BlackAndWhiteSnaable/DC-DC/Report/appendix/PCB.tex

\chapter{Full PCB Design}
\label{app:LTSpice}
\vspace{-15mm}
\begin{figure}[H]
	\centering
	
\end{figure}
