BlackAndWhiteSnaable/DC-DC/Report/appendix/Driver_circuits.tex

\chapter{Driver circuits}
\label{app:DRIVER}
\vspace{-8mm}
\section{Driver circuits IN}
\begin{figure}[H]
	\centering
	
\end{figure}
\clearpage 
\section{Driver circuits OUT}
\begin{figure}[H]
	\centering
	
\end{figure}
