BlackAndWhiteSnaable/DC-DC/Report/sections/colophon.tex

\thispagestyle{empty}
{\small
\strut\vfill % push the content to the bottom of the page
\noindent Copyright \copyright{} Aalborg University 2018\par
\vspace{0.2cm}
\noindent \LaTeX \: was used for typesetting this report,
MatLab, Simulink, EAGLE and LTSpice were used for designing and verifying the converter and
GitHub for collaborating as a group.
}
\clearpage
