BlackAndWhiteSnaable/DC-DC/Report/sections/titlepages.tex

\pdfbookmark[0]{Abstract and Information}{label:titlepage_en}
\aautitlepage{%
  \englishprojectinfo{
    %title 
    Non-inverting Multilevel\\
    DC-DC Boost Converter For\\
    Photovoltaic Applications
  }{%
    Signal Processing%theme
  }{%
    Fall Semester 2018 %project period
  }{%
    ED5-3-F18 % project group %TODO
  }{%
    %list of group members
    Daniel Frederik Busemann\\
    Ilian Oleg Haralampiev\\
    Ivan Petrov Kulin\\
    Simon Thies
  }{%
    %ls
    Sanjeevikumar Padmanaban
  }{%
    1 % number of printed copies
  }{%
    \today % date of completion
  }%
}{%department and address
  \textbf{Electronics and Computer Engineering}\\
  Aalborg University\\
  \href{http://www.aau.dk}{http://www.aau.dk}
}{% the abstract
	This report focuses on developing and testing a suitable DC-DC converter for PV applications.
	
	The main goal is to analyse, simulate and compare different topologies and choose the most efficient one. The chosen topology has been tested in hardware as well, to determine its real world viability and how accurate simulations are compared to real measurements.
	The topology chosen has gain 6 times higher on all duty ratios compared to the conventional boost converter. 

	For simulation the tools used are SIMULINK and LTSpice. For the hardware test a custom PCB has been designed and printed with a SKYPER driver board being used to operate the circuit.
	
}
\cleardoublepage
