BlackAndWhiteSnaable/DC-DC/Report/sections/frontpage.tex

\newcommand{\HRule}{\rule{\linewidth}{0.5 mm}}
\begin{titlepage}

\begin{center}
% Upper part of the page
\iflanguage{danish}{%
	
}{%
	
}\\[0.5cm]

\textsc{\Large P5}\\[0.6cm]

% Title
\HRule \\[0.8cm]
{ \Huge \bfseries  Non-inverting Multilevel DC-DC Boost Converter}\\[0.4cm]

  \Large{For Photovoltaic Applications
  % insert your subtitle here
  }
\HRule \\[1.2cm]

% Author and supervisor
\begin{minipage}{0.49\textwidth}
\begin{flushleft} \large
\emph{Students:}\\
Danial Frederik Busemann\\
Ilian Oleg Haralampiev\\
Ivan Petrov Kulin\\
Simon Thies\\
\end{flushleft}
\end{minipage}
\begin{minipage}{0.49\textwidth}
\begin{flushright} \large
\emph{Supervisors:} \\
Sanjeevikumar Padmanaban
\end{flushright}
\end{minipage}

\vfill

% Bottom of the page
{\large \today}

\end{center}

\end{titlepage}
