BlackAndWhiteSnaable/DC-DC/Report/sections/content/01introduction.tex

\chapter{Introduction}\label{ch:introduction}

As the global interest in renewable energy increases,
the interest in photo voltaic (PV) arrays grows as well. 
Solar power is a growing source of renewable energy on a global scale \cite{Timetosh94:online}
This can be indicated by the growing interest power companies show in building PV parks. 
\cite{GSR2018:online}

When generating power with PV arrays,
the initial output is a DC power of varying voltage levels. 
To be able to input the generated power into the stable AC-grid,
without creating disturbances,
the same voltage and frequency as the grid needs to be output. 

\begin{figure}[H]
   \centering
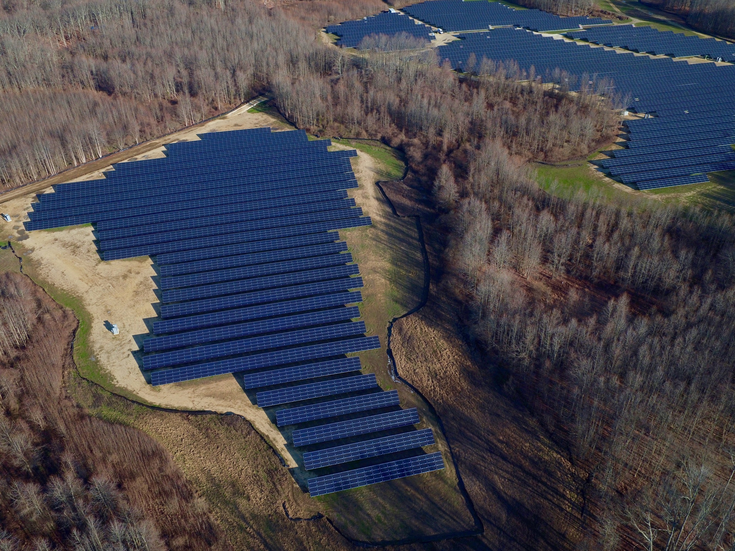
[picture p1: Report/figures/Problem/solarpark.jpg]
   
    \caption{12.8 MW Utility Project - the World's Largest Bifacial PV Installation in Eastern US \cite{Sunpreme29:online}}
	\label{fig:SolarPark}
\end{figure}
Commonly this is achieved by two devices,
a DC-DC boost converter (BC) to normalize the voltage
and an DC-AC inverter to generate AC power with the necessary frequency.

In this project we have a look at DC-DC boost converters.
The first part of the project is understanding and simulating common topologies.
The second part is understanding, simulating and building a new topology,
the 2NX Interleaved Boost Converter. \cite{Bhaskar2016}

\section*{Reading Guide}
For readers without an understanding of DC-DC converters,
it is recommended to read Chapter \ref{ch:CBC},
before reading the Chapters \ref{ch:SIBC}-\ref{ch:2Nx}
as these require a deeper understanding.
