BlackAndWhiteSnaable/DC-DC/Report/sections/content/aconventionalBoost.tex

\chapter{Conventional Boost Converter}\label{ch:CBC}
\todo[color=c01]{move this chapter to a section in physical setup}

\section{Switch ON}\label{sec:SON}

When the switch is ON, the inductor is being charged and the capacitor discharches over the load resistor.
