BlackAndWhiteSnaable/DC-DC/Report/sections/content/05Implementation/bDriverSkyper.tex

\vspace{-8mm}
\section{Driver}\label{sec:driver}
\vspace{-3mm}
To control the MOSFETs the Semikron SKYPER 32R driver board has been chosen. \cite{Board1SK17:online} It can run two MOSFETs or IGBTs potential free with up to 1200V over the device.
It supports an output of +15V/-7V PWM with peak currents to 15A at frequencies up to 50kHz.
The board also comes with additional protection logic that was not used as failure detection and shut down input.
The input to the board are two PWM signals coming from the controller with Voltages of 0 to 15V.
To function the SKYPER board needs an external power supply of 15V,
some decoupling capacitors and capacitors to filter high frequency pulses.
These components are on the adaptor board also from Semikron.

On the secondary side of the board the two potential free PWM signals with -7 to 15V are given out.\cite{SKYPER322:online}
To adjust the switching properties of the device the output can be configured by changing the resistors $R_{on}$ and $R_{off}$.
They limit the current when switching in the state, so the device will switch slower.
Additionally external decoupling capacitors are needed. They are also on the adaptor board.
The failure detection logic was not used for testing.
A schematic of the secondary side of the SKYPER board can be seen in Figure \ref{fig:Skyper32out}.

\begin{figure}[H]
   \centering
   
    \caption{Circuit on the output of the SKYPER 32R}
	\label{fig:Skyper32out}
\end{figure}
\clearpage
As the SKYPER Board needs an input signal of 15V a circuit is needed to convert the 5V signal from the low power logic.
Therefore a small op-amp based comparator circuit was constructed.
It compares the input signal to 1.5 Volts, so every input above will result in a high output,
all inputs below as low.
This also allows to run it from a logic that only outputs 3V signals.

In Figure \ref{fig:Skyper32in} it can be seen how the input coming from the control logic with a 5V PWM signal and 15V power supply are connected to the amplification board.
On there the signal gets raised to 15V PWM and the board also includes the pull-up resistor to read out the open collector error out pin of the SKYPER 32R.
The board connects to the adaptor board that has the required capacitors and a pull up resistor for the error in.
The adaptor board is connected to all the inputs of the SKYPER 32R.

\begin{figure}[H]
   \centering
   
    \caption{Input boards for the SKYPER 32R}
	\label{fig:Skyper32in}
\end{figure}
The SKYPER board is intended for IGBT bridge circuits and therefore has a function which switches both devices off, if the input tries to turn them both on.\cite{SKYPER322:online} Therefore a second identical circuit and board will be used to drive each of the MOSFETs.

\clearpage
