BlackAndWhiteSnaable/DC-DC/Report/sections/content/04Development/aConventionalBoost.tex

\section{Conventional Boost Converter}\label{ch:CBC}
\subsection{Principle of operation}\label{sec:CBC_POC}

The conventional boost converter uses one inductor,
one switch and one capacitor. When the switch is closed, the inductor current rises and energy is stored in the inductor L. When the switch is open, the inductor discharges through diode D and the inductor current falls. It steps up the voltage when
the switch is in OFF state. The two modes of operation will be discussed in this chapter. The circuit can be observed on figure~\ref{fig:CBC}. All the calculations in this chapter are based on \cite{Hart2010}.

\begin{figure}[H]
   \centering
   
    \caption{Conventional Boost Converter}
	\label{fig:CBC}
\end{figure}

\subsection{Operation Modes}\label{sec:CBC_OP}

\subsubsection{Switch ON (Figure~\ref{fig:CBC_ON}):}

When the switch is ON,
the inductor is being charged and the capacitor discharges over the load resistor.

\begin{figure}[H]
   \centering
   
    \caption{Conventional Boost Converter Switch ON}
	\label{fig:CBC_ON}
\end{figure}

In this case we have:
\begin{equation}
	V_L = V_{in}
	\label{eq:CBC_SWON1}
\end{equation}
where
\begin{equation}
	V_L = L \frac{di}{dt}
	\label{eq:CBC_SWON2}
\end{equation}
and
\begin{equation}
	V_C = V_R
	\label{eq:CBC_SWON3}
\end{equation}
The capacitor current discharges over the resistor:
\begin{equation}
	i_C = -\frac{V_o}{R}
	\label{eq:CBC_SWON4}
\end{equation}
\subsubsection{Switch OFF (Figure ~\ref{fig:CBC_OFF}):}

\begin{figure}[H]
   \centering
   
    \caption{Conventional Boost Converter Switch OFF}
	\label{fig:CBC_OFF}
\end{figure}

When the switch is OFF,
the capacitor is being charged and this is the mode when the boosting happens.

In this case we have:
\begin{equation}
	V_L = V_{in} - V_o
	\label{eq:CBC_SWOFF1}
\end{equation}

\begin{equation}
	i_C = i_L -\frac{V_o}{R}
	\label{eq:CBC_SWOFF2}
\end{equation}

\begin{figure}[H]
   \centering
   
    \caption{CBC Inductor Wave Forms}
	\label{fig:CBC_InductorWaveForms}
\end{figure}

\subsection{Conversion ratio}\label{sec:conversionRatio}

Based on inductor volt-second balance, the conversion ratio can be calculated:

\begin{equation}
	\int_{0}^{T_s} v_L(t)dt = V_{in}D + (V_{in}-V_{out})(1-D) = 0
	\label{eq:CBC_VISB}
\end{equation}

\begin{equation}
	\frac{V_o}{V_{in}} = \frac{1}{1-D}
	\label{eq:CBC_CR}
\end{equation}

\subsection{Inductor current ripple}\label{sec:CBC_ICR}

The inductor current slope for the interval from 0 to $DT_s$ can be found as:

\begin{figure}[H]
   \centering
   
    \caption{CBC Inductor Current Ripple}
	\label{fig:CBC_InductorCurrent}
\end{figure}

\begin{equation}
	\frac{di_L(t)}{dt} = \frac{v_L(t)}{L} = \frac{V_{in}}{L}
	\label{eq:CBC_ICR1}
\end{equation}

and the current slope for the interval (1 - DTs):

\begin{equation}
	\frac{di_L(t)}{dt} = \frac{v_L(t)}{L} = \frac{V_{in} - V}{L}
	\label{eq:CBC_ICR2}
\end{equation}

The change of inductor current during the first subinterval is:

\begin{equation}
	2\Delta i_L = \frac{V_{in}}{L}DT_s \Rightarrow
  \Delta i_L = \frac{V_{in}}{2L}DT_s
	\label{eq:CBC_ICR3}
\end{equation}

The inductor should be chosen such that a desired current ripple magnitude is optained.

\subsection{Capacitor voltage ripple}\label{sec:CBC_CVR}

\begin{figure}[H]
   \centering
   
    \caption{Capacitor Voltage Ripple}
	\label{fig:CBC_CVR1}
\end{figure}

The capacitor voltage slope for the interval from 0 to DTs can be found as:

\begin{equation}
	\frac{dv_c(t)}{dt} = \frac{i_c(t)}{C} = \frac{-V}{RC}
	\label{eq:CBC_CVR2}
\end{equation}

and the voltage slope for the interval (1 - DTs):

\begin{equation}
	\frac{dv_c(t)}{dt} = \frac{i_c(t)}{C} = \frac{I}{C} - \frac{V}{RC}
	\label{eq:CBC_CVR3}
\end{equation}

The change of capacitor voltage during the first subinterval is:

\begin{equation}
	-2\Delta v = \frac{-V}{RC}DT_s \Rightarrow
  \Delta v = \frac{V}{2RC}DT_s
	\label{eq:CBC_CVR4}
\end{equation}

The capacitor should be chosen according to the desired voltage ripple.

\subsection{Design Example}\label{sec:CBC_DE}

If we consider a design for a boost converter that will have an output of 25V from a 10V source, with a continuous inductor current and an output voltage of less than one percent, we will have the following parameters:\\
V\textsubscript{in} = 10 V, V\textsubscript{out} = 25 V and D = 0.6. Also,
a load resistor of 40 $\Omega$ and a  switching frequency of 25kHz are considered for the design.

By the fact that the average power supplied by the source must be the same as the average power absorbed by the load resistor, the output power can be obtained by:

\begin{equation}
	P_o = \frac{V^2_o}{R} = V_oI_o
	\label{eq:CBC_CVR4}
\end{equation}

and the input power is $V_{in}I_s = V_{in}I_L$

\begin{equation}
	\Rightarrow V_{in}I_L = \frac{V^2_o}{R} = \frac{[V_{in}/(1-D)]^2}{R}
	\label{eq:CBC_CVR4}
\end{equation}

solving for I\textsubscript{L}, we get:

\begin{equation}
	I_L = \frac{V_{in}}{(1-D)^2R}
	\label{eq:CBC_CVR4}
\end{equation}

The maximum and minimum inductor current can be determined by:

\begin{equation}
	I_{max} = I_L + \Delta i_L = \frac{V_{in}}{(1-D)^2R} + \frac{V_{in}DT_s}{2L}
	\label{eq:CBC_CVR4}
\end{equation}

\begin{equation}
	I_{min} = I_L - \Delta i_L = \frac{V_{in}}{(1-D)^2R} - \frac{V_{in}DT_s}{2L}
	\label{eq:CBC_CVR4}
\end{equation}

The induction current has to be continuous, so it has to be always positive. This means that I\textsubscript{L} has to be positive and the boundary between continuous and discontinuous inductor current is determined from:\\
\begin{equation}
	I_{min} = 0 = \frac{V_{in}}{(1-D)^2R} - \frac{V_{in}DT_s}{2L}
\end{equation}

\begin{equation}
	\frac{V_{in}}{(1-D)^2R} = \frac{V_{in}DT_s}{2L} = \frac{V_{in}D}{2Lf}
\end{equation}

So, the minimum combination of inductance and switching frequency for continuous current is:

\begin{equation}
L_{min} = \frac{D(1-D)^2R}{2f} = \frac{0.6(1-0.6)^2 40}{2\cdot25000} = 76.8\mu F
\end{equation}

L = 120 $\mu$F is selected to provide a margin to ensure continuous current.
Then, using Equation~\ref{eq:CBC_CVR4}, we can find the average inductor current.

\begin{equation}
I_L = \frac{V_{in}}{(1-D)^2R} = \frac{10}{(1-0.6)^2(40)} = 1.56 A
\end{equation}\\
Afterwards, the current ripple according to Figure~\ref{fig:CBC_InductorCurrent} is calculated using Equation~\ref{eq:CBC_CVR3}

\begin{equation}
\Delta i_L = \frac{V_{in}DT}{2L} = \frac{10\cdot 0.6}{2\cdot 100\cdot 10^{-6}\cdot 25000} = 1 A
\end{equation}\\
$I_{max} = 1.56 + 1 = 2.56 A$ , 
$I_{min} = 1.56 - 1 = 0.56 A$

Based on equation ~\ref{eq:CBC_CVR4}, the minimum capacitance required to limit the output voltage ripple to 1 percent is:

\begin{equation}
C_{min} = \frac{D}{R(\Delta V_o/V)f} = \frac{0.6}{40\cdot 0.01\cdot 25000 } = 60\mu F
\end{equation}\\
A capacitor of 80 $\mu$ F was chosen to provide a satisfactory margin.\\

To confirm the calculations, the circuit was built in SIMULINK, using the calculated parameters presented on Table~\ref{tab:CBC}.

\begin{table}[H]
\begin{center}
\caption {Simulation parameters for CBC} \label{tab:CBC} 
\begin{tabular}{|l|l|}
\cline{1-2}
\textbf{Parameter} & \textbf{Value}  \\ \cline{1-2}
Input Voltage $V_{in}$          &      10V   \\ \cline{1-2}
Load(R)   & 40$\Omega$           \\ \cline{1-2}
Capacitance(C)          &       80$\mu$F     \\ \cline{1-2}
Inductance(L)          &      120$\mu$H      \\ \cline{1-2}
Duty cycle(D)          &     0.6       \\ \cline{1-2}
Switching Frequency($f$)          &      25kHz      \\ \cline{1-2}
\end{tabular}
\end{center}
\end{table}
\vspace{-8mm}
The simulation presented on Figure~\ref{fig:CBC_Sim} is using an ideal switch for the active device.
\vspace{-4mm}
\begin{figure}[H]
   \centering
   
    \caption{Conventional Boost Converter}
	\label{fig:CBC_Sim}
\end{figure}
\vspace{-4mm}
The results from the simulation are presented on Figure~\ref{fig:CBC_SimResults} and it can be observed that they match with the calculations. 

\begin{figure}[H]%
    \centering
    %\subfloat[Switch ON\label{SI_ON}]
    {{ }}%
    \qquad
    \subfloat{{ }}%  
    \caption{Simulation results}%
     \label{fig:CBC_SimResults}% 
\end{figure}
