BlackAndWhiteSnaable/DC-DC/Report/sections/content/04Development/yy2NxMultilevelBC.tex

\section{2Nx Interleaved Boost Converter}\label{ch:2Nx}

The final topology presented is the 2Nx Interleaved Boost Converter, which can be achieved by adding a Non-inverting Nx Multilevel BC with a negative Inverting Nx Multilevel BC as presented on Figure~\ref{fig:MBC_2NxDiagram}.\cite{Bhaskar2016}

\begin{figure}[H]
   \centering
   
    \caption{2Nx Interleaved Boost Converter Diagram}
	\label{fig:MBC_2NxDiagram}
\end{figure}

\subsubsection{Principle of operation}

The 2Nx Interleaved Boost Converter works in a similar way as the Non-inverting Nx and Inverting Nx Multilevel Boost Converters presented in Sections~\ref{ch:MBC} and~\ref{ch:IMBC} respectively. As the two topologies are combined, the voltage gain is increased two times.

The corresponding schematic of the Non-inverting 2Nx Interleaved Boost Converter can be observed on Figure~\ref{fig:MBC_2NxSchematic}. This topology requires 4N - 1 capacitors, 4N - 1 diodes, 2 inductors and 2 switches. Higher number of levels can be achieved by adding additional capacitors and diodes as presented on the schematic in order to increase the voltage gain.\cite{Bhaskar2016}

\begin{figure}[H]
   \centering
   
    \caption{2Nx Interleaved Boost Converter Schematic}
	\label{fig:MBC_2NxSchematic}
\end{figure}

\subsubsection{Conversion ratio}

As the 2Nx Interleaved Boost Converter is a combination of Non-inverting and Inverting Multilevel Boost Converters, we have $\frac{N}{1-D}$ for the top part and $\frac{N}{1-D}$ for the bottom part of the schematic, which means that the total output-input voltage ratio is:

\begin{equation}
	\frac{V_o}{V_{in}} = \frac{2N}{(1-D)}
	\label{eq:MBC_2NxCR}
\end{equation}

\subsubsection{Simulation}

In order to verify that the conversion ratio is correct,
the topology was built on Simulink. 
Again, the same parameters for the components were used as the other topologies as observed on Table~\ref{tab:MBC_2Nx}.

\begin{table}[H]
\begin{center}
\caption {Simulation parameters for MBC} \label{tab:MBC_2Nx} 
\begin{tabular}{|l|l|}
\cline{1-2}
\textbf{Parameter} & \textbf{Value}  \\ \cline{1-2}
Input Voltage $V_{in}$          &      10V   \\ \cline{1-2}
Load(R)   & 225$\Omega$           \\ \cline{1-2}
Capacitance(C)          &       220$\mu$F     \\ \cline{1-2}
Inductance(L)          &      150$\mu$H      \\ \cline{1-2}
Duty cycle(D)          &     0.6       \\ \cline{1-2}
Switching Frequency($f$)          &      50kHz      \\ \cline{1-2}
\end{tabular}
\end{center}
\end{table} 
\vspace{-8mm}
For a 6 level Boost Converter with a duty cycle of 0.6, the expected voltage output gain based on Equation \ref{eq:MBC_2NxCR} is:
\begin{equation}
	V_o = \frac{2\cdot N}{1-D}V_{in} = \frac{6}{1-D}  = 15V_{in}=150V
\end{equation}
We can see that the simulation result verifies the calculated conversion ratio on Figure~\ref{fig:MBC_2NxSimResult}.\\
\vspace{-8mm}
\begin{figure}[H]
   \centering
   
    \caption{2Nx Interleaved Boost Converter Voltage Output}
	\label{fig:MBC_2NxSimResult}
\end{figure}
\clearpage

\section{Comparison verdict}\label{ch:VERD}

Overall, based on the different converter gains at different duty cycles on Table \ref{tab:2NX_Overall}, which is also illustrated graphically on Figure \ref{fig:2Nx_Overall_Graph}, we can conclude that the 2Nx Interleaved Boost Converter provides highest voltage gain at the required duty cycle of 0.6. The fact that the gain can be further increased by adding another level, makes the converter most favourable to satisfy the set requirements at Section \ref{sec:req}. 

\begin{table}[H]
\begin{center}
\caption {Voltage Gain of Converters at Various Duty Cycle} \label{tab:2NX_Overall} 
\begin{tabular}{|l|l|l|l|l|l|l|l|l|l|}
\hline
\textbf{Converter type} & \textbf{0.1} & \textbf{0.2} & \textbf{0.3} & \textbf{0.4} & \textbf{0.5} & \textbf{0.6} & \textbf{0.7} & \textbf{0.8} & \textbf{0.9} \\ \hline
Conventional BC        &      1.11   &      1.25   &   1.43   &      1.67   &      2.00    &      2.50  &      3.33   &     5.00  &   10 \\ \hline
Switched Inductor   & 1.22      &      1.50   &      1.86   &      2.33   &     3.00    &     4.00    &      5.67     &    9.00   &      19\\ \hline
Single Switch Quad.        &       1.23     &      1.56      &      2.04   &      2.78   &      4.00   &      6.25   &      11.11   &      25.00   &      100 \\ \hline
Conv. Three Level          & 1.11   &      1.25   &   1.43   &      1.67   &      2.00    &      2.50  &      3.33   &     5.0  &   10\\ \hline
3x Multilevel         &     3.33       &      3.75   &     4.285   &      5   &      6   &      7.5   &      10   &      20   &      30   \\ \hline
6x Interleaved         &     6.66       &      7.5   &      8.57   &      10   &      12   &      15   &      20   &      30   &      60   \\ \hline
\end{tabular}
\end{center}
\end{table}

\begin{figure}[H]
   \centering
   
    \caption{Comparison of the gains of the analysed topologies}
	\label{fig:2Nx_Overall_Graph}
\end{figure}
\clearpage
