BlackAndWhiteSnaable/DC-DC/Inverter/Report/sections/content/03problemDefinition.tex

\chapter{Problem Definition}\label{ch:probdesc}
\todo[color=c03,inline]{Problem Definition}
The focus will be investigating an advanced boost topology that has a higher conversion ratio while still being compact and not using too many or too high rated components.

%Boosting DC power
%cheap
%size

\section{Requirements}
