BlackAndWhiteSnaable/DC-DC/Inverter/Report/sections/content/04Development/cSingleSwitchQuadraticBC.tex

\section{Single Switch Quadratic Boost Converter}\label{ch:SSQBC}

The single switch quadratic boost converter is another variation of the already covered conventional boost converter. Like the SIBC, it only adds passive components to the circuit to achieve higher ration between output and input voltage. 

\subsection{Additions from Conventional BC}
In the SSQBC,
another inductor capacitor pair is added, as well as two additional diodes, connected as shown in Figure \ref{fig:SSQBC}. This creates an extra loop similar to the one in a convetional boost converter, therefore the topology is named quadratic. This will be proven mathematically in the following few sections.

\begin{figure} [H]
   \centering
   
    \caption{Single Switch Quadratic Boost Converter circuit}
	\label{fig:SSQBC}
\end{figure}
\subsection{Switching States}
The same switching scheme as for the Conventional BC can be used,
as mentioned earlier. We assume the sizes of all inductors and capacitors is equal.
The equivalent circuits during the on and off stages are shown in Figure \ref{fig:SSQBC_States}.

\begin{figure}[H]%
    \centering
    \subfloat[Switch ON\label{SSQBC_ON}]
    {{ }}%
    \qquad
    \subfloat[Switch OFF\label{SSQBC_OFF}]{{ }}%  
    \caption{Switching states of the SIBC}%
     \label{fig:SSQBC_States}% 
\end{figure}

\subsubsection{ON State}
While the switch is ON, diodes D\textsubscript{2} and D\textsubscript{3} are forward biased and diode D\textsubscript{1} is reverse biased.
This allows in voltage source to charge the inductor L\textsubscript{1} and for capacitor C\textsubscript{1} to discharge over L\textsubscript{2}, as seen in Figure \ref{SSQBC_ON}.
\\*
In this case, we can use KVL to build the eqations for inductor voltages: 

\begin{equation}
	V_{L_1}=V_{in}
	\label{eq:SSQBC_KVL_ON}
\end{equation}

\begin{equation}
	V_{L_2}=V_{C_1}
	\label{eq:SSQBC_KVL_ON2}
\end{equation}

\subsubsection{OFF State}
While the switch is OFF, the complete opposite happens, where only D\textsubscript{2} remains reverse biased, as seen on Figure \ref{SSQBC_OFF}).
In a configuration like this two loop are formed on the two sides of C\textsubscript{1}. Again using KVL the following eqations areas seen on Figure \ref{SSQBC_OFF}). formed for the inductor voltages:

\begin{equation}
	V_{L_1}=V_{in}-V_{C_1}
	\label{eq:SSQBC_KVL_OFF}
\end{equation}

\begin{equation}
	V_{L_2}=V_{C_1}-V_{o}
	\label{eq:SSQBC_KVL_OFF2}
\end{equation}

Again using the Inductor voltage-second balance, we can find the output-input relationship, only this time we form two separate equations for the two inductors. 

\begin{equation}
	V_{L_1(ON)}D+V_{L_1(OFF)}(1-D)=0
	\label{eq:SSQBC_IVSB}
\end{equation}

\begin{equation}
	V_{L_2(ON)}D+V_{L_2(OFF)}(1-D)=0
	\label{eq:SSQBC_IVSB2}
\end{equation}

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

\todo[color=c04,inline]{Add simulation results}
\begin{figure} [H]
   \centering
   
    \caption{Single Switch Quadratic Boost Converter circuit}
	\label{fig:SSQBC}
\end{figure}
