BlackAndWhiteSnaable/DC-DC/Inverter/Report/sections/content/04Development/fBootstrapCapacitorAndBoostInductor.tex

\section{Bootstrap Capacitor and Boost Inductor BC}\label{ch:BCBIBC}
