BlackAndWhiteSnaable/DC-DC/Hardware/Modified SEPIC cum Boost Converter.docx

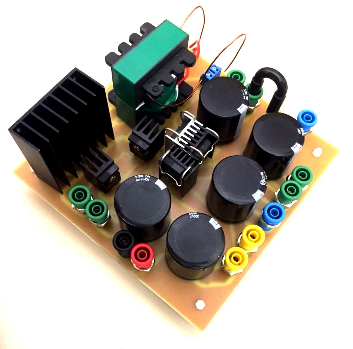
[picture p2: figure]
DC DC
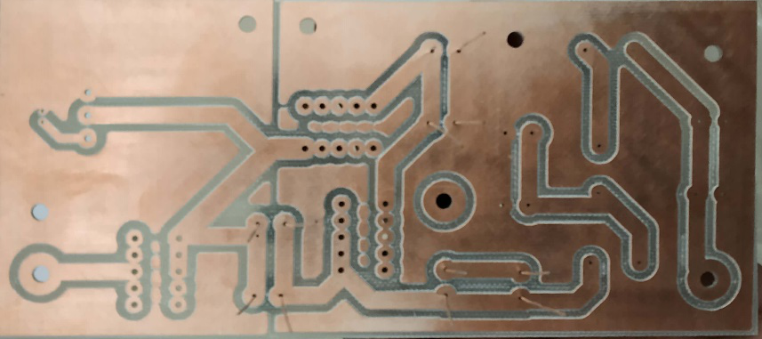
[picture p3: figure]

Components

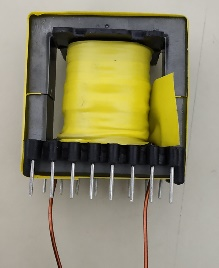
[picture p4: figure]

Inductor (L1, L2 and L3) 100 μH, 15 A

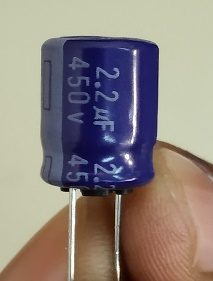
[picture p5: figure]

Capacitor (C1, C2 and C3) 2.2 μF, 450 V (two capacitor connected in parallel to achieve 5 μF)

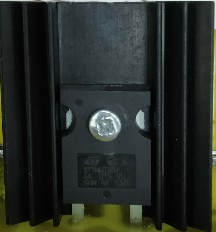
[picture p6: figure]

Diodes (D1, D2 and D3) (STTH6012W) (1200 V, 60 A)

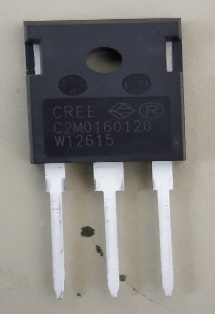
[picture p7: figure]

Silicon Carbide Power MOSFET (C2M0160120D) VDS: 1200 V ID: 19 A RDS(on): 160 mΩ

Banana caps as terminal (low resistance) for connecting DC supply and load.

Hardware Implementation of Inverting Nx Converter for Three levels (15 V to -105 V conversions with 100W)

Power Circuitry:

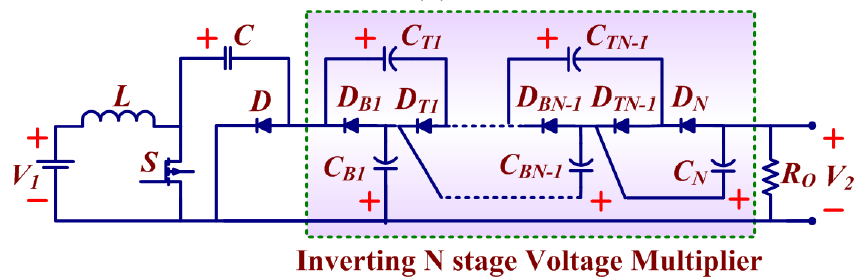
[picture p8: figure]

Hardware Implementation:

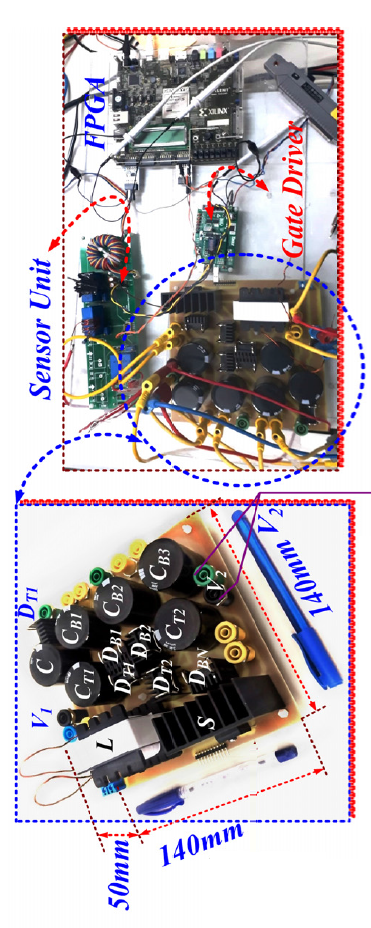
[picture p9: figure]

1) Inductor (L)

Core type inductor is designed by self. The inductance rating is in between 100uH to 200uH and 10A copper wire is used. Prototype is tested at 100uH by adjusting the turns.

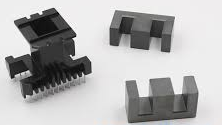
[picture p10: figure]

2) Capacitors: Electrolyte Type- 330uF, 450V

(Higher voltage rating is used for future investigation)

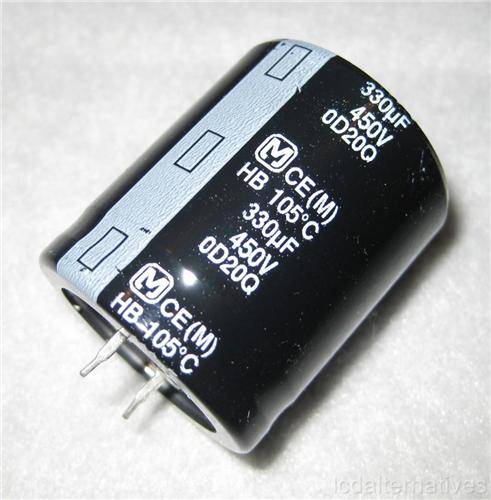
[picture p11: figure]
Image result for 330uF, 450V

3) Diodes

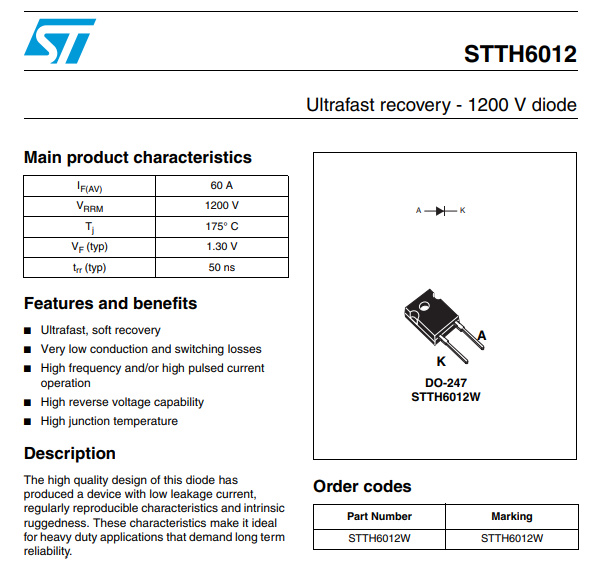
[picture p12: figure]

Datasheet: https://www.st.com/resource/en/datasheet/stth6012.pdf

4) Silicon Carbide Power MOSFET (C2M0160120D)

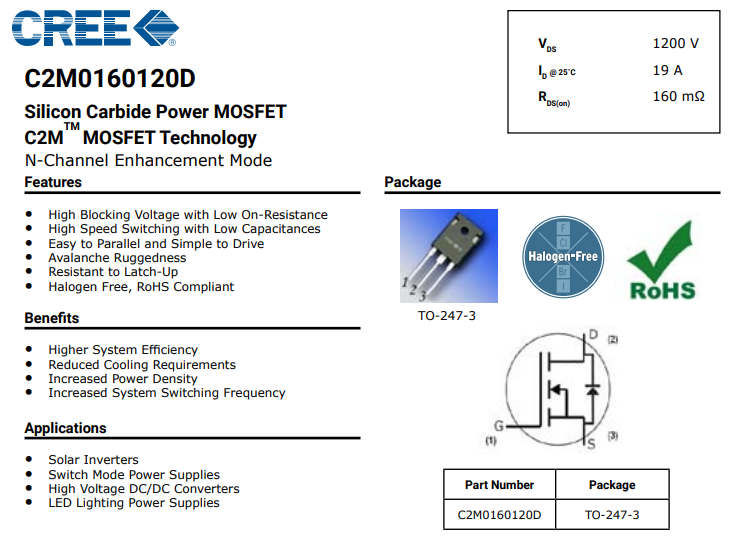
[picture p13: figure]

Datasheet: https://www.wolfspeed.com/media/downloads/169/C2M0160120D.pdf

5) FPGA- Virtex 5 is used to generate Control Pulses along with sensor.
6) Gate Driver: Made by Taraz Technologies (GDA Advanced Series) More detial avaiblae on https://www.taraztechnologies.com/products/power-electronics-modules/gate-driver-boards/
7) Heat Sink –Flat Type

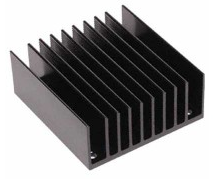
[picture p14: figure]
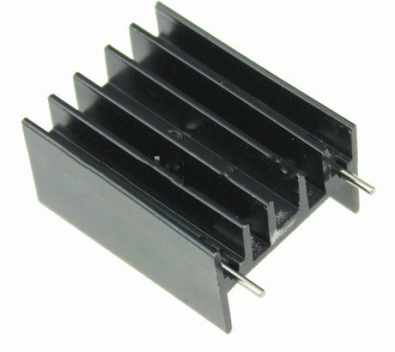
[picture p15: figure]

Used for MOSFET Used for Diode

http://www.lpkfusa.com/datasheets/prototyping/s62.pdf
