BlackAndWhiteSnaable/DC-DC/Report/figures/aConventionalBoost/CapacitorVoltage.pdf

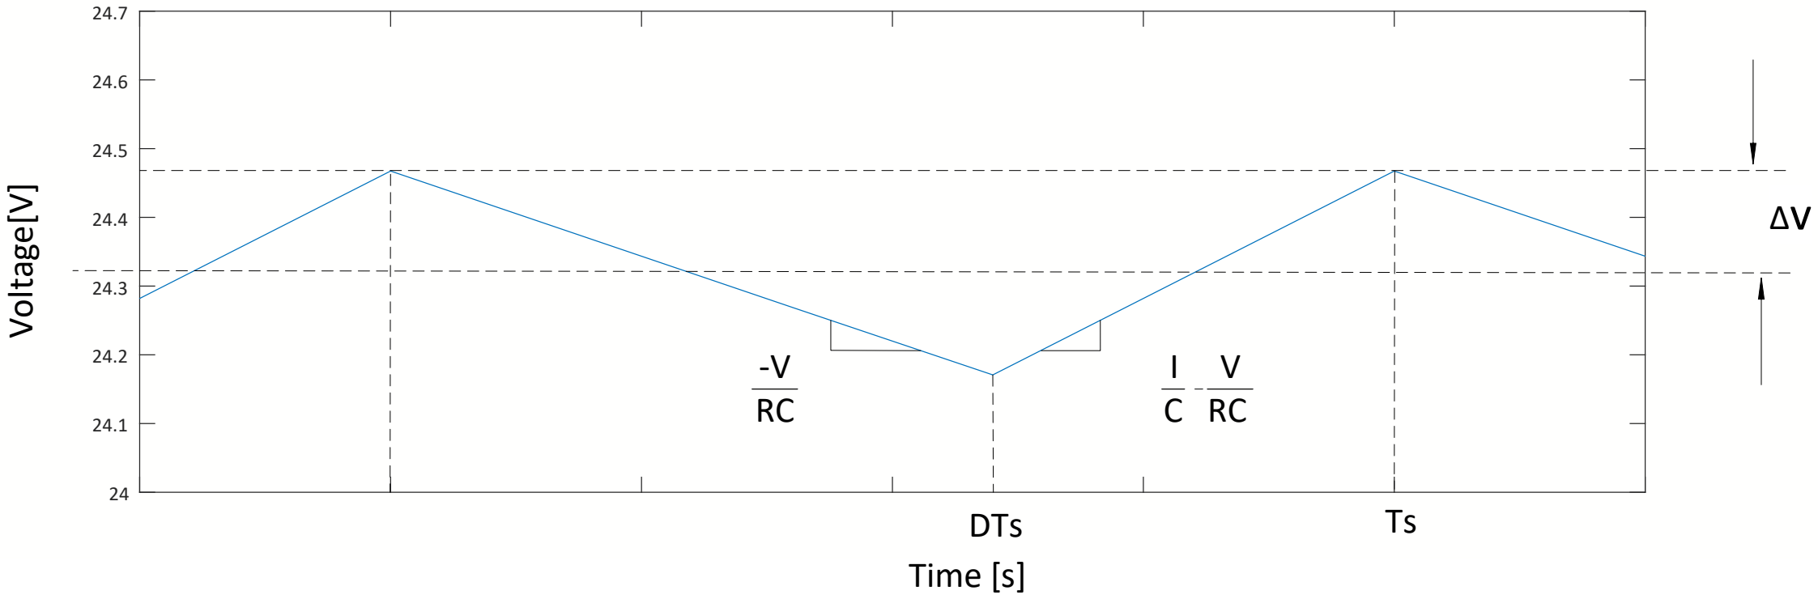
[picture p16: page 1]

24

24.1

24.2

24.3

24.4

24.5

24.6

24.7

24

24.1

24.2

24.3

24.4

24.5

24.6

24.7

V
RC

I V

# C RC

Δ

v

DTs | Ts

# Time [s]

# Voltage[V]
