BlackAndWhiteSnaable/DC-DC/Report/figures/aConventionalBoost/InductorCurrent.pdf

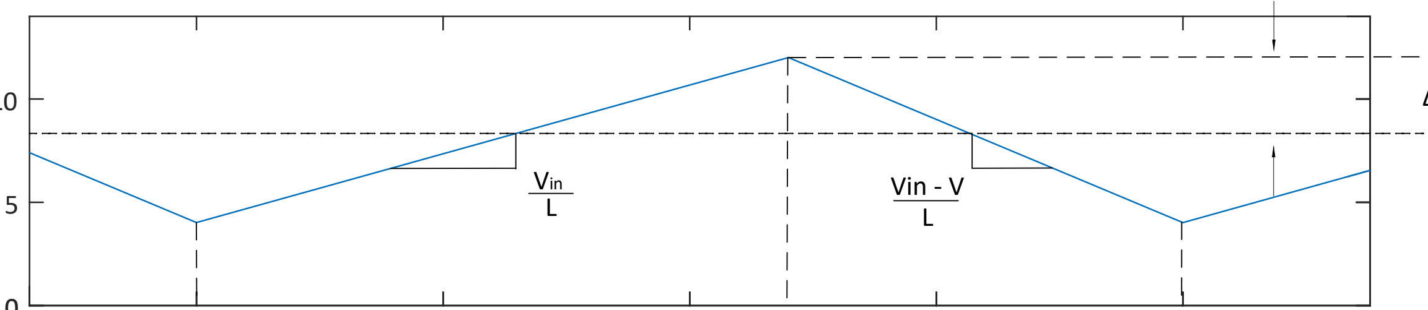
[picture p17: figure]
Vin L; Vin - V L

0

10

### Current [A]

ΔiL

DTs | Ts

### Time [s]
