BlackAndWhiteSnaable/DC-DC/Report/figures/dConventionalThreeLevelBC/PWMGeneration.pdf

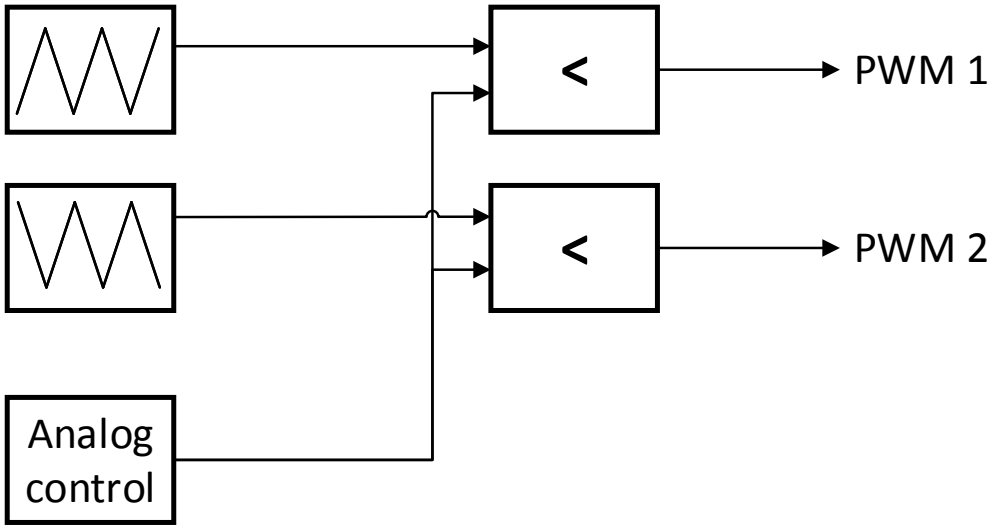
[picture p18: figure]
Analog control; PWM 1; PWM 2
