BlackAndWhiteSnaable/DC-DC/Report/P5.tex

%  A simple AAU report template.
%  2015-05-08 v. 1.2.0
%  Copyright 2010-2015 by Jesper Kjær Nielsen <jkn@es.aau.dk>
%
%  This is free software: you can redistribute it and/or modify
%  it under the terms of the GNU General Public License as published by
%  the Free Software Foundation, either version 3 of the License, or
%  (at your option) any later version.
%
%  This is distributed in the hope that it will be useful,
%  but WITHOUT ANY WARRANTY; without even the implied warranty of
%  MERCHANTABILITY or FITNESS FOR A PARTICULAR PURPOSE.  See the
%  GNU General Public License for more details.
%
%  You can find the GNU General Public License at <http://www.gnu.org/licenses/>.
%
\input{setup/preamble.tex}% package inclusion and set up of the document
\input{setup/hyphenations.tex}%
\input{setup/macros.tex}% my new macros

\begin{document}
%frontmatter
\pagestyle{empty} %disable headers and footers
\pagenumbering{roman} %use roman page numbering in the frontmatter
\input{sections/frontpage.tex}
\input{sections/colophon.tex}
\input{sections/titlepages.tex}
\cleardoublepage
\input{sections/preface.tex}
%\includepdf[pages=-]{sections/preface.pdf} %TODO this is where the signed page goes
\pdfbookmark[0]{Contents}{label:contents}
\pagestyle{fancy} %enable headers and footers again
\tableofcontents
\listoffigures
\clearpage

%mainmatter
\pagenumbering{arabic} %use arabic page numbering in the mainmatter
\input{sections/content/00nomenclature.tex}
\input{sections/content/01introduction.tex}
\input{sections/content/02problemDescription.tex}
\input{sections/content/03problemDefinition.tex}
\input{sections/content/04Development.tex}
\input{sections/content/05Implementation.tex}
%
%
%
\input{sections/content/06Testing.tex}
\input{sections/content/07Discussion.tex}
\input{sections/content/08Conclusion.tex}
\input{sections/content/09Perspective.tex}

\printbibliography[heading=bibintoc]
\label{bib:mybiblio}
\appendix
\input{appendix/LTSpice.tex}
\input{appendix/Driver_circuits.tex}
\input{appendix/PCB.tex}
\input{appendix/Results_graphs.tex}
\end{document}
