BlackAndWhiteSnaable/DC-DC/Report/sections/preface.tex

\chapter*{Preface\markboth{Preface}{Preface}}\label{ch:preface}
\addcontentsline{toc}{chapter}{Preface}
This report was made by four students from Aalborg University Esbjerg attending
the 5th semester of the Electronics and Computer Engineering Bachelor.
From this point on,
every mention of \textbf{we}, \textbf{the group} or \textbf{the authors} refers to the four co-authors listed below.

\vspace{\baselineskip}\hfill Aalborg University, \today
\vfill\noindent

\begin{center}
\begin{minipage}[b]{0.45\textwidth}
 \centering
 \rule{\textwidth}{0.5pt}\\
  Daniel Frederik Busemann\\
 {\footnotesize <dbusem16@student.aau.dk>}
\end{minipage}
\hfill
\begin{minipage}[b]{0.45\textwidth}
 \vspace{20mm}
 \centering
 \rule{\textwidth}{0.5pt}
    Ilian Oleg Haralampiev\\
 {\footnotesize <iharal16@student.aau.dk>}
\end{minipage}
\hfill
%
\begin{minipage}[b]{0.45\textwidth}
 \vspace{20mm}
 \centering
 \rule{\textwidth}{0.5pt}\\
    Ivan Petrov Kulin\\
 {\footnotesize <ikulin16@student.aau.dk>}
\end{minipage}
\hfill
\begin{minipage}[b]{0.45\textwidth}
 \vspace{20mm}
 \centering
 \rule{\textwidth}{0.5pt}
    Simon Thies\\
 {\footnotesize <sthies16@student.aau.dk>}
\end{minipage}
\hfill
\end{center}
