BlackAndWhiteSnaable/DC-DC/Report/figures/dConventionalThreeLevelBC/Vripple10Vin.pdf

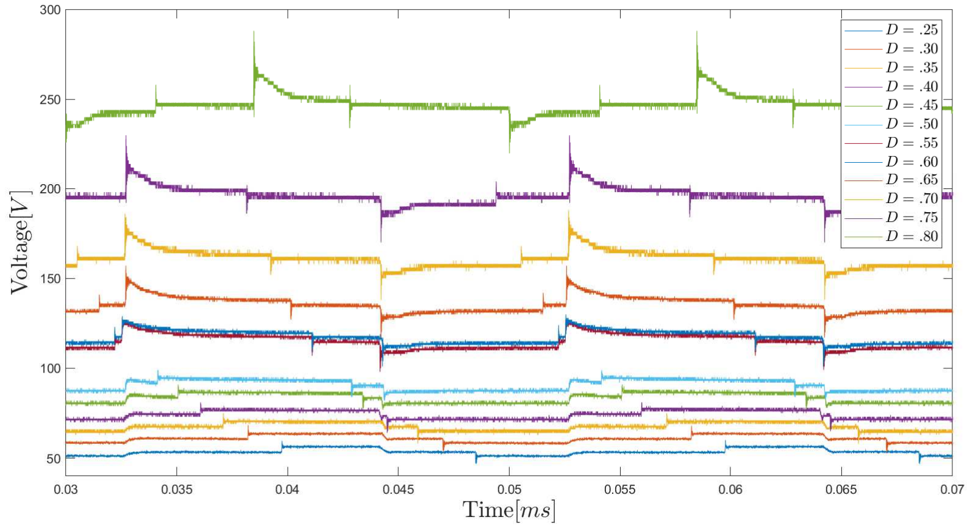
[picture p19: page 1]
