BlackAndWhiteSnaable/DC-DC/Report/figures/aConventionalBoost/ConventionalBoostConverter.pdf

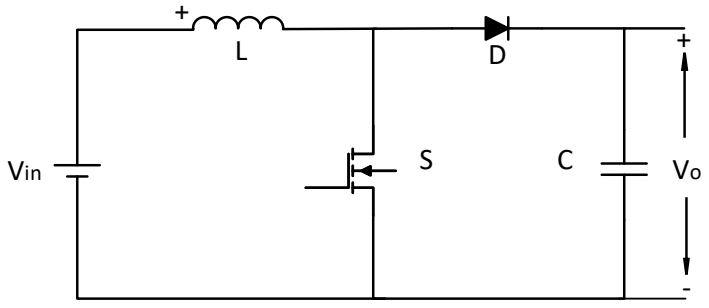
[picture p20: figure]
Vin
