BlackAndWhiteSnaable/DC-DC/Report/figures/aConventionalBoost/ConventionalBoostConverterOFF.pdf

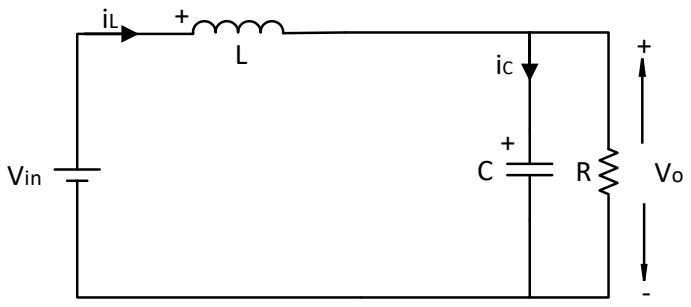
[picture p21: figure]
Vin
