BlackAndWhiteSnaable/DC-DC/Report/figures/aConventionalBoost/ConventionalBoostConverterON.pdf

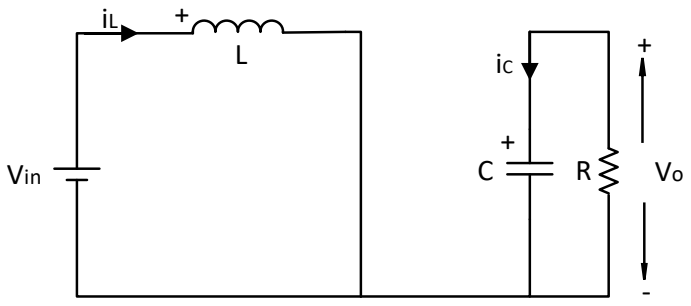
[picture p22: figure]
Vin
