BlackAndWhiteSnaable/DC-DC/Report/figures/bSwitchedInductor/Switched_inductorOFF.pdf

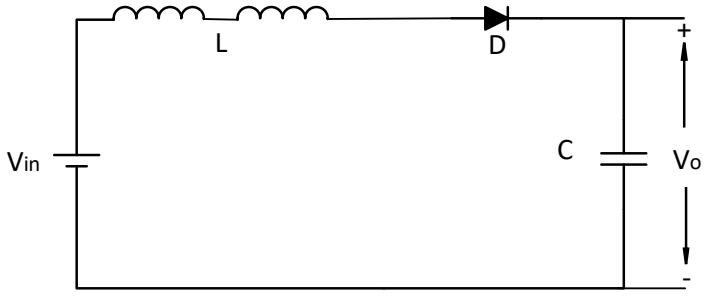
[picture p23: figure]
Vin
