BlackAndWhiteSnaable/DC-DC/Report/figures/bSwitchedInductor/Switched_inductorON.pdf

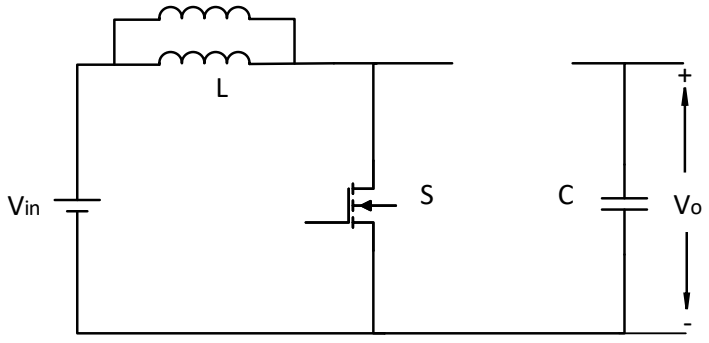
[picture p24: figure]
Vin
