BlackAndWhiteSnaable/DC-DC/Report/figures/dConventionalThreeLevelBC/PWMCompare.pdf

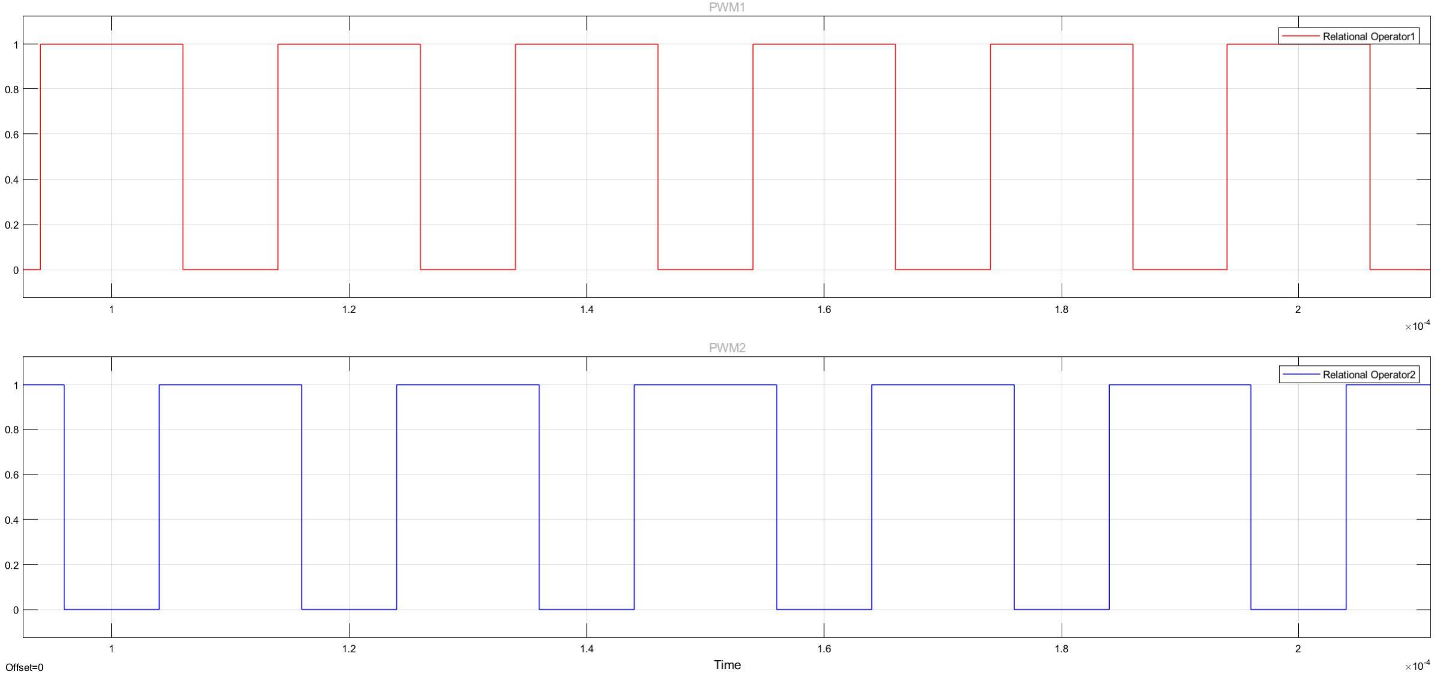
[picture p25: page 1]
