BlackAndWhiteSnaable/DC-DC/Report/figures/yMultiLevel/2Nx_Diagram.pdf

Non Inverting
Nx DC-DC
Multilevel
Boost Converter

=

Inverting
Nx DC-DC
Multilevel
Boost Converter

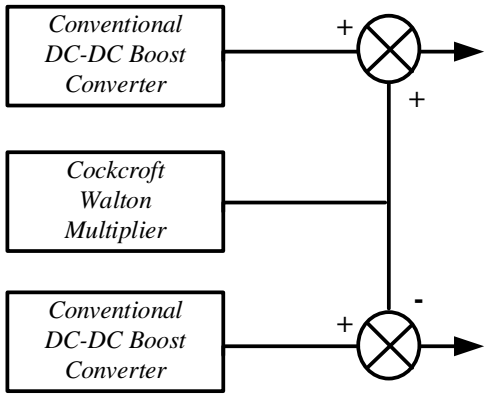
[picture p26: figure]
Conventional DC-DC Boost Converter; Cockcroft Walton Multiplier

=

+

=

Non Inverting
2Nx DC-DC
Interleaved
Boost Converter
