BlackAndWhiteSnaable/DC-DC/Report/figures/xCockroftWalton/1neg.pdf

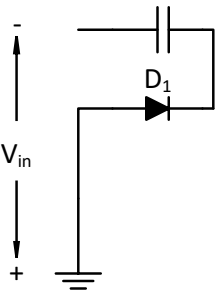
[picture p27: figure]
Vin

C1
