BlackAndWhiteSnaable/DC-DC/Report/figures/xCockroftWalton/2pos.pdf

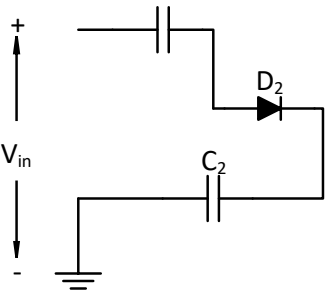
[picture p28: figure]
Vin

C1
