BlackAndWhiteSnaable/DC-DC/Report/figures/xCockroftWalton/3neg.pdf

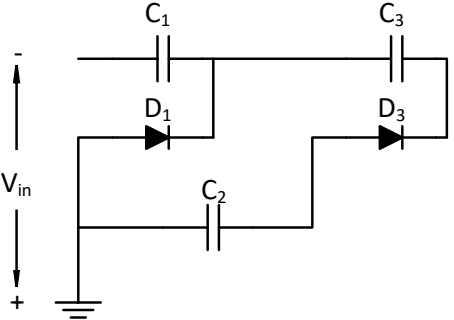
[picture p29: figure]
Vin
