BlackAndWhiteSnaable/DC-DC/Report/figures/xCockroftWalton/4pos.pdf

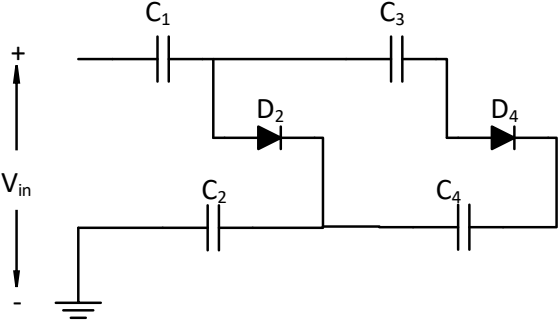
[picture p30: figure]
Vin
