BlackAndWhiteSnaable/DC-DC/Report/figures/xCockroftWalton/CockroftWalton_4pos.pdf

Vin
