BlackAndWhiteSnaable/DC-DC/Report/figures/yMultiLevel/InvertingNxDiagram.pdf

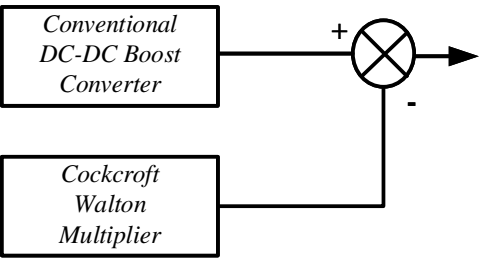
[picture p31: figure]
Conventional DC-DC Boost Converter; Cockcroft Walton Multiplier

Inverting
Nx DC-DC
Multilevel
Boost Converter

=

Inverting
Nx DC-DC
Multilevel
Boost Converter

=
