BlackAndWhiteSnaable/DC-DC/Report/figures/yMultiLevel/CW_CBCtoNx.pdf

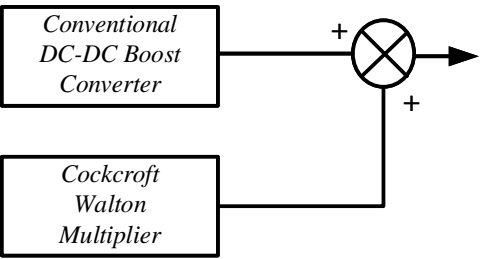
[picture p32: figure]
Conventional DC-DC Boost Converter; Cockcroft Walton Multiplier

Non Inverting
Nx DC-DC
Multilevel
Boost Converter

=

Non Inverting
Nx DC-DC
Multilevel
Boost Converter

=
