BlackAndWhiteSnaable/DC-DC/DipTrace/dip2eagle/EagleError.PNG

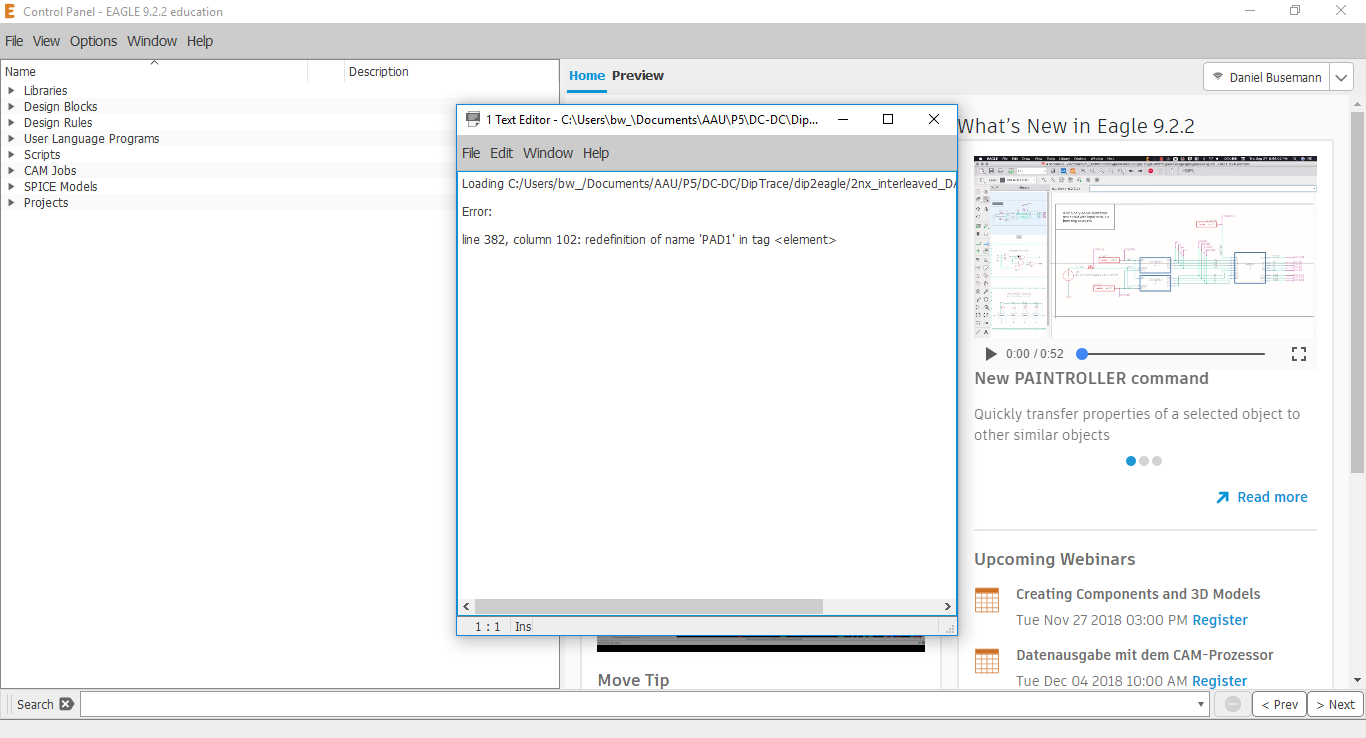
DipTrace/dip2eagle/EagleError.PNG
