BlackAndWhiteSnaable/DC-DC/DipTrace/dip2eagle/EagleErrorPad1_1.PNG

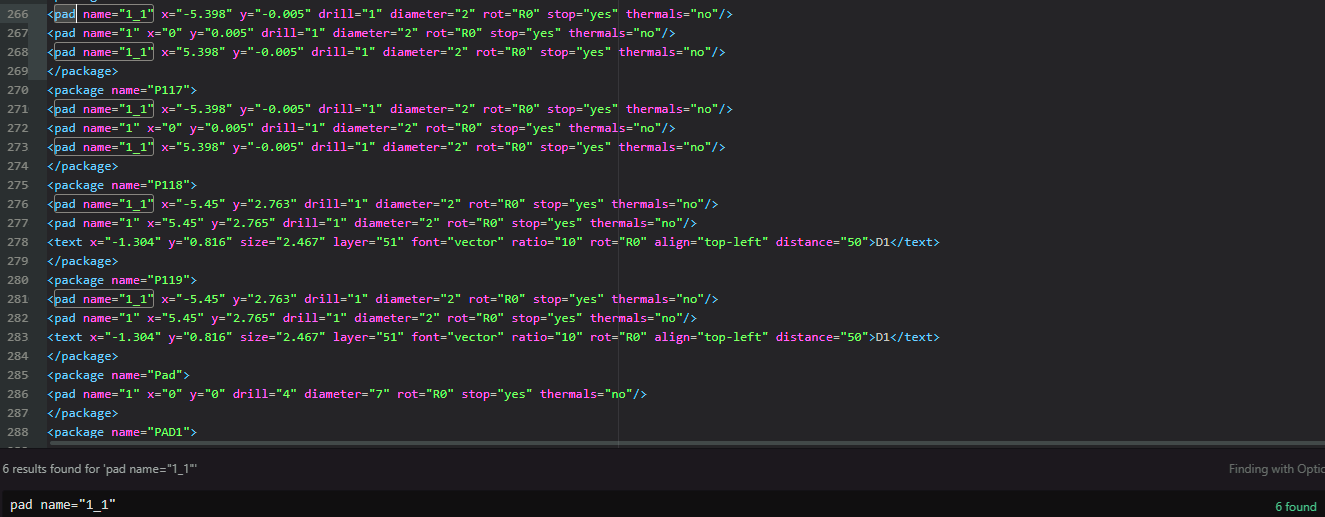
DipTrace/dip2eagle/EagleErrorPad1_1.PNG
