BlackAndWhiteSnaable/DC-DC/DipTrace/Questions/BotPart_Clearances.PNG

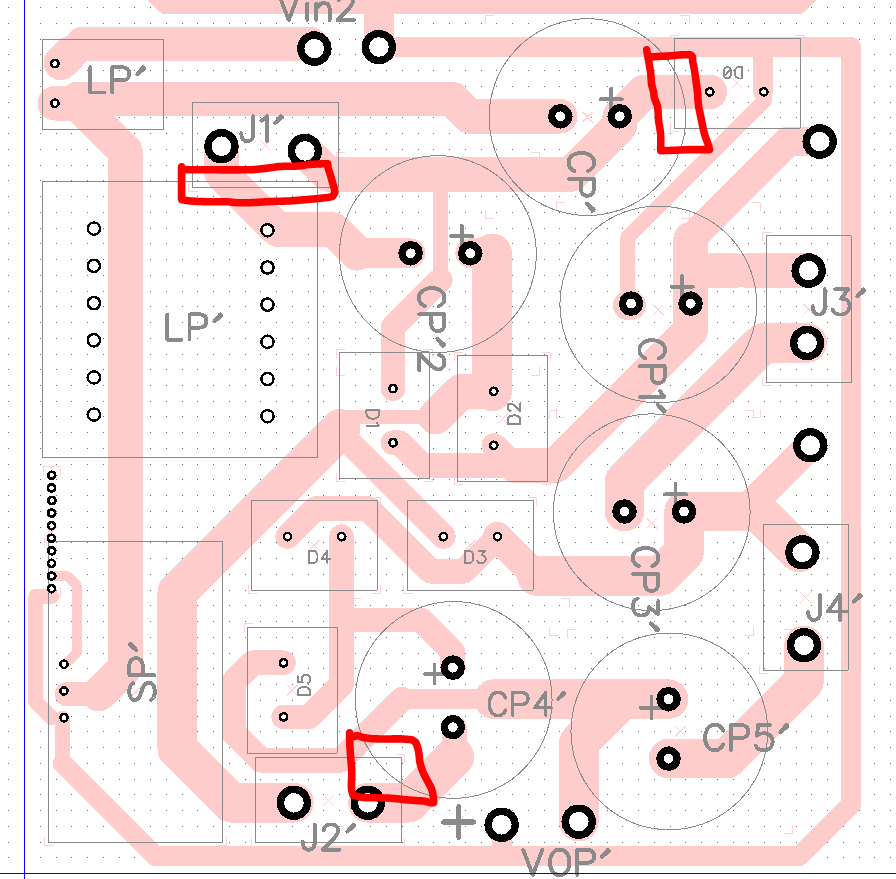
DipTrace/Questions/BotPart_Clearances.PNG
