BlackAndWhiteSnaable/DC-DC/DipTrace/Questions/BotPart_Pins.PNG

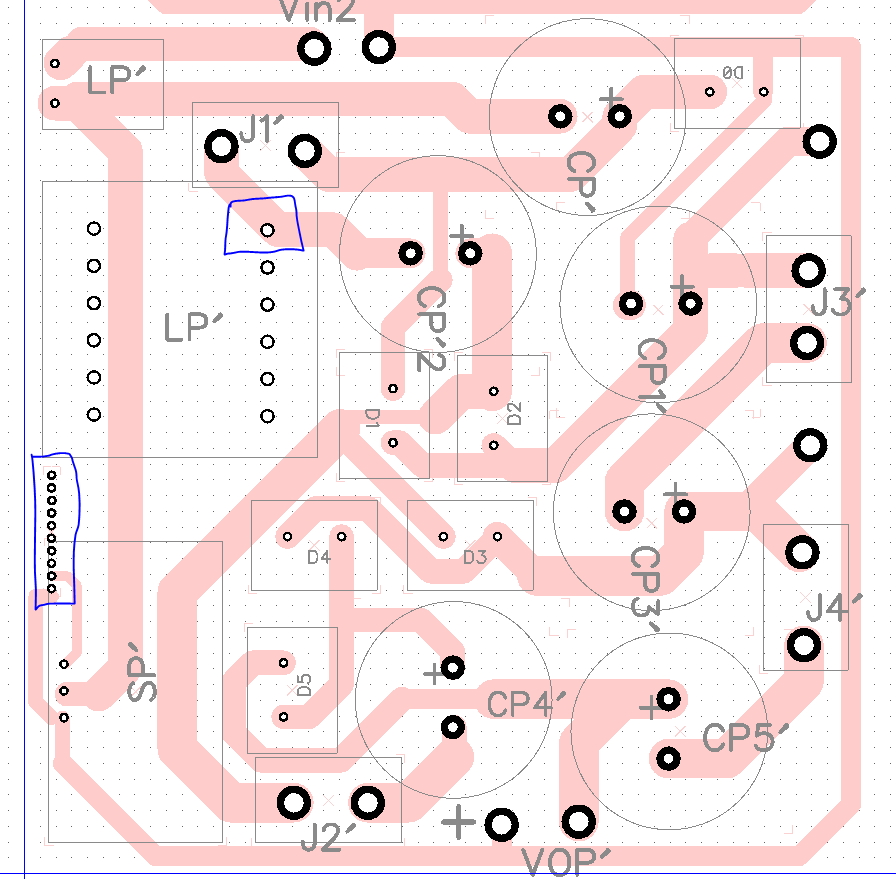
DipTrace/Questions/BotPart_Pins.PNG
