BlackAndWhiteSnaable/DC-DC/DipTrace/Questions/Gerber.PNG

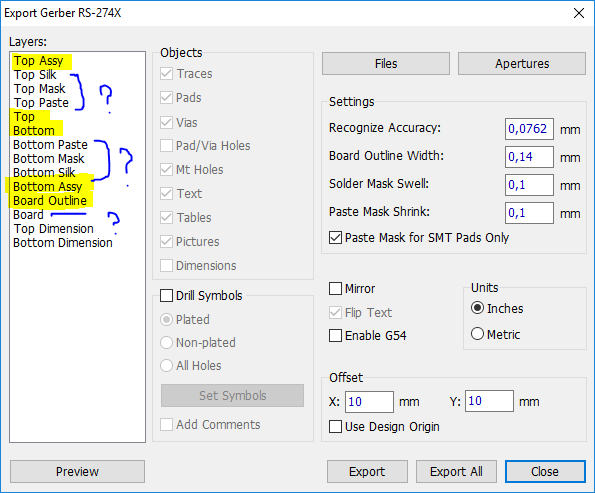
DipTrace/Questions/Gerber.PNG
