BlackAndWhiteSnaable/DC-DC/DipTrace/Questions/TopPart.PNG

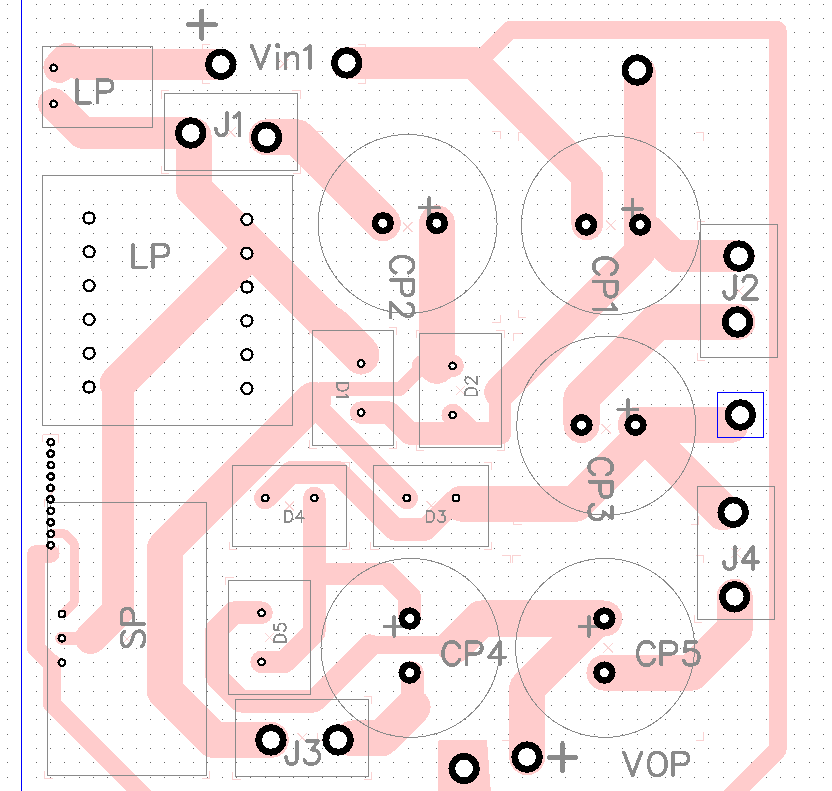
DipTrace/Questions/TopPart.PNG
