BlackAndWhiteSnaable/DC-DC/Inverter/Report/figures/aConventionalBoost/ConventionalBoostConverter.png

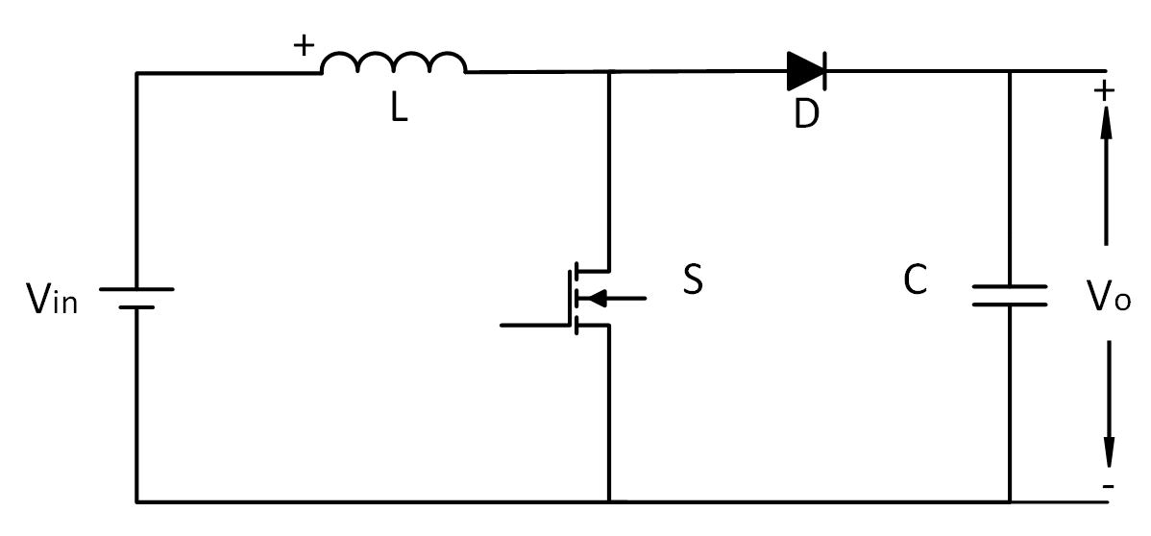
Inverter/Report/figures/aConventionalBoost/ConventionalBoostConverter.png
