BlackAndWhiteSnaable/DC-DC/Sanjee/WhatsApp Image 2018-11-26 at 11.23.35.jpeg

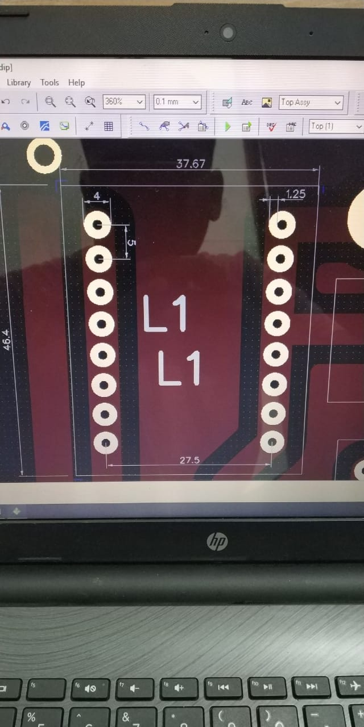
Sanjee/WhatsApp Image 2018-11-26 at 11.23.35.jpeg
