BlackAndWhiteSnaable/DC-DC/Report/sections/content/00nomenclature.tex

\vspace{-24mm}
\section*{Acronyms \& Nomenclature}

\begin{tabular*}{\textwidth}{@{\extracolsep{\fill}} l l r}
	\textbf{Symbol}	& \textbf{Definition}			& \textbf{Unit}\\
	\hline
	AC			& Alternating Current				& \\
	BC			& Boost Converter					& \\
	C			& Capacitance						& $F$\\
	CBC			& Conventional boost converter					& \\
	CTLBC		&Conventional Three Level Boost Converter		& \\
	CWM		    & Cockcroft-Walton Multiplier 		& \\
	DC			& Direct Current					& \\
	D			& Duty cycle					& \\
	f			& Frequency					& $Hz$\\
	I			& Current							& $A$\\
	IVSB		& Inductor Voltage Second Balance				& \\
	KVL			& Kirchhoff's Voltage low				& \\
	L			& Inductance					& $H$\\
	N			& Number of levels						& \\
	P			& Power								& $W$\\
	PV			& Photovoltaic						& \\
	PWM			& Pulse Width Modulation						& \\
	PCB			& Printed Circuit Board					& \\
	R			& Resistance						& $\Omega$\\
	SIBC			&Switched Inductor Boost Converter			& \\
	SISO		& Single Input Single Output		& \\
	SSQBC			&Single Switch Quadratic Boost Converter	& \\
	$T_s$		& Time period					&$s$ \\
	V			& Voltage							& $V$\\
	$\eta$		& Efficiency							&	\\
	\hline \hline
				& \textbf{Subscripts}				&	\\
	\hline
	$ref$		& Reference							&	\\
	$rip$		& Ripple							&	\\
	$tot$		& Total								&	\\
	
	$C$			& Capacitor							&	\\
	$D_i$		& Diode							&	\\
	$L$			& Inductor							&	\\
	$R$			& Resistor							&	\\
	$S$			& Switch							&	\\
	\hline \hline

				& \textbf{Prescripts}				&	\\
	\hline
	$\Delta$	& Change							&	\\
	\hline \hline
\end{tabular*}
