BlackAndWhiteSnaable/DC-DC/Inverter/Report/sections/content/00nomenclature.tex

\chapter*{Acronyms \& Nomenclature}
\todo[color=c00,inline]{Acronyms \& Nomenclature}
\begin{tabular*}{\textwidth}{@{\extracolsep{\fill}} l l r}
	\textbf{Symbol}	& \textbf{Definition}			& \textbf{Unit}\\
	\hline
	AC			& Alternating Current				& \\
	BC			& Boost Converter					& \\
	C			& Capacitance						& $H$\\
	DC			& Direct Current					& \\
	OL			& Open-loop							& \\
	OS			& Operating System					& \\
	P			& Power								& $W$\\
	PC			& Personal Computer					& \\
	PV			& Photo Voltaic						& \\
	QDM			& Quarter Decay Method				& \\
	R			& Resistance						& $\Omega$\\
	SISO		& Single Input Single Output		& \\
	SL			& Simulink\textsuperscript{\textregistered{}} & \\
	SLRT		& Simulink\textsuperscript{\textregistered{}} Real-Time\texttrademark{}& \\
	USM			& Ultimate Sensitivity Method		& \\ 
	V			& Volatege							& $V$\\
	I			& Current							& $A$\\

	$\eta$		& Efficiency						& $\%$\\
	\hline \hline
				& 									&	\\
				& \textbf{Subscripts}				&	\\
	\hline
	$ref$		& Reference							&	\\
	$rip$		& Ripple							&	\\
	$tot$		& Total								&	\\
	
	$C$			& Capacitor							&	\\
	$D$			& Diode								&	\\
	$R$			& Resistor							&	\\
	$S$			& Switch							&	\\
	\hline \hline
				& 									&	\\
				& \textbf{Prescripts}				&	\\
	\hline
	$\Delta$	& Change							&	\\
	\hline \hline
\end{tabular*}
\todo[color=c00]{this needs to be updated with relevant terms}
