BlackAndWhiteSnaable/DC-DC/Inverter/Report/sections/content/05Implementation/aComponentSpecs.tex

\section{Component Specifications}\label{ch:compSpec}
\todo[color=c05a,inline]{testing the colors}
