BlackAndWhiteSnaable/DC-DC/Inverter/Report/setup/preamble.tex

%  A simple AAU report template.
%  2015-05-08 v. 1.2.0
%  Copyright 2010-2015 by Jesper Kjær Nielsen <jkn@es.aau.dk>
%
%  This is free software: you can redistribute it and/or modify
%  it under the terms of the GNU General Public License as published by
%  the Free Software Foundation, either version 3 of the License, or
%  (at your option) any later version.
%
%  This is distributed in the hope that it will be useful,
%  but WITHOUT ANY WARRANTY; without even the implied warranty of
%  MERCHANTABILITY or FITNESS FOR A PARTICULAR PURPOSE.  See the
%  GNU General Public License for more details.
%
%  You can find the GNU General Public License at <http://www.gnu.org/licenses/>.
%
\documentclass[11pt,twoside,a4paper,openright]{report}
%%%%%%%%%%%%%%%%%%%%%%%%%%%%%%%%%%%%%%%%%%%%%%%%
% Language, Encoding and Fonts
% http://en.wikibooks.org/wiki/LaTeX/Internationalization
%%%%%%%%%%%%%%%%%%%%%%%%%%%%%%%%%%%%%%%%%%%%%%%%
% Select encoding of your inputs. Depends on
% your operating system and its default input
% encoding. Typically, you should use
%   Linux  : utf8 (most modern Linux distributions)
%            latin1
%   Windows: ansinew
%            latin1 (works in most cases)
%   Mac    : applemac
% Notice that you can manually change the input
% encoding of your files by selecting "save as"
% an select the desired input encoding.
\usepackage[utf8]{inputenc}
% Make latex understand and use the typographic
% rules of the language used in the document.
\usepackage{subfig}
\usepackage{capt-of}
\usepackage[danish,english]{babel}
% Use the palatino font
\usepackage[sc]{mathpazo}
\linespread{1.05}         % Palatino needs more leading (space between lines)
% Choose the font encoding
\usepackage[T1]{fontenc}
%%%%%%%%%%%%%%%%%%%%%%%%%%%%%%%%%%%%%%%%%%%%%%%%
% Graphics and Tables
% http://en.wikibooks.org/wiki/LaTeX/Importing_Graphics
% http://en.wikibooks.org/wiki/LaTeX/Tables
% http://en.wikibooks.org/wiki/LaTeX/Colors
%%%%%%%%%%%%%%%%%%%%%%%%%%%%%%%%%%%%%%%%%%%%%%%%
% load a colour package
\usepackage{xcolor}
\definecolor{aaublue}{RGB}{33,26,82}% dark blue
% The standard graphics inclusion package
\usepackage{graphicx}
% Set up how figure and table captions are displayed
\usepackage{caption}
\captionsetup{%
  font=footnotesize,% set font size to footnotesize
  labelfont=bf % bold label (e.g., Figure 3.2) font
}
% Make the standard latex tables look so much better
\usepackage{array,booktabs}
\usepackage{tabularx}
% Enable the use of frames around, e.g., theorems
% The framed package is used in the example environment
\usepackage{framed}

%%%%%%%%%%%%%%%%%%%%%%%%%%%%%%%%%%%%%%%%%%%%%%%%
% Mathematics
% http://en.wikibooks.org/wiki/LaTeX/Mathematics
%%%%%%%%%%%%%%%%%%%%%%%%%%%%%%%%%%%%%%%%%%%%%%%%
% Defines new environments such as equation,
% align and split
\usepackage{amsmath}
% Adds new math symbols
\usepackage{amssymb}
% Use theorems in your document
% The ntheorem package is also used for the example environment
% When using thmmarks, amsmath must be an option as well. Otherwise \eqref doesn't work anymore.
\usepackage[framed,amsmath,thmmarks]{ntheorem}

%%%%%%%%%%%%%%%%%%%%%%%%%%%%%%%%%%%%%%%%%%%%%%%%
% Page Layout
% http://en.wikibooks.org/wiki/LaTeX/Page_Layout
%%%%%%%%%%%%%%%%%%%%%%%%%%%%%%%%%%%%%%%%%%%%%%%%
% Change margins, papersize, etc of the document
\usepackage[
  inner=28mm,% left margin on an odd page
  outer=41mm,% right margin on an odd page
  ]{geometry}
% Modify how \chapter, \section, etc. look
% The titlesec package is very configureable
\usepackage{titlesec}
\titleformat{\chapter}[display]{\normalfont\huge\bfseries}{\chaptertitlename\ \thechapter}{20pt}{\Huge}
\titleformat*{\section}{\normalfont\Large\bfseries}
\titleformat*{\subsection}{\normalfont\large\bfseries}
\titleformat*{\subsubsection}{\normalfont\normalsize\bfseries}
%\titleformat*{\paragraph}{\normalfont\normalsize\bfseries}
%\titleformat*{\subparagraph}{\normalfont\normalsize\bfseries}

% Clear empty pages between chapters
\let\origdoublepage\cleardoublepage
\newcommand{\clearemptydoublepage}{%
  \clearpage
  {\pagestyle{empty}\origdoublepage}%
}
\let\cleardoublepage\clearemptydoublepage

% Change the headers and footers
\usepackage{fancyhdr}
\pagestyle{fancy}
\fancyhf{} %delete everything
\renewcommand{\headrulewidth}{0pt} %remove the horizontal line in the header
\fancyhead[RE]{\small\nouppercase\leftmark} %even page - chapter title
\fancyhead[LO]{\small\nouppercase\rightmark} %uneven page - section title
\fancyhead[LE,RO]{\thepage} %page number on all pages
% Do not stretch the content of a page. Instead,
% insert white space at the bottom of the page
\raggedbottom
% Enable arithmetics with length. Useful when
% typesetting the layout.
\usepackage{calc}

%%%%%%%%%%%%%%%%%%%%%%%%%%%%%%%%%%%%%%%%%%%%%%%%
% Bibliography
% http://en.wikibooks.org/wiki/LaTeX/Bibliography_Management
%%%%%%%%%%%%%%%%%%%%%%%%%%%%%%%%%%%%%%%%%%%%%%%%
\usepackage[backend=bibtex,
  bibencoding=utf8,sorting=none
  ]{biblatex}
\addbibresource{bib/mybib}

\usepackage{csquotes}

%%%%%%%%%%%%%%%%%%%%%%%%%%%%%%%%%%%%%%%%%%%%%%%%
% Our own stuff
%%%%%%%%%%%%%%%%%%%%%%%%%%%%%%%%%%%%%%%%%%%%%%%%
%needed for one table
\usepackage{multirow}
%needed for a different table
\newcolumntype{Y}{>{\centering\arraybackslash}X}

%needed for code listings
\usepackage{listings}
%sets the language globally to C
\lstset{language=C}
%code formating
\usepackage{adjustbox}
\usepackage{float}
%\usepackage[usenames,dvipsnames]{xcolor}

\definecolor{codegreen}{rgb}{0,0.6,0}
\definecolor{codegray}{rgb}{0.5,0.5,0.5}
\definecolor{codepurple}{rgb}{0.58,0,0.82}
\definecolor{backcolour}{rgb}{0.95,0.95,0.92}
\definecolor{keywordblue}{rgb}{0.1,0,1}

\lstdefinestyle{CStyle}{
    backgroundcolor=\color{backcolour},
    commentstyle=\color{codegreen},
    keywordstyle=\color{keywordblue},
    numberstyle=\tiny\color{codegray},
    stringstyle=\color{codepurple},
    basicstyle={\footnotesize\ttfamily},
    breakatwhitespace=true,
    breaklines=true,
    captionpos=t,
    keepspaces=true,
    numbers=left,
    numbersep=5pt,
    showspaces=false,
    showstringspaces=false,
    showtabs=false,
    tabsize=2,
    language=C
}
\lstset{style=CStyle}

%%%%%%%%%%%%%%%%%%%%%%%%%%%%%%%%%%%%%%%%%%%%%%%%
% Misc
%%%%%%%%%%%%%%%%%%%%%%%%%%%%%%%%%%%%%%%%%%%%%%%%
% Add bibliography and index to the table of
% contents
\usepackage[nottoc]{tocbibind}
% Add the command \pageref{LastPage} which refers to the
% page number of the last page
\usepackage{lastpage}
% Add todo notes in the margin of the document
\usepackage[
%  disable, %turn off todonotes
  colorinlistoftodos, %enable a coloured square in the list of todos
  textwidth=\marginparwidth, %set the width of the todonotes
  textsize=scriptsize, %size of the text in the todonotes
  ]{todonotes}

%%%%%%%%%%%%%%%%%%%%%%%%%%%%%%%%%%%%%%%%%%%%%%%%
% Hyperlinks
% http://en.wikibooks.org/wiki/LaTeX/Hyperlinks
%%%%%%%%%%%%%%%%%%%%%%%%%%%%%%%%%%%%%%%%%%%%%%%%
% Enable hyperlinks and insert info into the pdf
% file. Hypperref should be loaded as one of the
% last packages
\usepackage{hyperref}
\hypersetup{%
	%pdfpagelabels=true,%
	plainpages=false,%
	pdfauthor={Bucur, Busemann, Klein},%
	pdftitle={P3 project},%
	pdfsubject={Pathfinding, as used in Rescuing Robots},%
	bookmarksnumbered=true,%
	hidelinks,		%no boxes aroundlinks and black fontcolor
	colorlinks=false,%
	citecolor=black,%
	filecolor=black,%
	linkcolor=black,% you should probably change this to black before printing
	urlcolor=black,%
	pdfstartview=FitH%
}
%%%%%%%%%%%%%%%%%%%%%%%%%%%%%%%%%%%%%%%%%%%%%%%%%%%%%%%%%%%%%%%%%%%%%%%%%%%%%%%%%%%%%%%%%%%%%%%%
%%%%%%%%%%%%%%%%%	OUR STUFF
\usepackage{nicefrac}
\newcommand*\mean[1]{\overline{#1}}

%%COLORS FOR COLORCODING FILES IN TODOS%%
\definecolor{c00}	{RGB}{200,200,082}%Acronyms \& Nomenclature
\definecolor{c01}	{RGB}{000,200,082}%Introduction
\definecolor{c02}	{RGB}{200,082,000}%Problem Description
\definecolor{c03}	{RGB}{082,100,200}%Problem Definition
\definecolor{c04}	{RGB}{100,050,200}%Development
  \definecolor{c04a}{RGB}{255,020,200} %Conventional Boost Converter
  \definecolor{c04b}{RGB}{010,200,200} %Switched Inductor
  \definecolor{c04c}{RGB}{200,200,200} %Single Switch Quadratic BC
  \definecolor{c04d}{RGB}{200,200,000} %Three Level BC
  \definecolor{c04x}{RGB}{004,229,069} %Cockroft Walton
  \definecolor{c04y}{RGB}{169,220,090} %Multilevel BC
\definecolor{c05}	{RGB}{050,100,150}%Implementation
  \definecolor{c05a}{RGB}{255,220,000} %Component Specifications
  \definecolor{c05b}{RGB}{210,000,200} %Driver
  \definecolor{c05c}{RGB}{200,200,200} %PCB Design
  \definecolor{c05d}{RGB}{000,200,200} %
  \definecolor{c05x}{RGB}{004,029,249} %
  \definecolor{c04y}{RGB}{069,120,250} %
\definecolor{c06}	{RGB}{150,100,150}%Testing
\definecolor{c07}	{RGB}{050,100,050}%Discussion
\definecolor{c08}	{RGB}{150,100,000}%Conclusion
\definecolor{c09}	{RGB}{050,200,050}%Perspective
\usepackage{pdfpages}
