BlackAndWhiteSnaable/DC-DC/photo_unsoldered_PCB.jpg

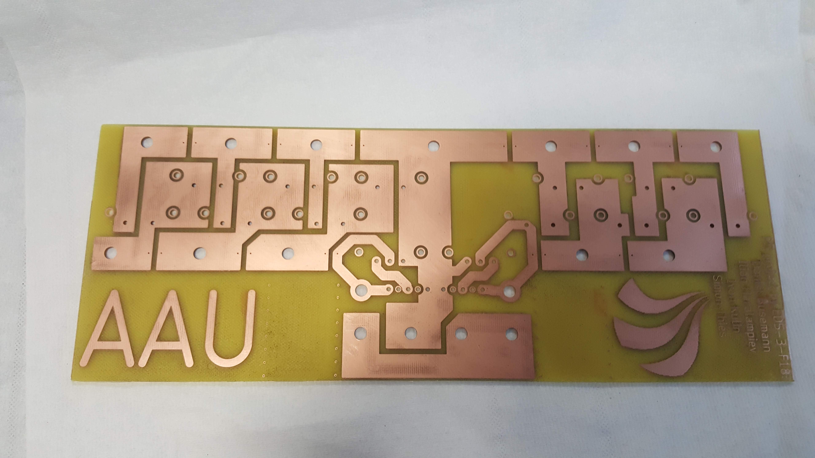
photo_unsoldered_PCB.jpg
