BlackAndWhiteSnaable/DC-DC/Report/appendix/Results_graphs.tex

\chapter{Plots of the results}
\label{app:Results}
\section{Capacitors at D=0.6}
\begin{figure}[H]
	\centering
	
	\caption{Bottom capacitors}
\end{figure}
\vspace{10mm}
\begin{figure}[H]
	\centering
	
	\caption{Top capacitors}
\end{figure}
\section{Inductors at D=0.6}
\begin{figure}[H]
	\centering
	
	\caption{Bottom inductor}
\end{figure}
\begin{figure}[H]
	\centering
	
	\caption{Top inductor}
\end{figure}
\section{Diodes at D=0.6}
\begin{figure}[H]
	\centering
	
	\caption{Bottom diodes}
\end{figure}
\begin{figure}[H]
	\centering
	
	\caption{Top diodes}
\end{figure}

\section{MOSTEFs at D=0.6}
\begin{figure}[H]
	\centering
	
	\caption{Bottom MOSFET}
\end{figure}

\begin{figure}[H]
	\centering
	
	\caption{Top MOSFET}
\end{figure}
