BlackAndWhiteSnaable/DC-DC/Calculated_Measured.xlsx

Sheet: Sheet1
Calculated expected output voltage |  |  |  | Measured |  | Diffrence
D | V_top | V_bot | V_o | V_o Test1 | V_o Test2 | Test1 | Test2
25 | 32.826 | 31.086 | 63.912 | 51.7 | 52.6 | 12.212 | 11.312
30 | 35.871 | 34.131 | 70.002 | 59.6 | 59.7 | 10.402 | 10.302
35 | 38.838 | 37.098 | 75.936 | 66.5 | 66.1 | 9.436 | 9.836
40 | 42.3 | 40.56 | 82.86 | 73.4 | 71.8 | 9.46 | 11.06
45 | 46.873 | 45.273 | 92.146 | 82.8 | 76.4 | 9.346 | 15.746
50 | 52 | 50.4 | 102.4 | 89.6 | 83.3 | 12.8 | 19.1
55 | 58.267 | 56.667 | 114.934 | 98.4 | 93.1 | 16.534 | 21.834
60 | 63.5 | 61.5 | 125 | 115.5 | 106.8 | 9.5 | 18.2
65 | 73.143 | 71.143 | 144.286 | 134.3 | 123.9 | 9.986 | 20.386
70 | 82.4 | 80 | 162.4 | 160.4 | 147 | 2 | 15.4
75 | 98.4 | 95.76 | 194.16 | 194.3 | 182.5 | -0.14 | 11.66
80 | 124.2 | 121.56 | 245.76 | 245.1 | 221 | 0.66 | 24.76
 |  |  |  |  |  | 11.07511111 | 15.79966667

Sheet: Sheet2
V_o | Measured | Difference
63.91V | 52.60V | 11.31V
70.00V | 59.70V | 10.30V
75.94V | 66.10V | 9.84V
82.86V | 71.80V | 11.06V
92.15V | 76.40V | 15.75V
102.40V | 83.30V | 19.10V
114.93V | 93.10V | 21.83V
125.00V | 106.80V | 18.20V
144.29V | 123.90V | 20.39V
162.40V | 147.00V | 15.40V
194.16V | 182.50V | 11.66V
245.76V | 221.00V | 24.76V
 |  | 15.80V
