BlackAndWhiteSnaable/DC-DC/Inverter/Report/sections/content/06Testing.tex

\chapter{Testing}\label{ch:testing}
\todo[color=c06,inline]{testing the colors}
%we should \include{•} the files in the 06Testing folder here.
