BlackAndWhiteSnaable/DC-DC/Report/figures/06Testing/Vripple10Vin-eps-converted-to.pdf

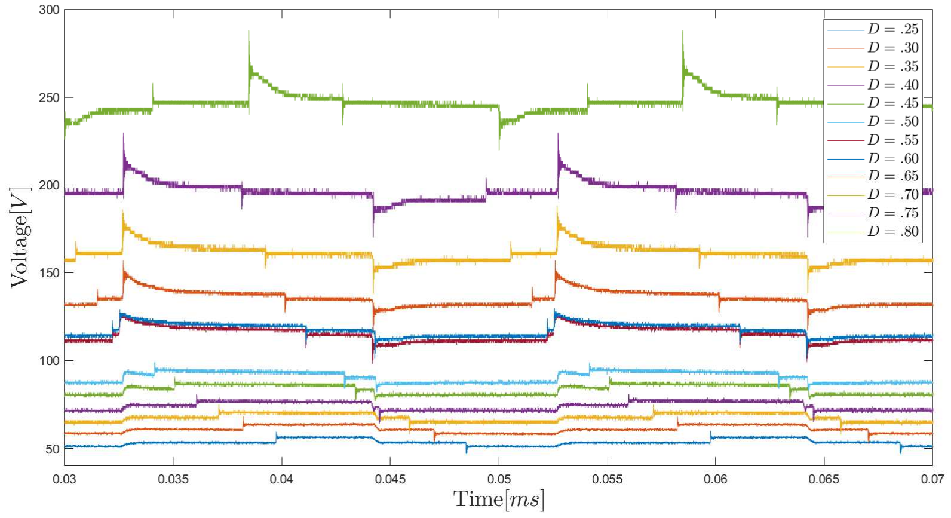
[picture p43: page 1]
