BlackAndWhiteSnaable/DC-DC/Report/figures/Problem/SolarConverters.pdf

Boost
converter

Inverter Solar

panels | Transformer | Low voltage
grid <60V DC | 560V DC | 400V AC | 50kV AC = = | = ~ | ~ ~
