BlackAndWhiteSnaable/DC-DC/Report/figures/Skyperboard/Skyper32in.pdf

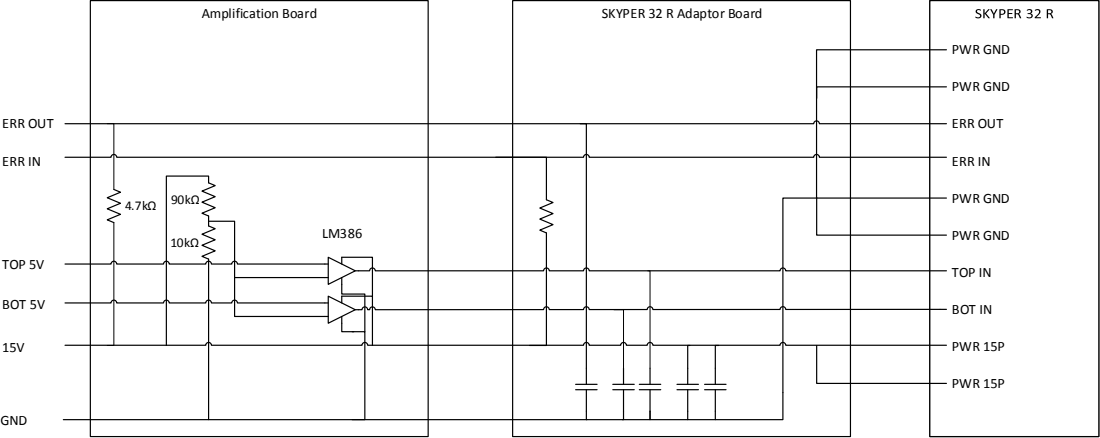
[picture p44: page 1]
Amplification Board; SKYPER 32 R Adaptor Board; PWR GND; TOP IN; ERR IN; BOT IN; ERR OUT; PWR 15P; GND; TOP 5V; BOT 5V
