BlackAndWhiteSnaable/DC-DC/Report/figures/Skyperboard/Skyper32out.pdf

# Cboost15p Cboost8n

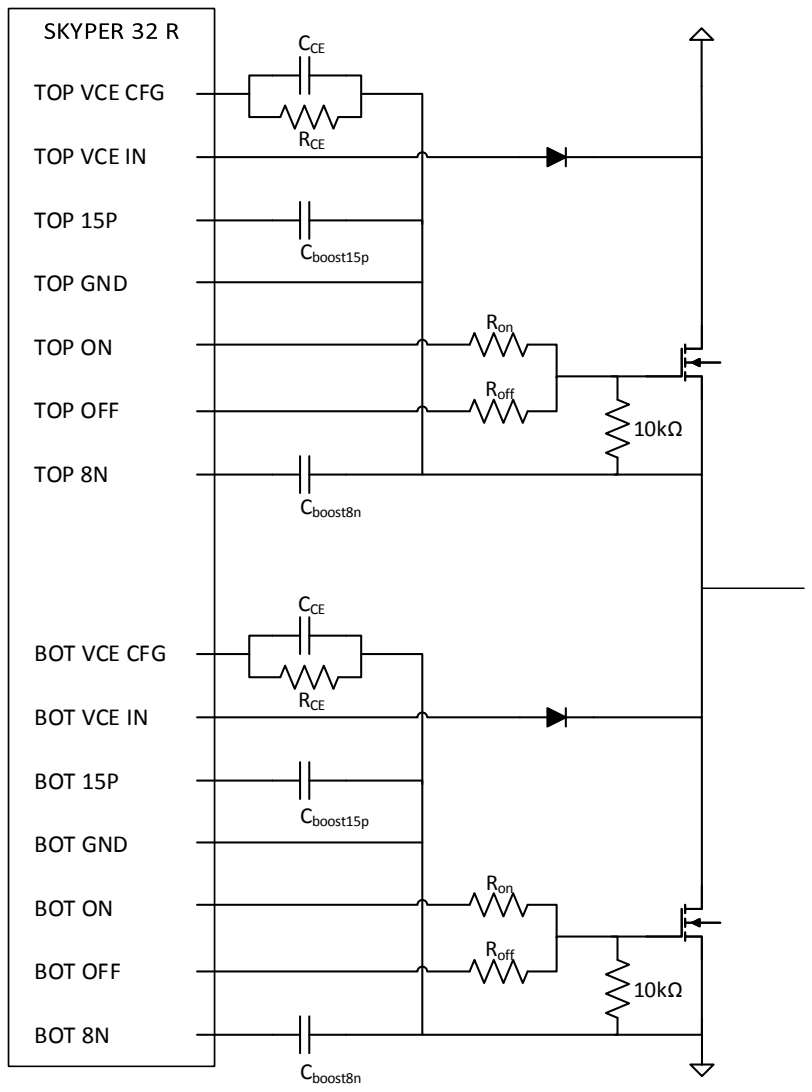
[picture p45: page 1]
TOP ON; TOP OFF; TOP GND; TOP 8N; TOP 15P; Ron Roff; RCE CCE; BOT ON; BOT OFF; BOT GND; BOT 8N; BOT 15P; Cboost15p Cboost8n

TOP VCE CFG

TOP VCE IN

BOT VCE CFG

BOT VCE IN
