BlackAndWhiteSnaable/DC-DC/Report/figures/zComponentDrops/compare_LTSpice.pdf

134.24V 64.82V

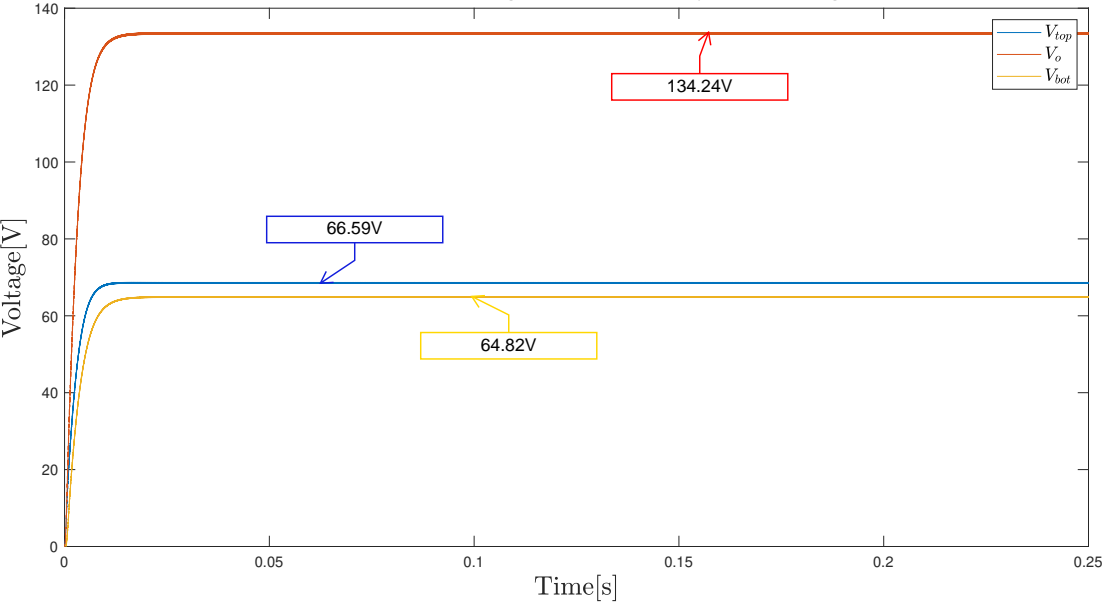
[picture p46: page 1]
