BlackAndWhiteSnaable/DC-DC/Notes/InvertingMBCforReport.pdf

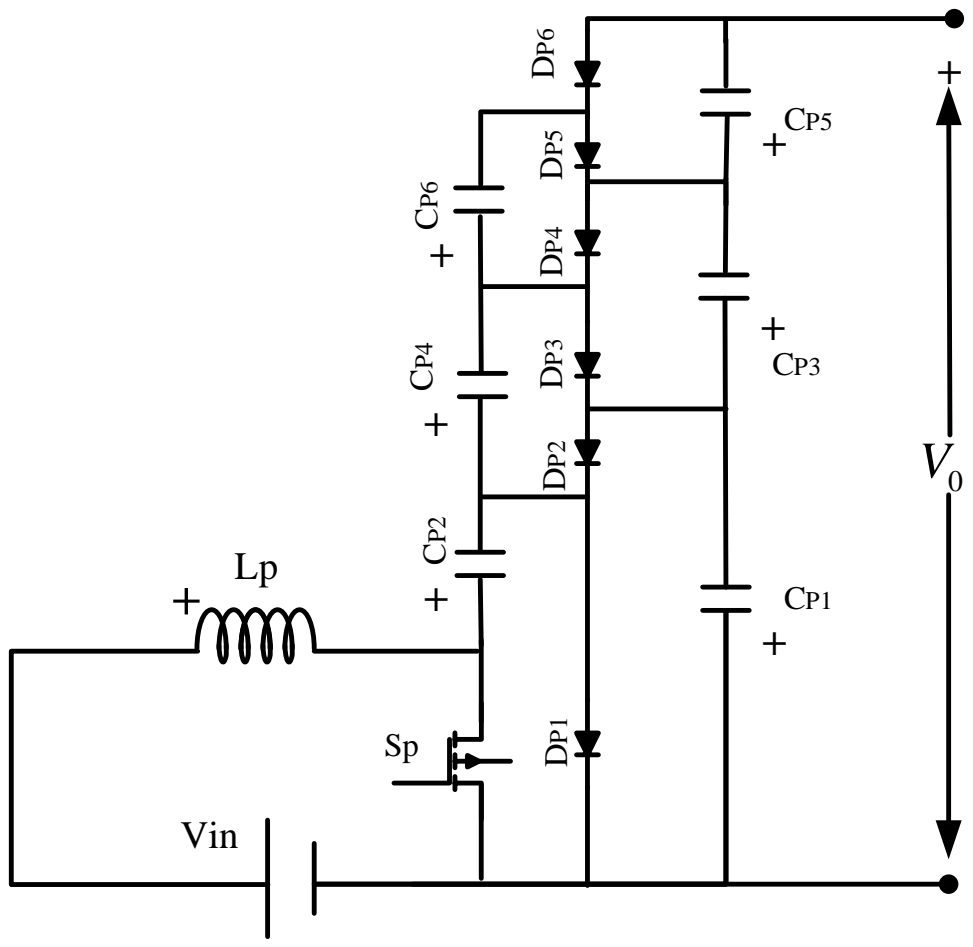
[picture p47: page 1]
Vin
