BlackAndWhiteSnaable/DC-DC/Report/figures/6Nx_LTSpice.pdf

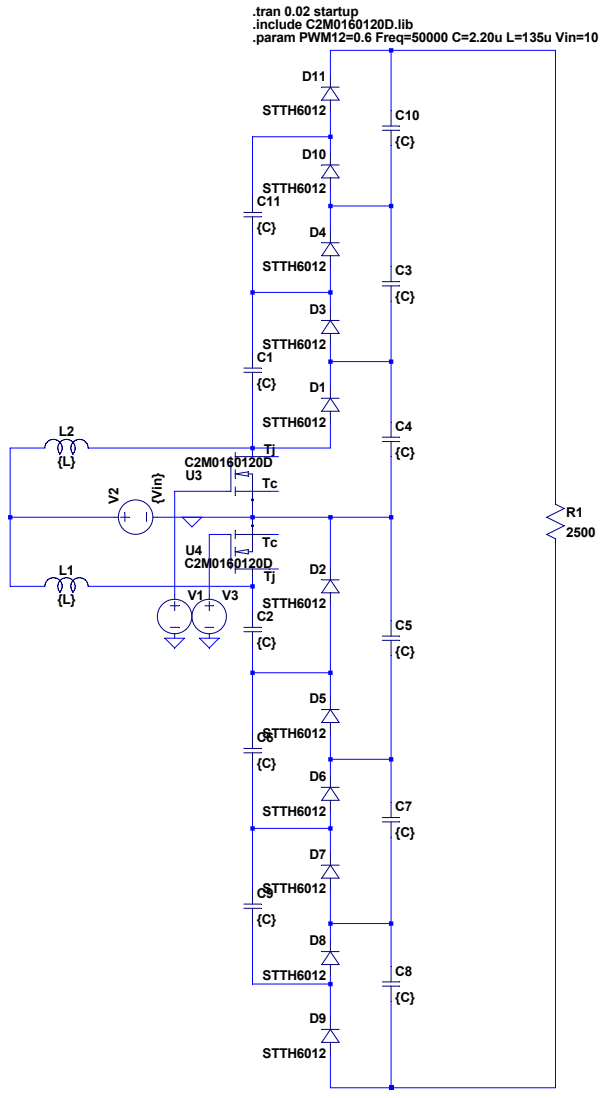
[picture p48: page 1]
