BlackAndWhiteSnaable/DC-DC/Report/figures/Efficiencycomparison-eps-converted-to.pdf

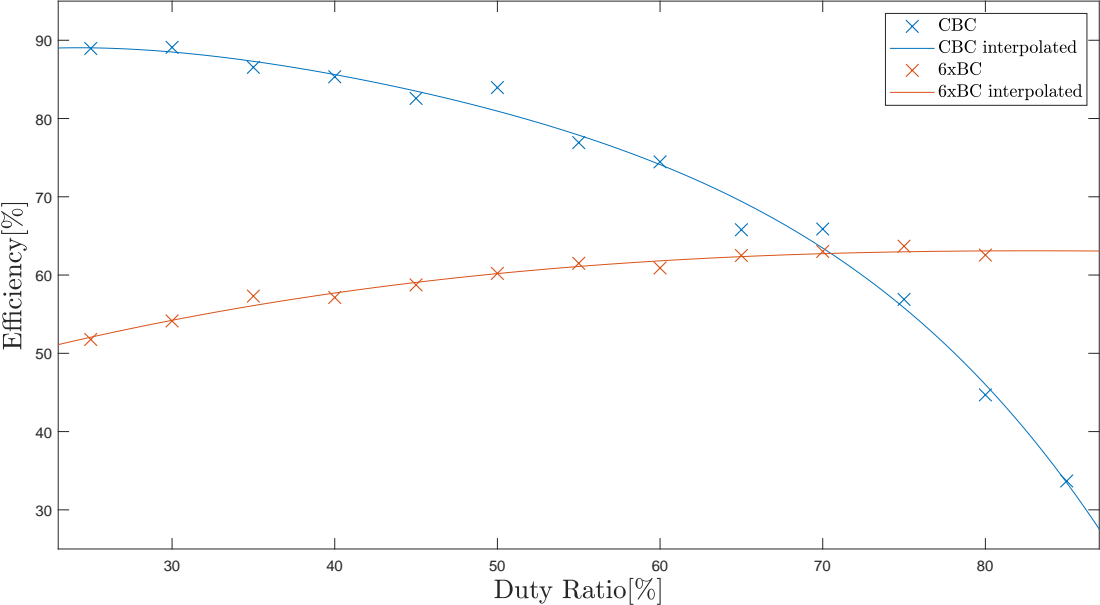
[picture p49: page 1]
