BlackAndWhiteSnaable/DC-DC/Report/figures/gains.pdf

6

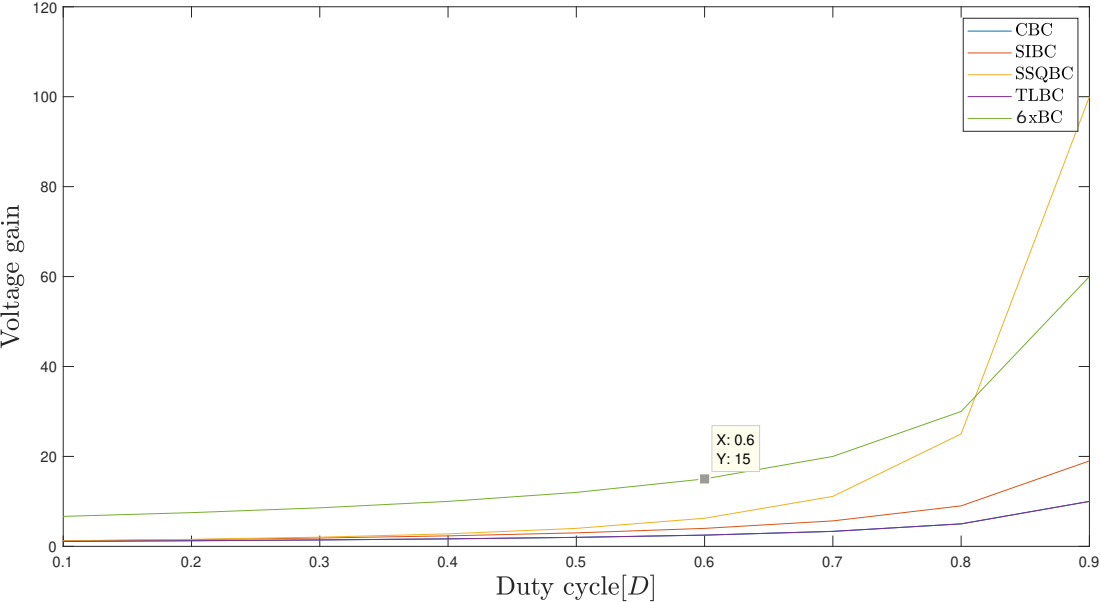
[picture p50: page 1]
