BlackAndWhiteSnaable/DC-DC/Report/figures/gains-eps-converted-to.pdf

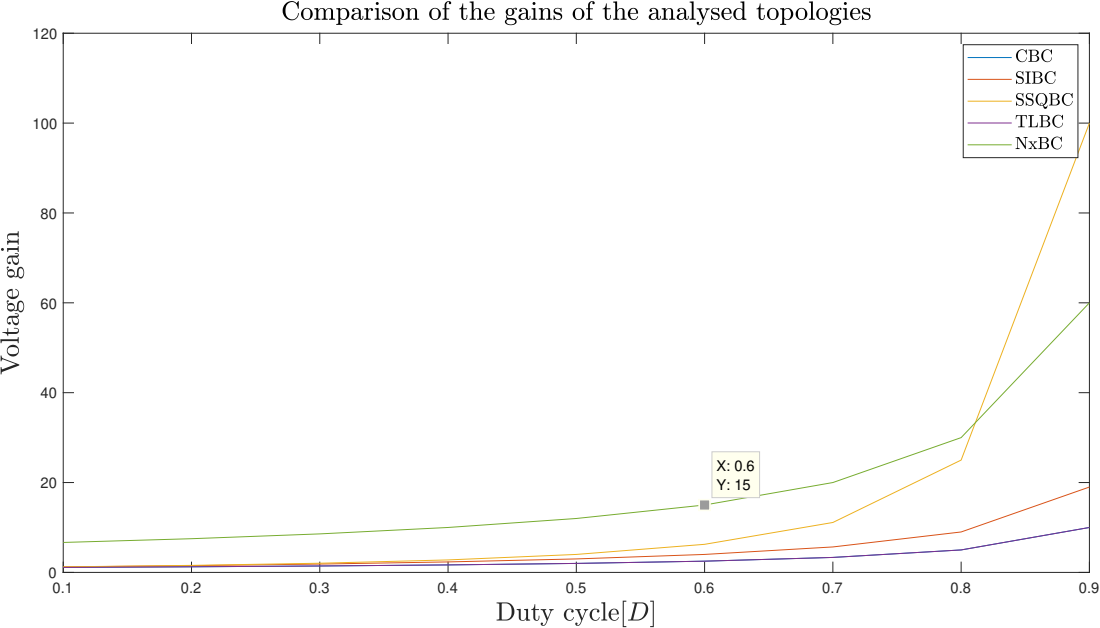
[picture p51: page 1]
