BlackAndWhiteSnaable/DC-DC/Report/figures/06Testing/botind60per-eps-converted-to.pdf

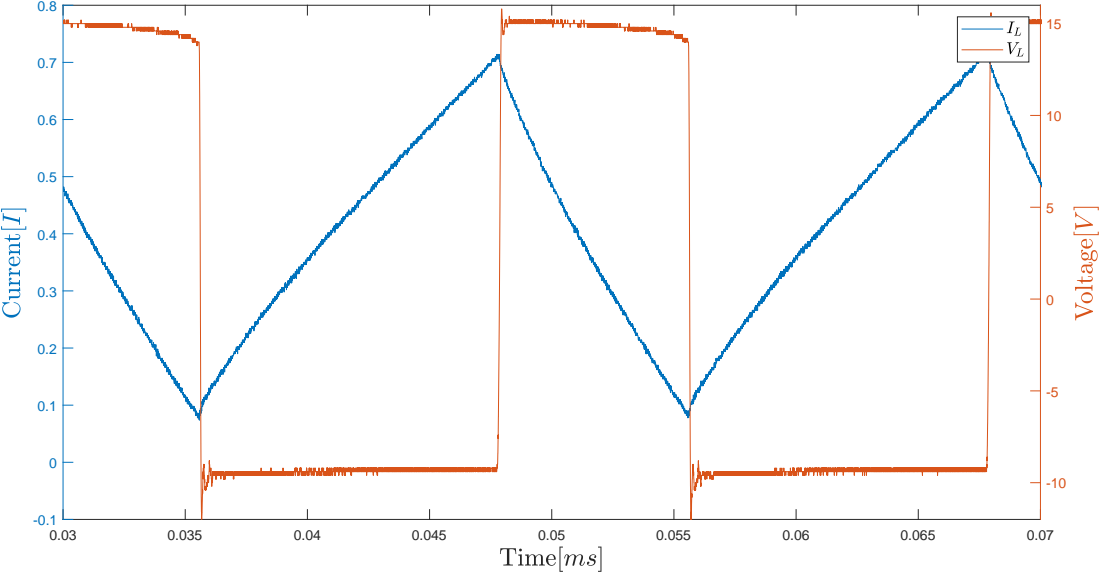
[picture p52: page 1]
