BlackAndWhiteSnaable/DC-DC/Report/figures/06Testing/topind60per-eps-converted-to.pdf

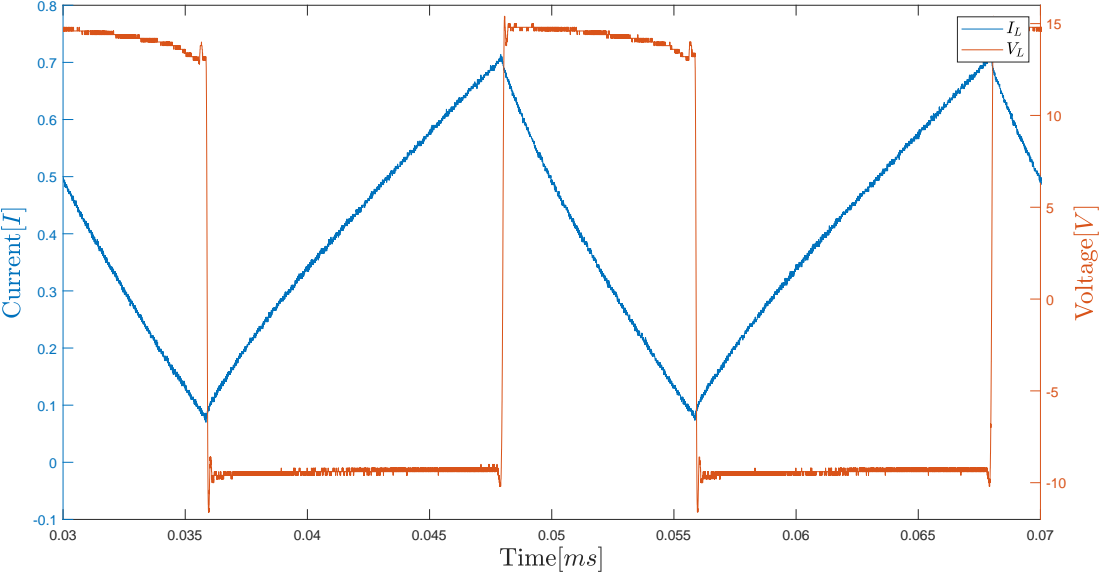
[picture p53: page 1]
