BlackAndWhiteSnaable/DC-DC/Report/figures/aConventionalBoost/CBC_V_LtoI_D-eps-converted-to.pdf

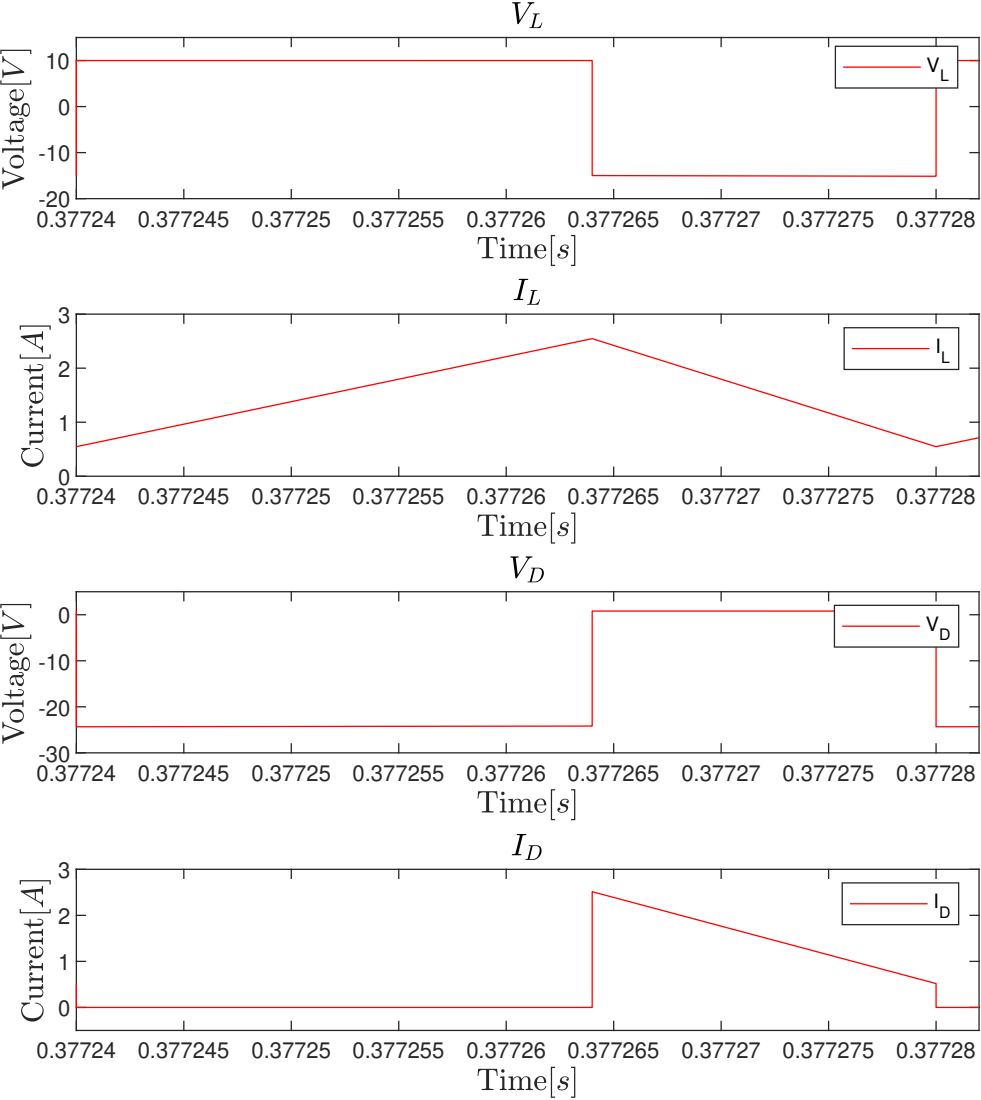
[picture p54: page 1]
