BlackAndWhiteSnaable/DC-DC/Report/figures/06Testing/botswi60per-eps-converted-to.pdf

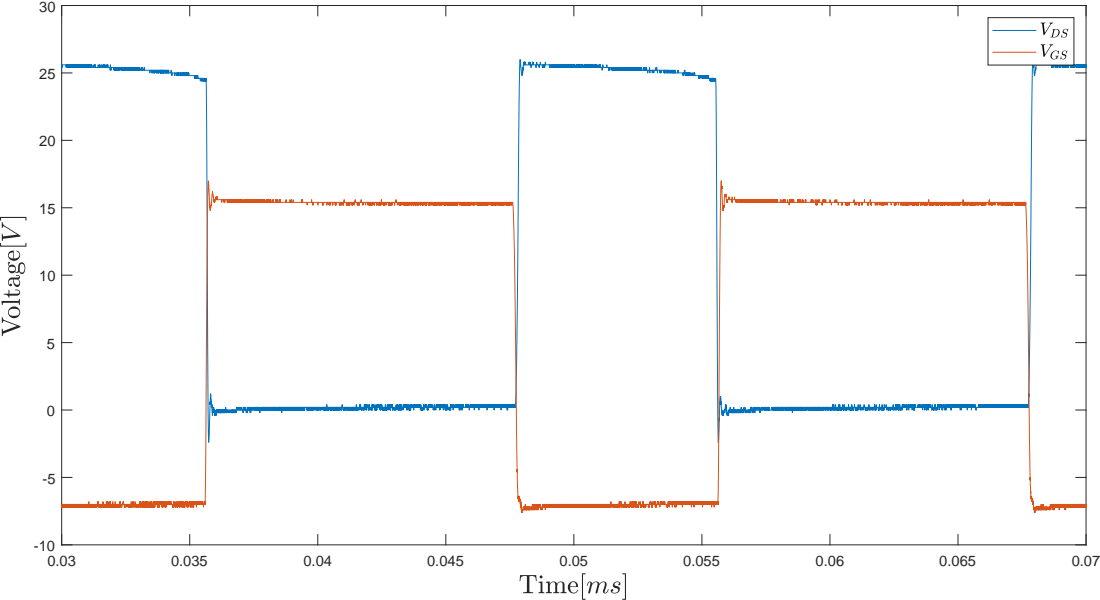
[picture p55: page 1]
