BlackAndWhiteSnaable/DC-DC/Report/figures/06Testing/topcap60per-eps-converted-to.pdf

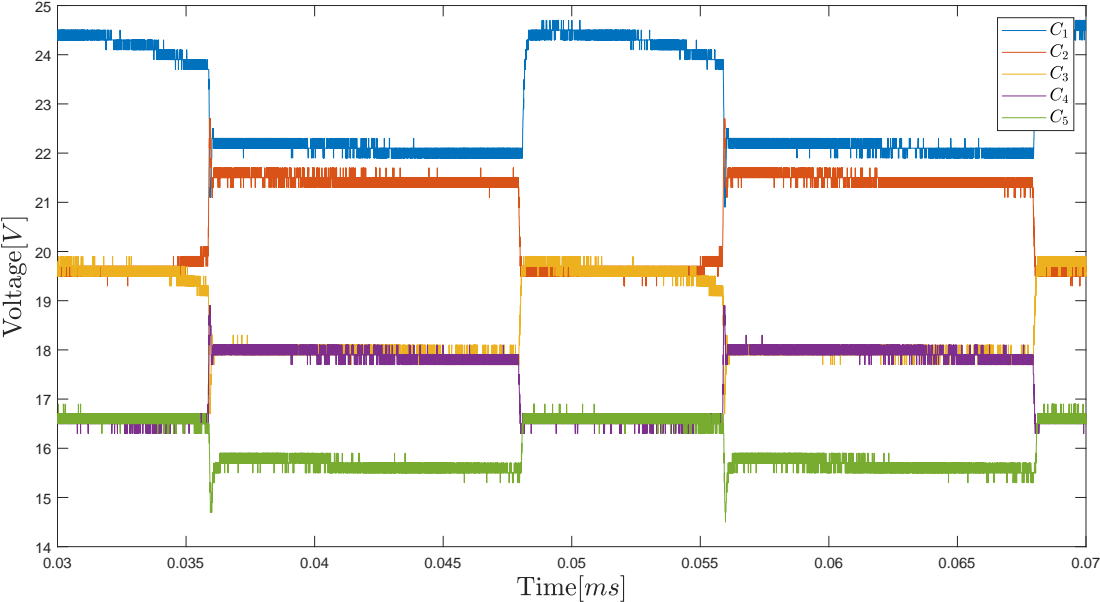
[picture p56: page 1]
