BlackAndWhiteSnaable/DC-DC/Report/figures/06Testing/topdio60per-eps-converted-to.pdf

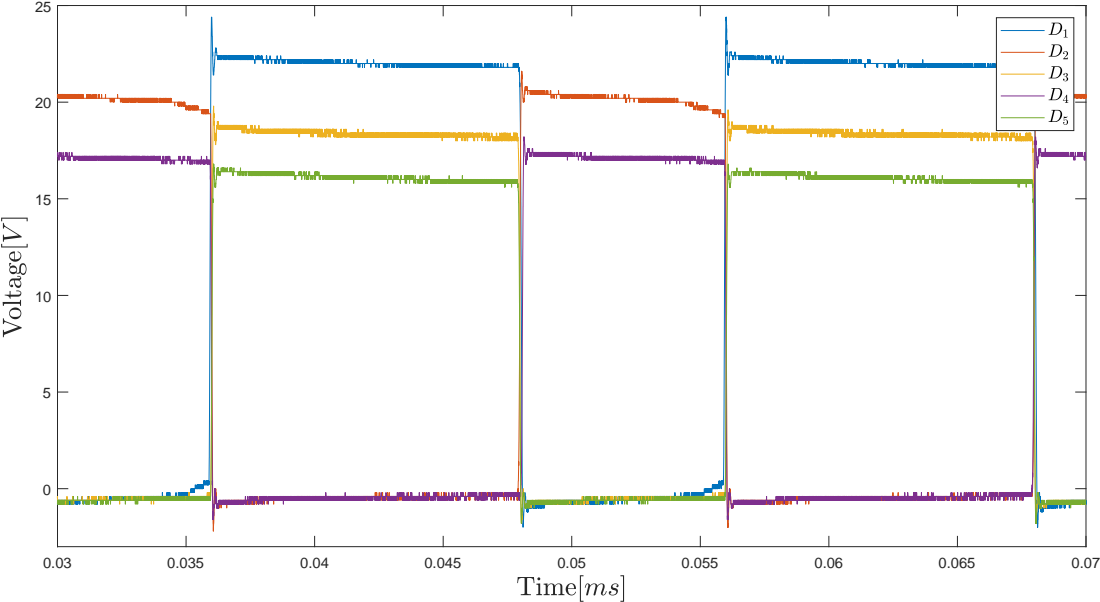
[picture p57: page 1]
