BlackAndWhiteSnaable/DC-DC/Report/figures/06Testing/topswi60per-eps-converted-to.pdf

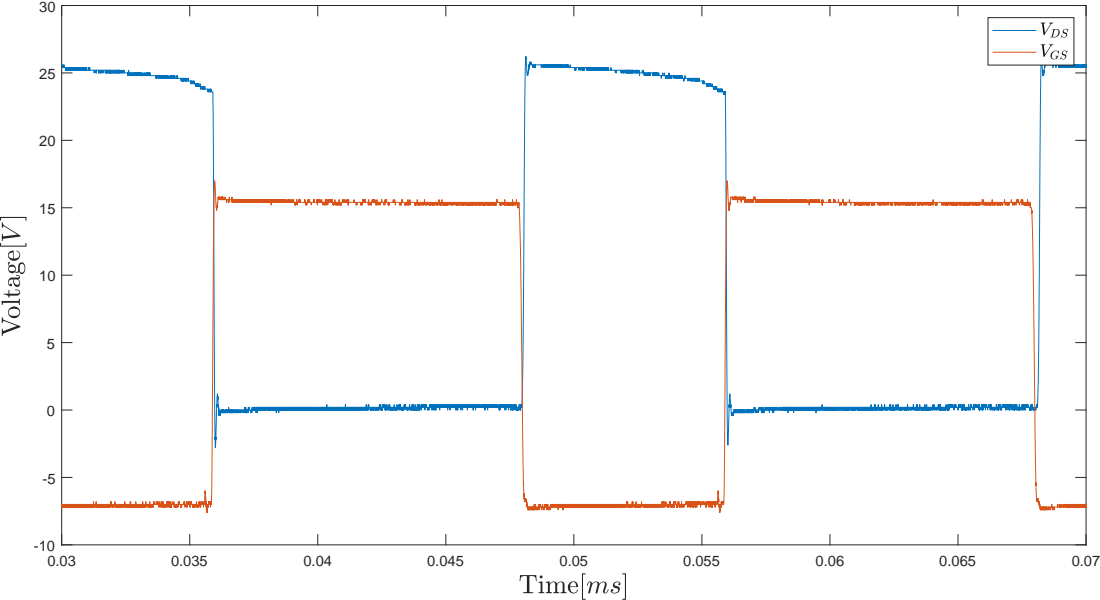
[picture p58: page 1]
