BlackAndWhiteSnaable/DC-DC/Report/figures/06Testing/botcap60per-eps-converted-to.pdf

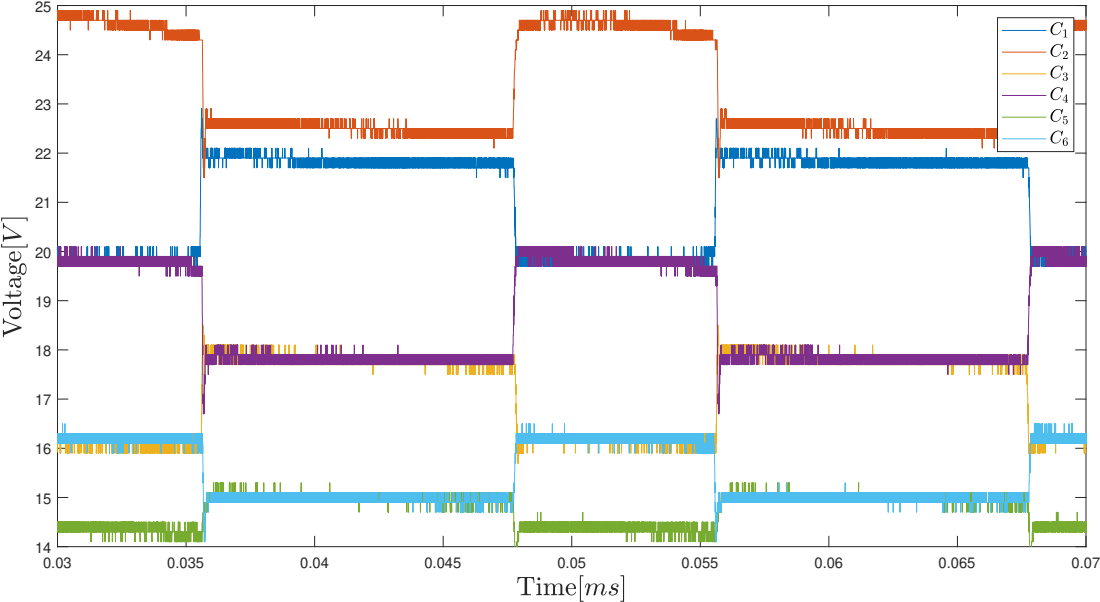
[picture p59: page 1]
