BlackAndWhiteSnaable/DC-DC/Report/figures/06Testing/botdio60per-eps-converted-to.pdf

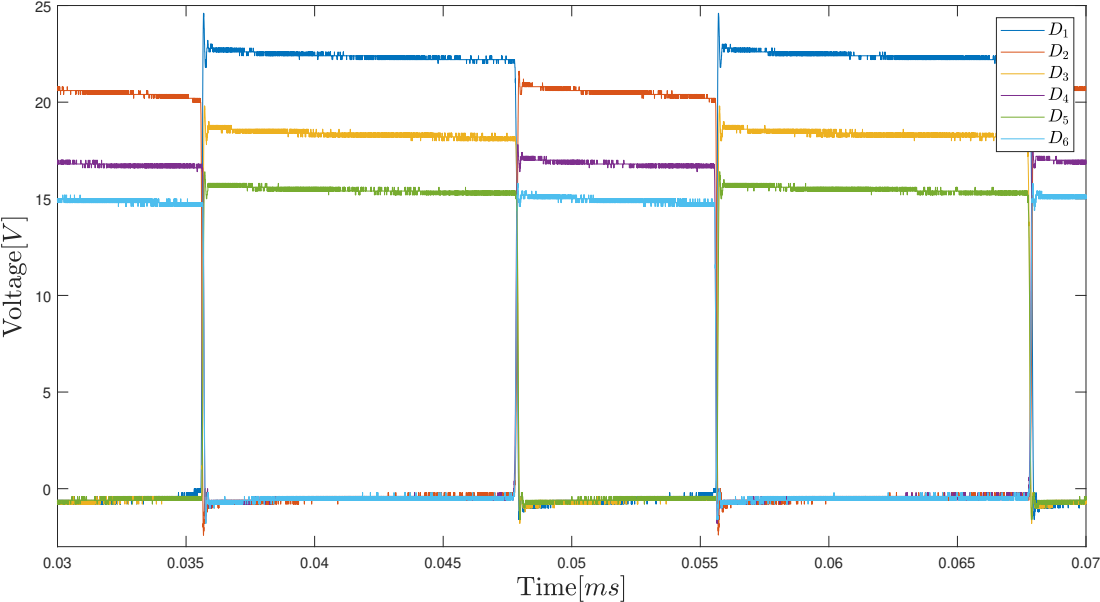
[picture p60: page 1]
