BlackAndWhiteSnaable/DC-DC/Report/figures/bSwitchedInductor/Simulation_SI.pdf

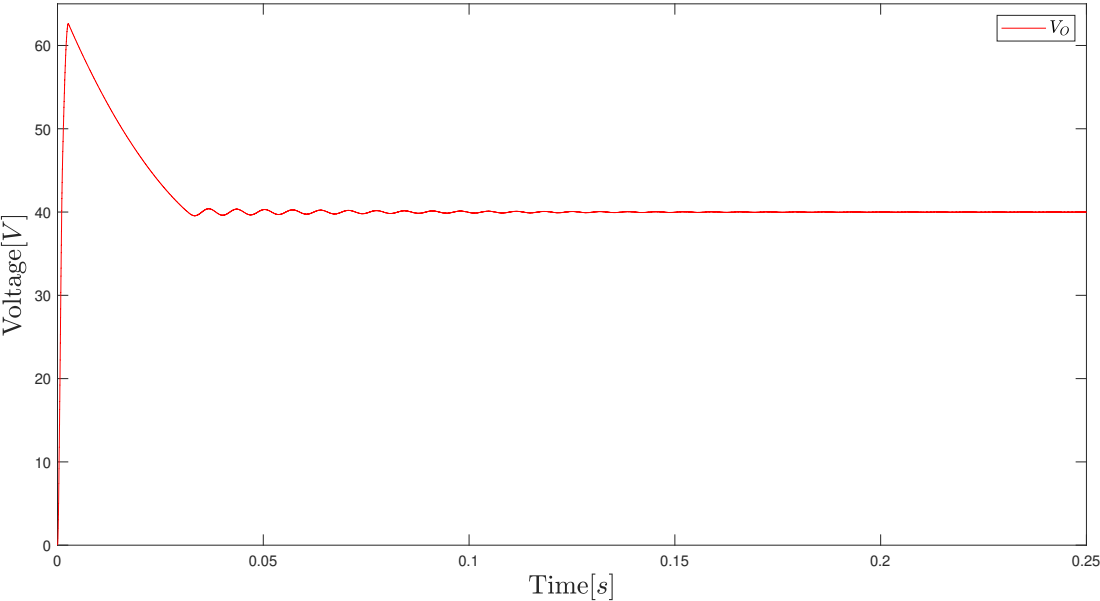
[picture p61: page 1]
