BlackAndWhiteSnaable/DC-DC/Report/figures/cSingleSwitchQuadraticBC/Simulation_SSQBC.pdf

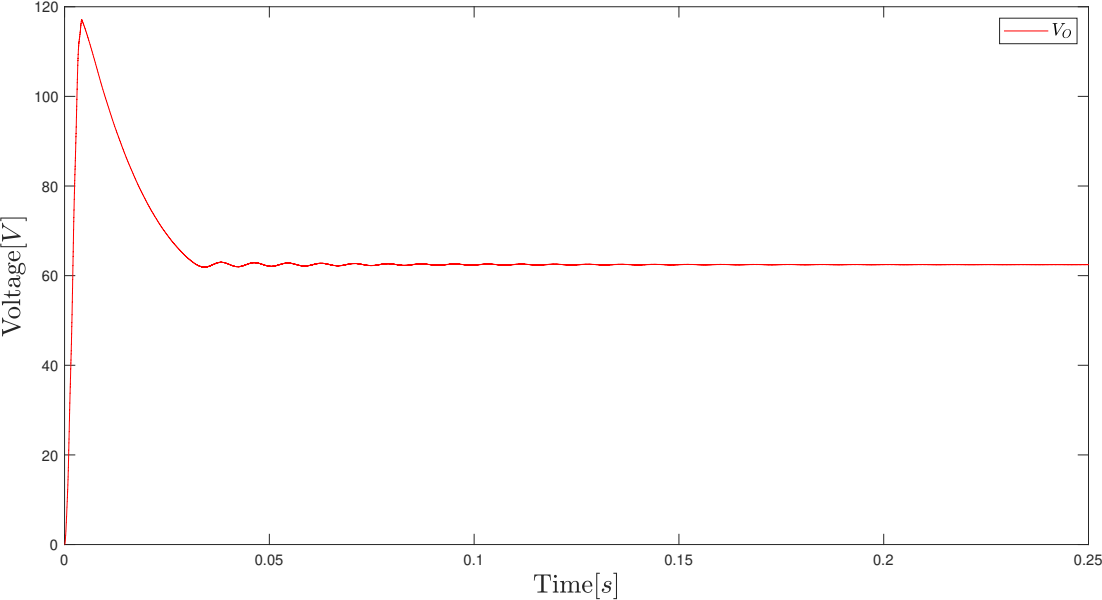
[picture p62: page 1]
