BlackAndWhiteSnaable/DC-DC/Report/figures/dConventionalThreeLevelBC/Simulation_CTLBC.pdf

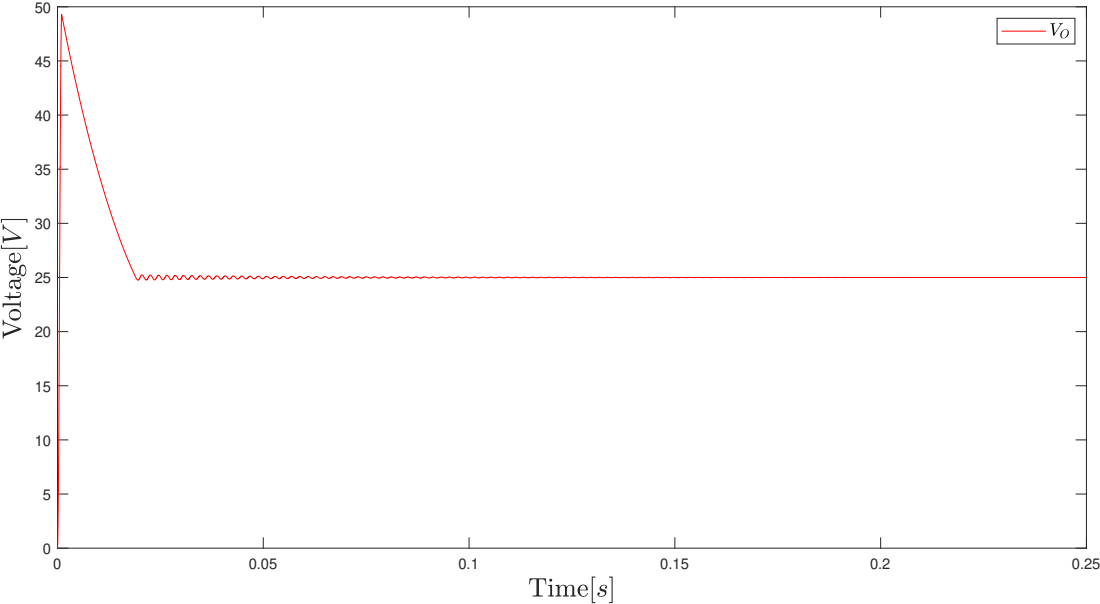
[picture p63: page 1]
