BlackAndWhiteSnaable/DC-DC/Report/figures/xCockroftWalton/capsV.pdf

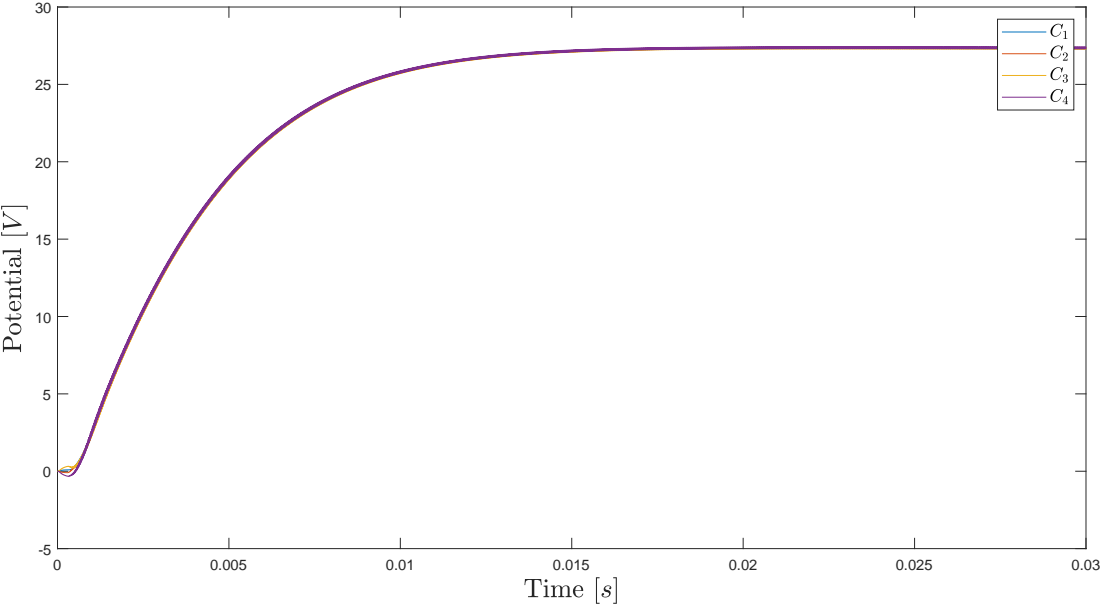
[picture p64: page 1]
