BlackAndWhiteSnaable/DC-DC/Report/figures/xCockroftWalton/Non-invertingNx.pdf

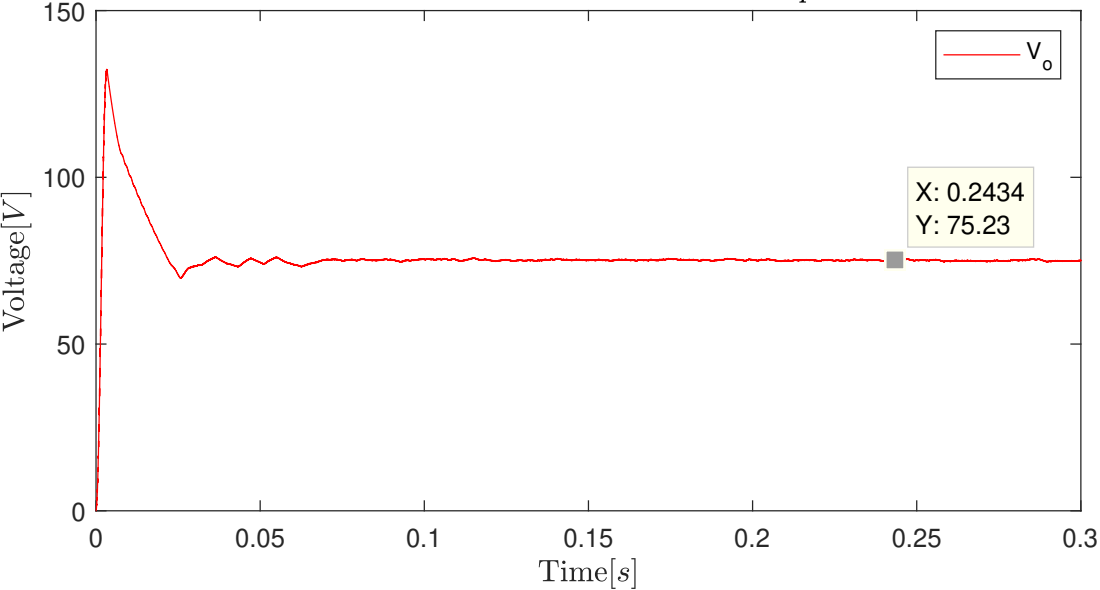
[picture p65: page 1]
