BlackAndWhiteSnaable/DC-DC/Report/figures/yMultiLevel/2Nx_SimResults.pdf

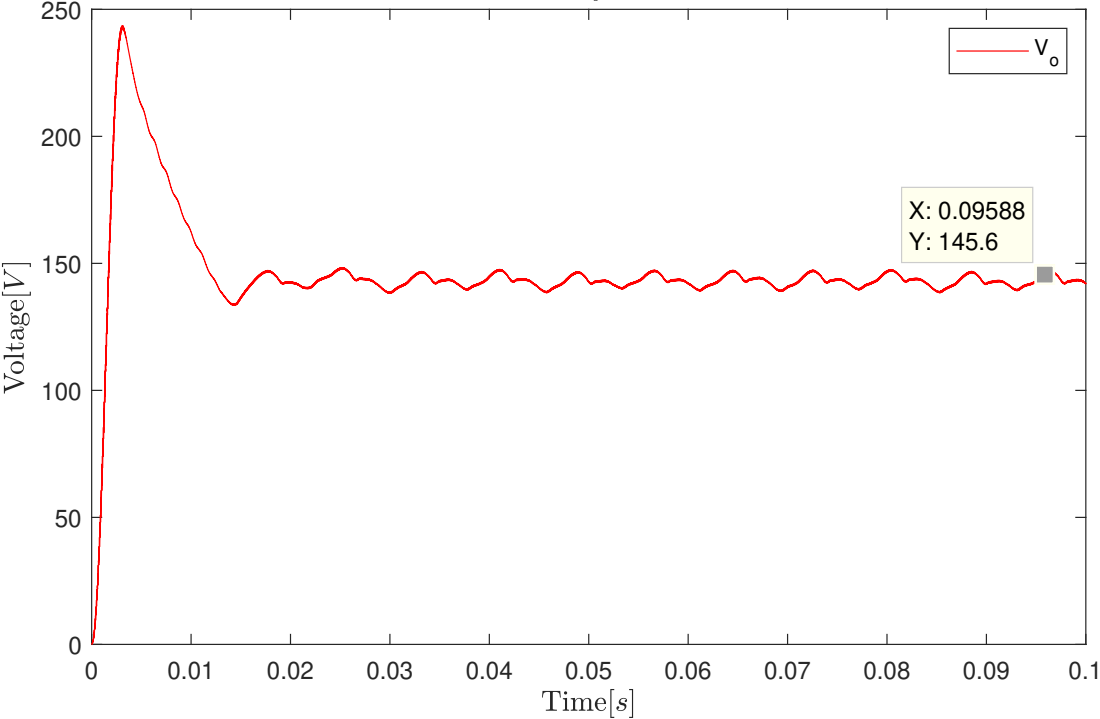
[picture p66: page 1]
