BlackAndWhiteSnaable/DC-DC/Report/figures/aConventionalBoost/LvAndLi-eps-converted-to.pdf

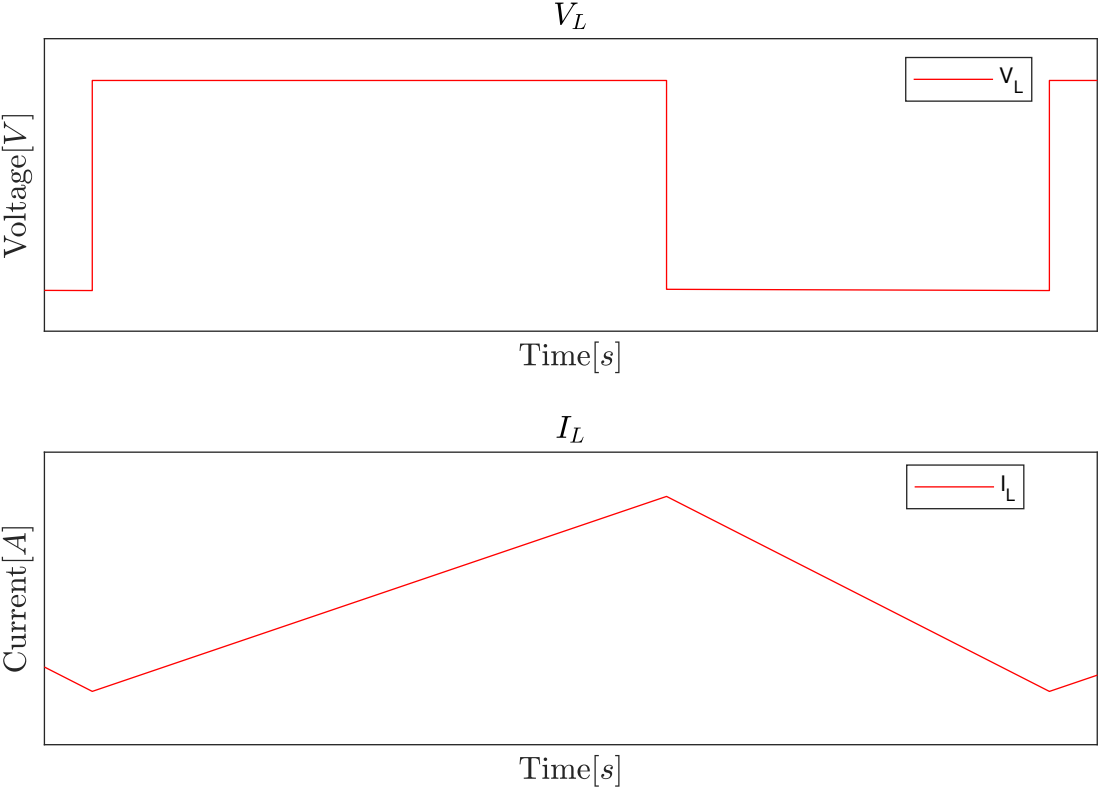
[picture p67: page 1]
