BlackAndWhiteSnaable/DC-DC/Report/figures/bSwitchedInductor/Switched_inductor.pdf

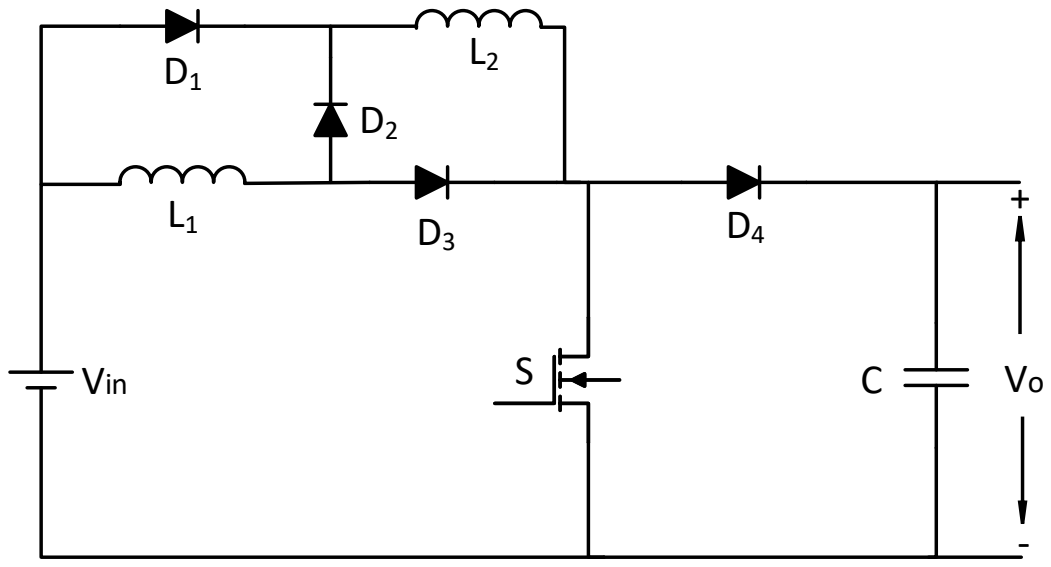
[picture p68: page 1]
Vin
