BlackAndWhiteSnaable/DC-DC/Report/figures/cSingleSwitchQuadraticBC/Quadratic_Boost.pdf

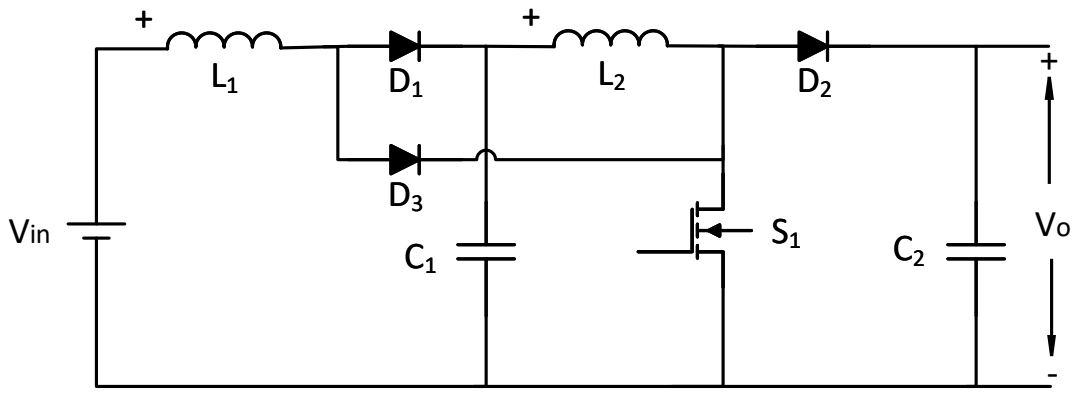
[picture p69: page 1]
Vin
