BlackAndWhiteSnaable/DC-DC/Report/figures/cSingleSwitchQuadraticBC/Quadratic_BoostOFF.pdf

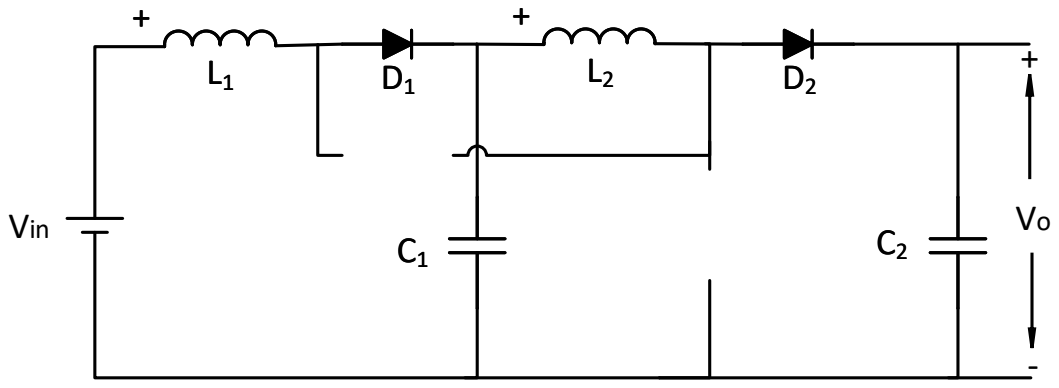
[picture p70: page 1]
Vin
