BlackAndWhiteSnaable/DC-DC/Report/figures/cSingleSwitchQuadraticBC/Quadratic_BoostON.pdf

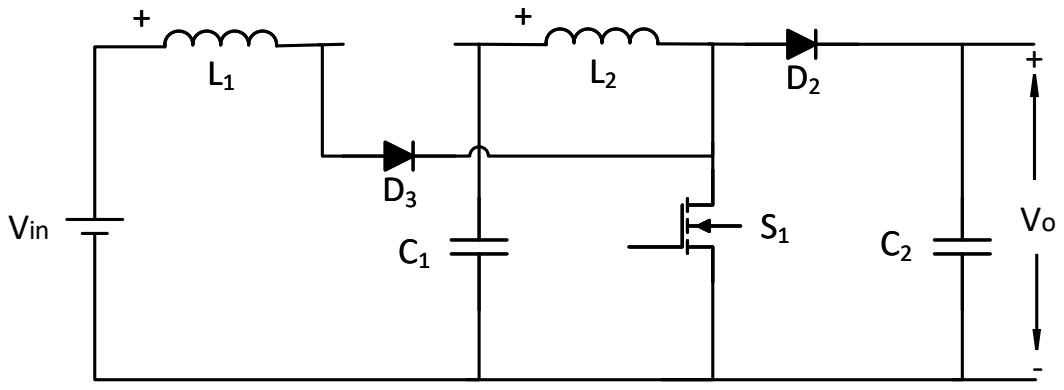
[picture p71: page 1]
Vin
