BlackAndWhiteSnaable/DC-DC/Report/figures/xCockroftWalton/capsV-eps-converted-to.pdf

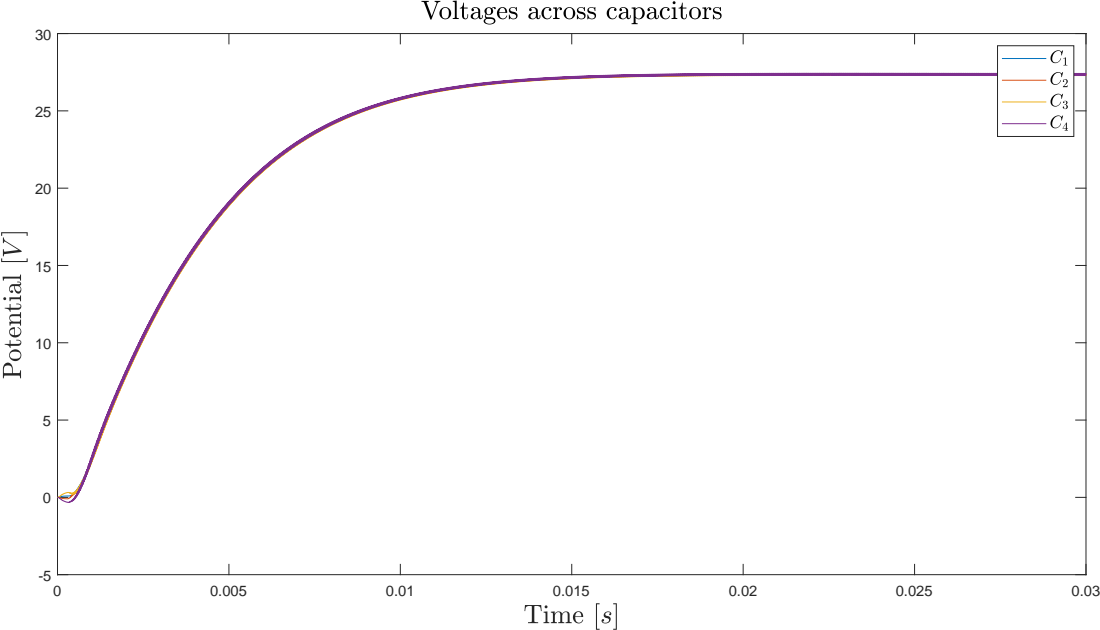
[picture p72: page 1]
