BlackAndWhiteSnaable/DC-DC/Report/figures/yMultiLevel/2Nx_full.pdf

+-

# Vop

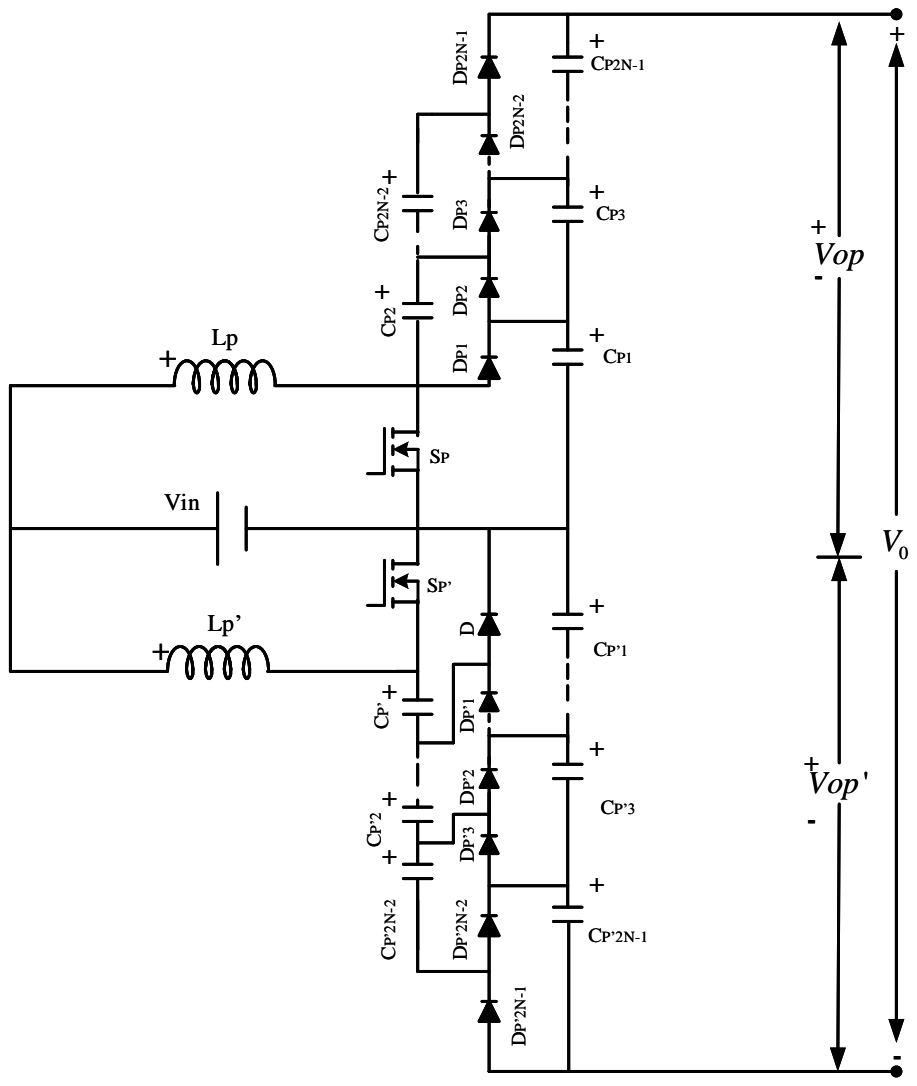
[picture p73: page 1]
Vop' -+ ++++++ +++++; CP2N-1 CP3 CP1 CP’1 CP’3 CP’2N-1 DP’2N⁻¹ DP²N⁻² DP’2N⁻² DP’3 DP’2 DP’1 D CP’2N⁻² CP’2 CP’; SP’ SP CP² CP²N⁻²; DP²N⁻¹ DP³ DP² D+; Vin +; Vop
