BlackAndWhiteSnaable/DC-DC/Report/figures/yMultiLevel/3x_FULL.pdf

+

+

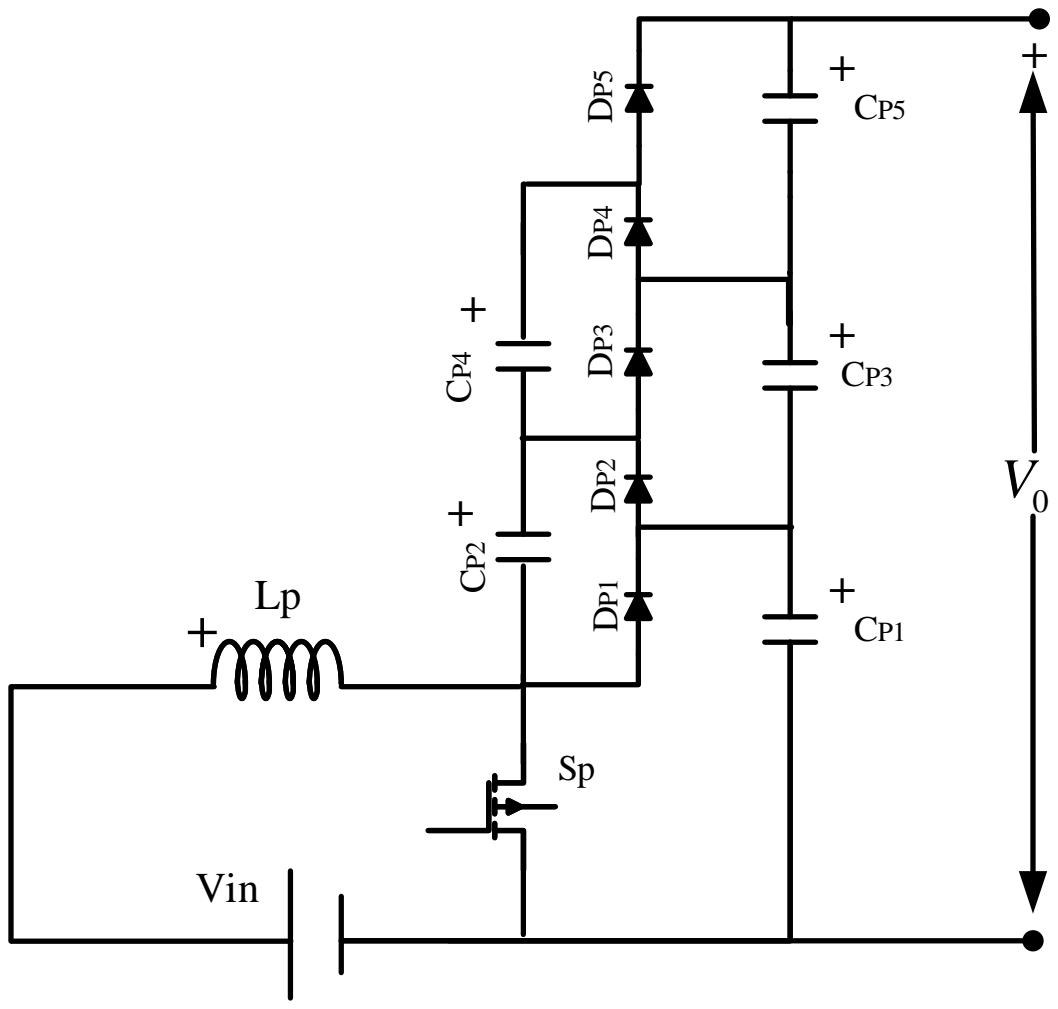
[picture p74: page 1]
Vin

V0 DP¹ DP³ DP⁵ DP² DP⁴
