BlackAndWhiteSnaable/DC-DC/Report/figures/yMultiLevel/3x_OFF.pdf

+

+

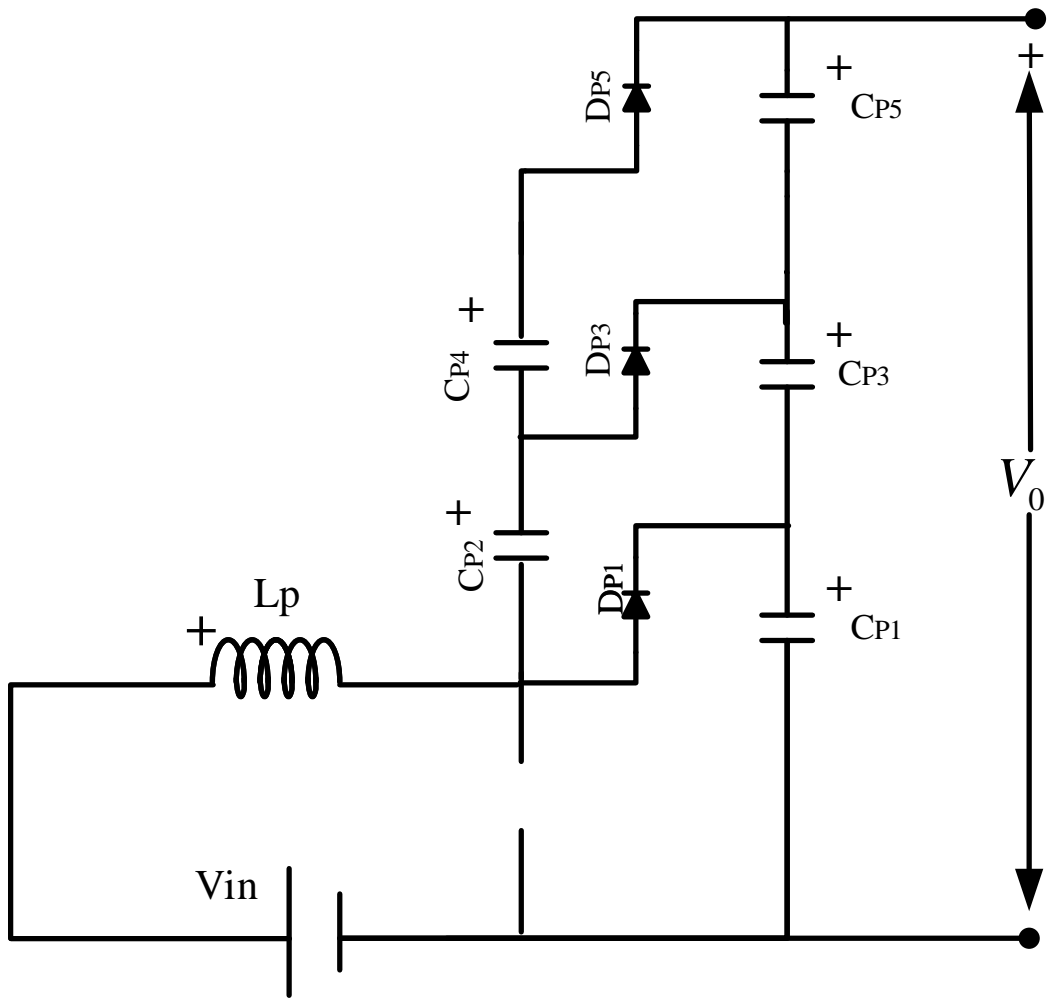
[picture p75: page 1]
Vin

V0 DP¹ DP³ DP⁵ DP¹
