BlackAndWhiteSnaable/DC-DC/Report/figures/yMultiLevel/3x_ON.pdf

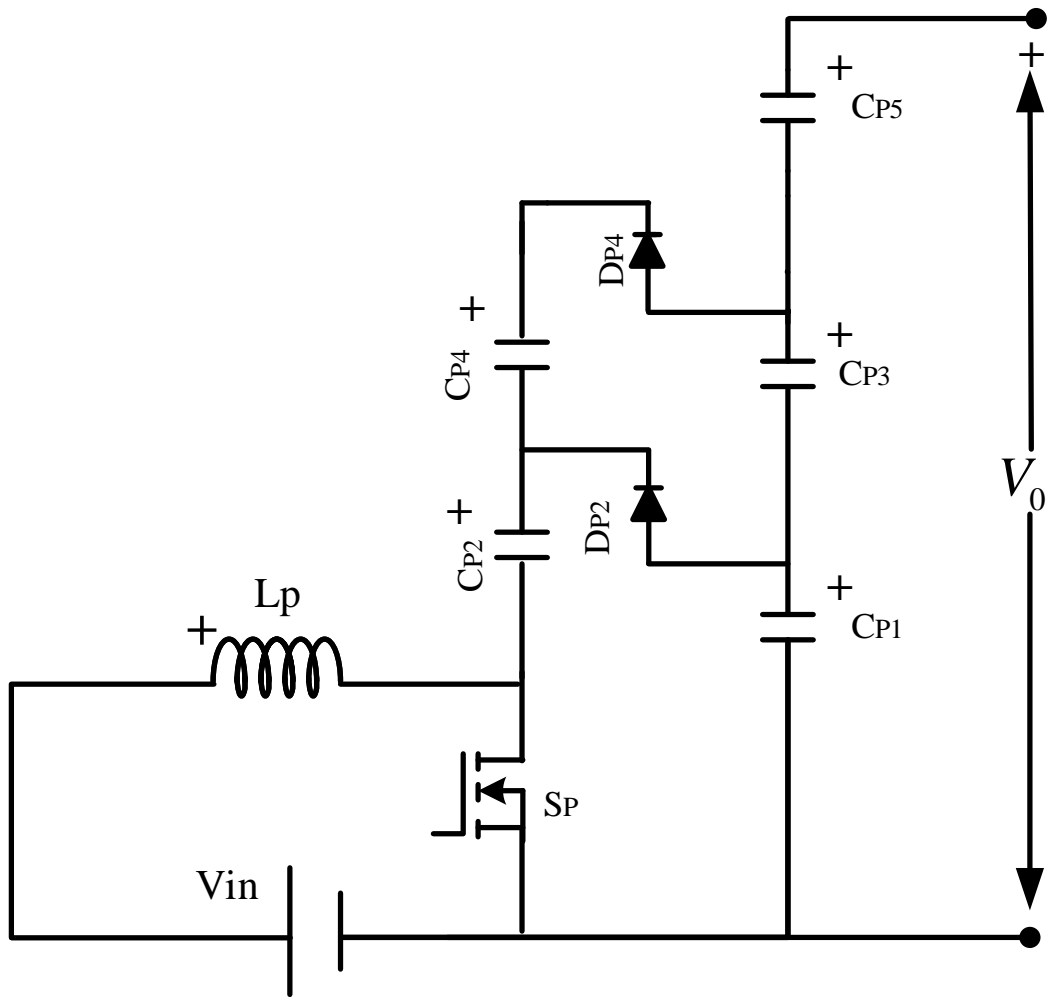
[picture p76: page 1]
Vin
