BlackAndWhiteSnaable/DC-DC/Report/figures/yMultiLevel/InvertingMBCforReport2.pdf

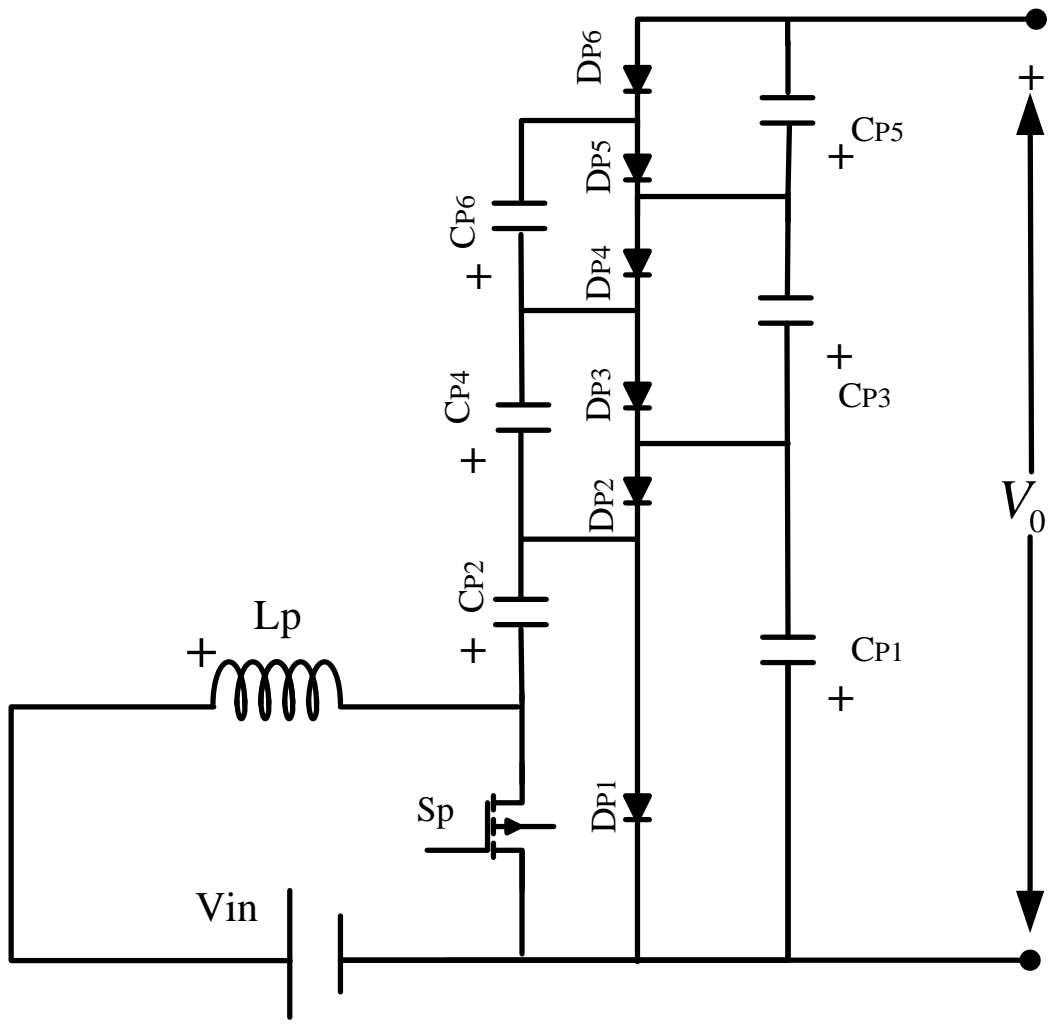
[picture p77: page 1]
Vin
