BlackAndWhiteSnaable/DC-DC/Report/figures/yy2NxMultilevelBC/2Nx_Appendix.pdf

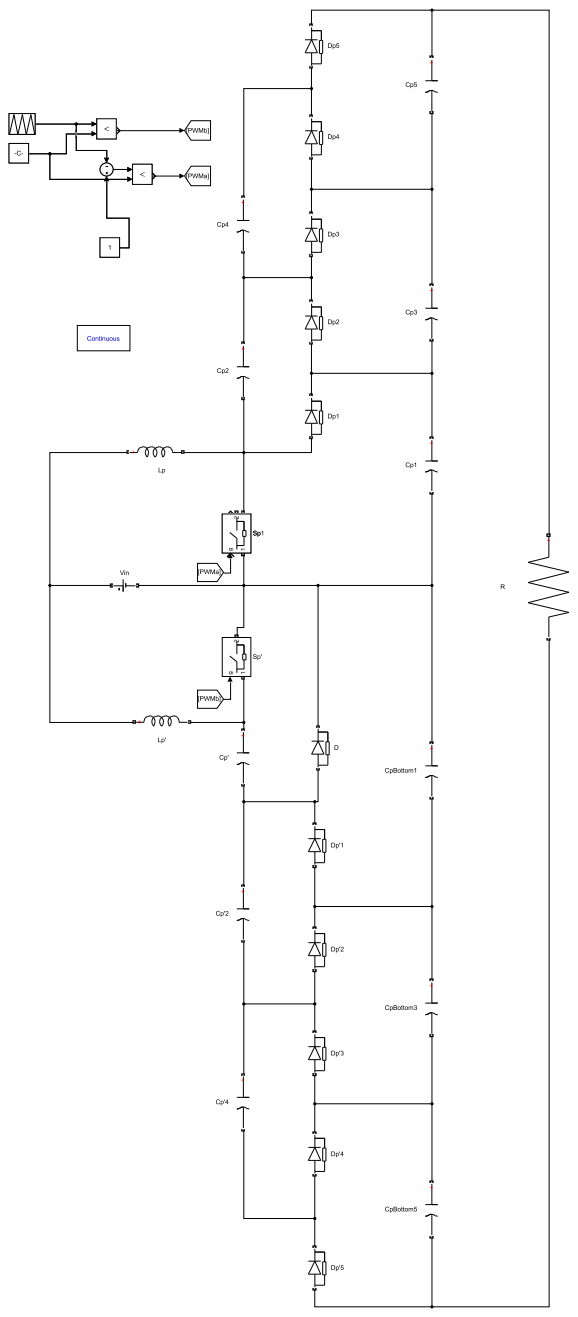
[picture p78: page 1]
