BlackAndWhiteSnaable/DC-DC/Report/figures/zComponentDrops/compare_LTSpice-eps-converted-to.pdf

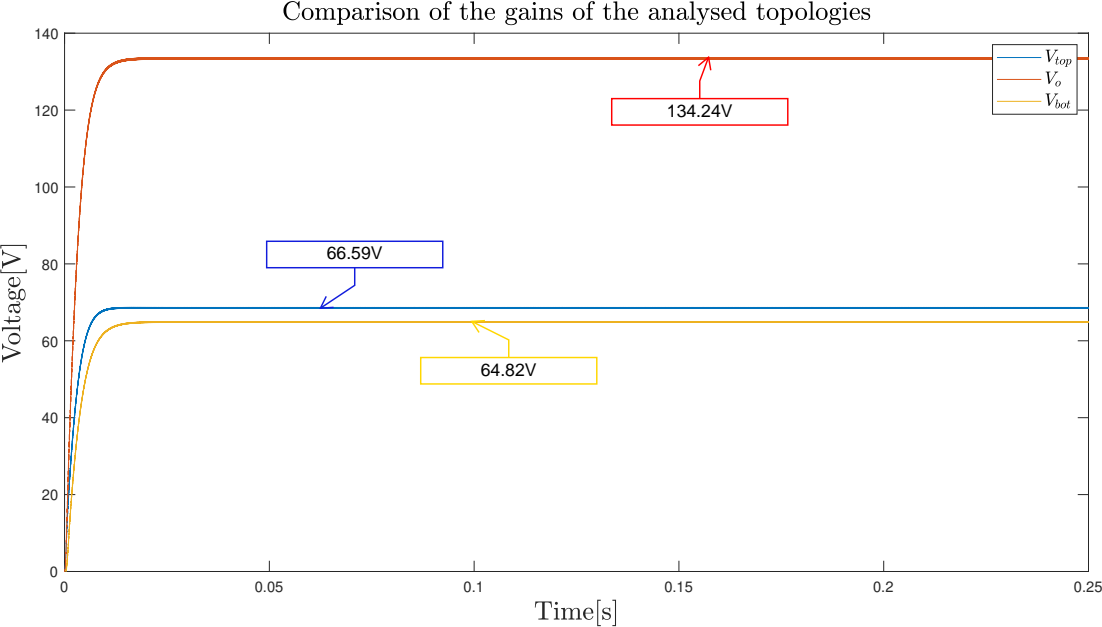
[picture p79: page 1]
