BlackAndWhiteSnaable/DC-DC/Report/figures/zComponentDrops/compare_LTSpice4.pdf

120

### 140 (http://www.tracker-software.com/product/pdf-xchange-editor)

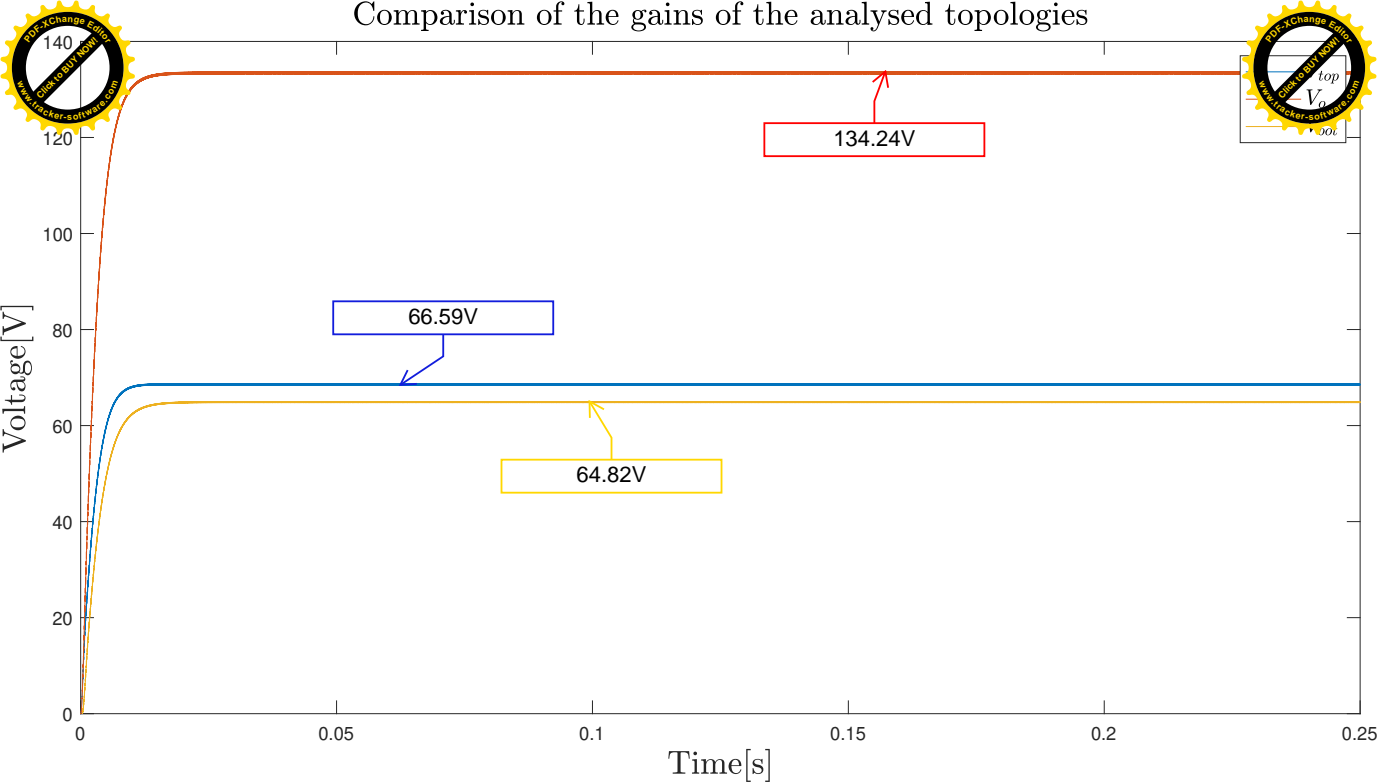
[picture p80: page 1]

PDF-XChange Editor

Click to BUY NOW!

www.tracker-software.com

www.tracker-software.com (http://www.tracker-software.com/product/pdf-xchange-editor)
