BlackAndWhiteSnaable/DC-DC/Report/figures/zComponentDrops/DROPS_LOOP1.pdf

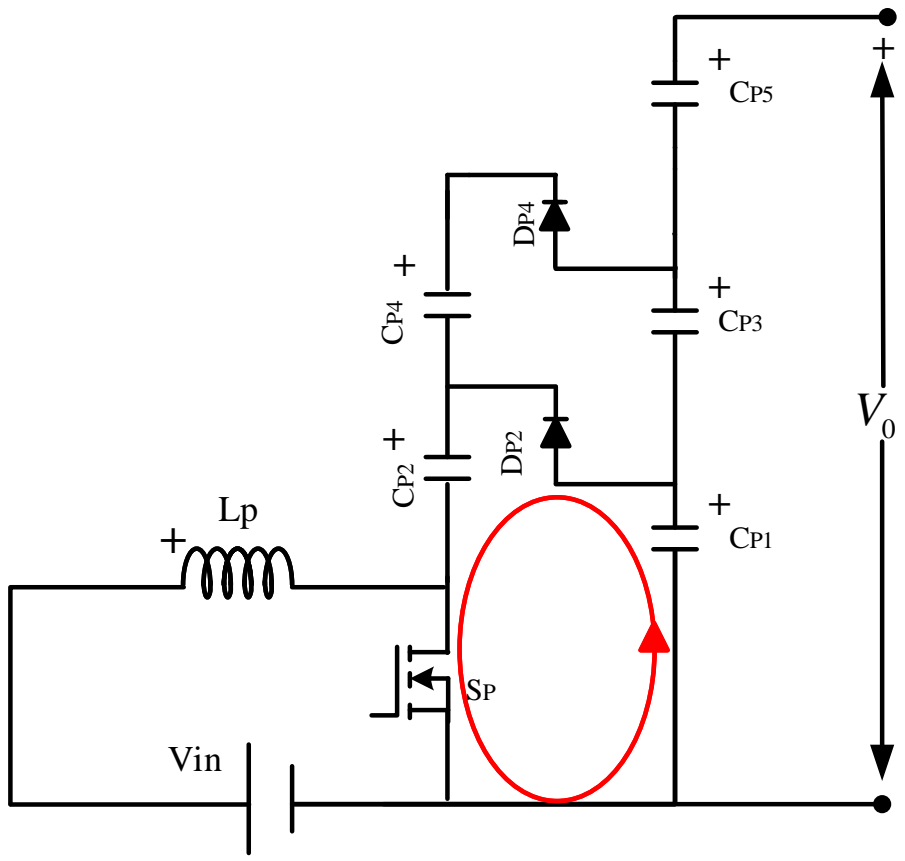
[picture p81: page 1]
Vin
