BlackAndWhiteSnaable/DC-DC/Report/figures/zComponentDrops/DROPS_LOOP2.pdf

+

+

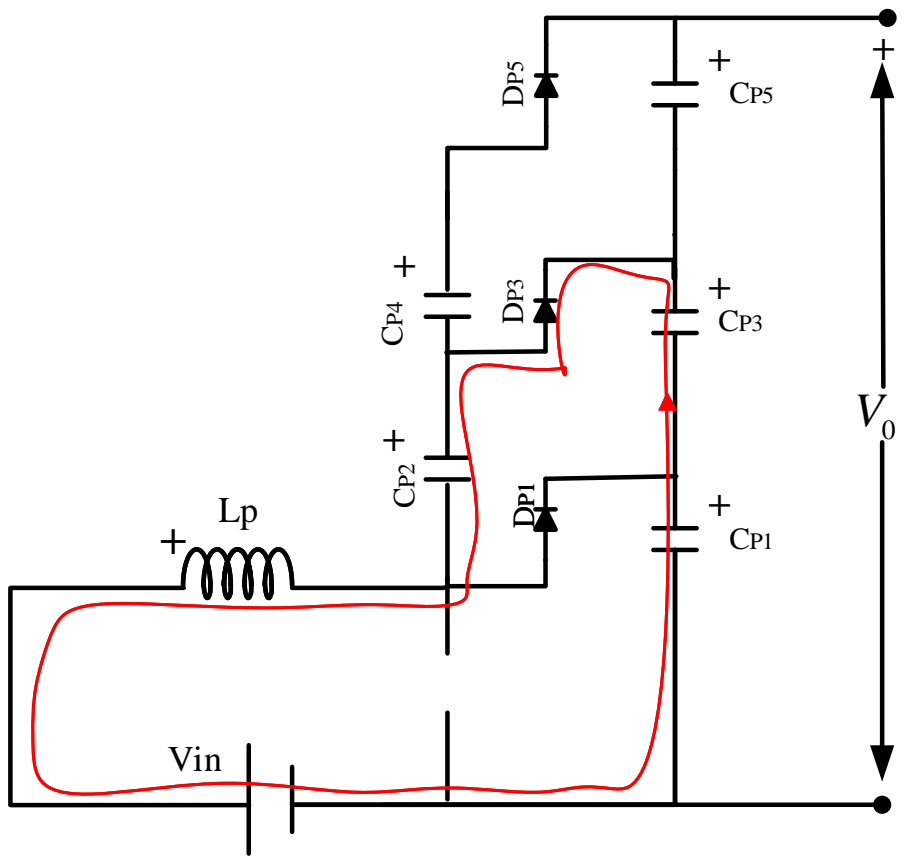
[picture p82: page 1]
Vin

V0 DP¹ DP³ DP⁵ DP¹
