BlackAndWhiteSnaable/DC-DC/Report/figures/zComponentDrops/DROPS_LOOP3.pdf

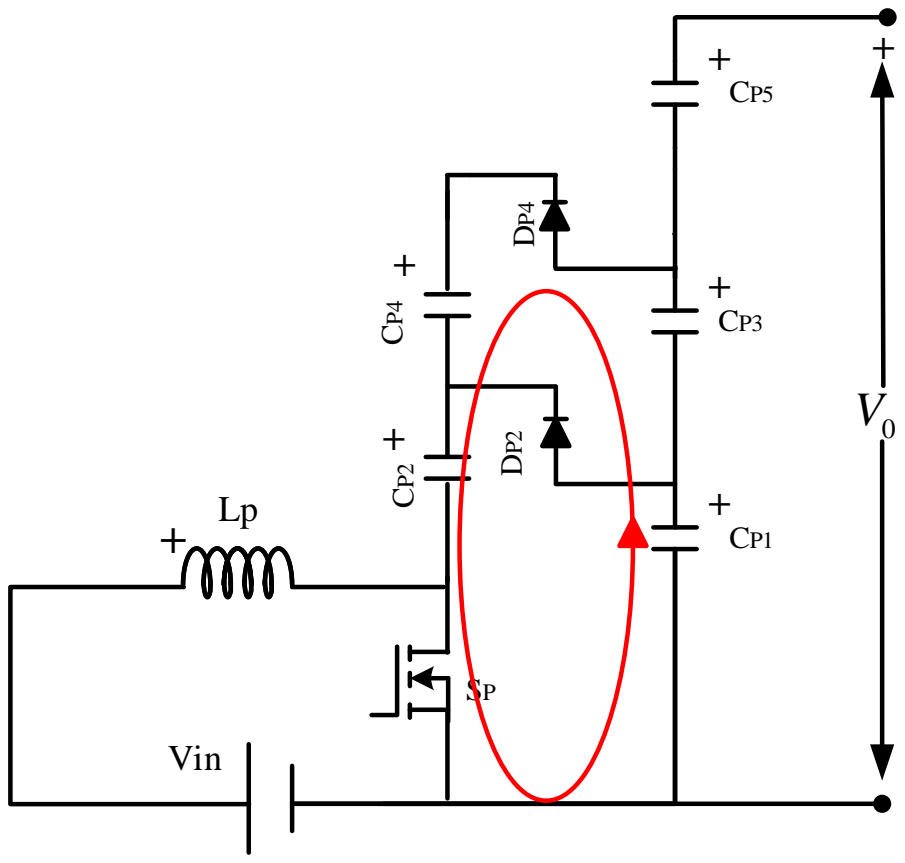
[picture p83: page 1]
Vin
