BlackAndWhiteSnaable/DC-DC/Report/figures/zComponentDrops/DROPS_LOOP4.pdf

+

+

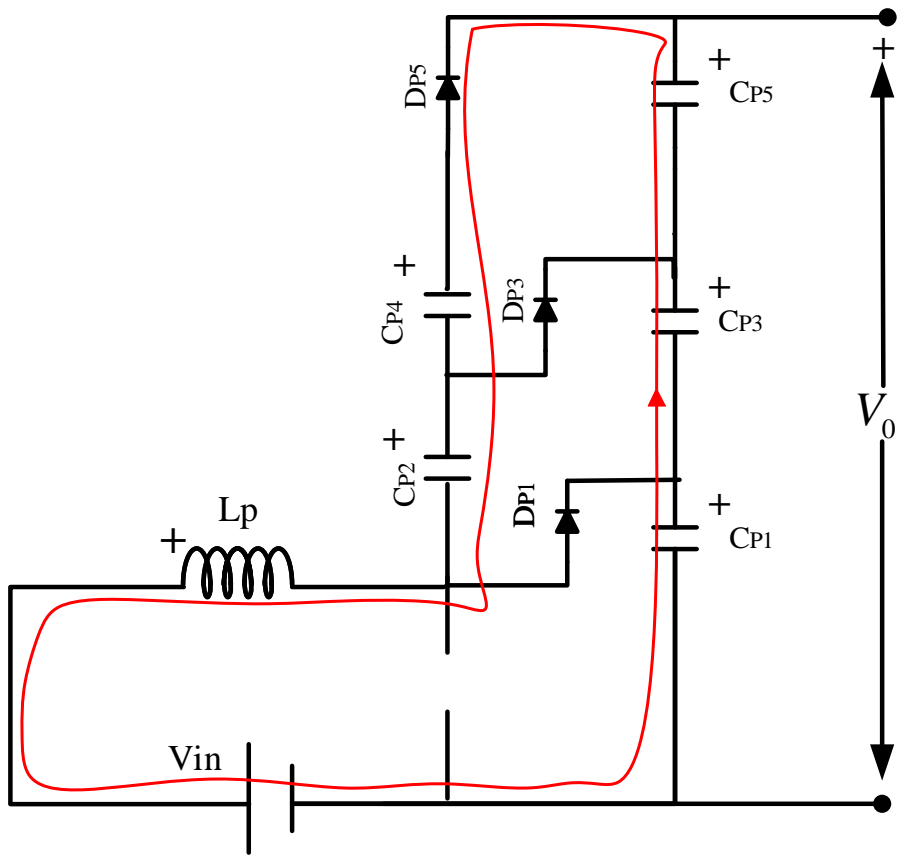
[picture p84: page 1]
Vin; V0 DP¹ DP³ DP⁵; DP¹
