BlackAndWhiteSnaable/DC-DC/Report/figures/aConventionalBoost/CBC_I_CtoI_out-eps-converted-to.pdf

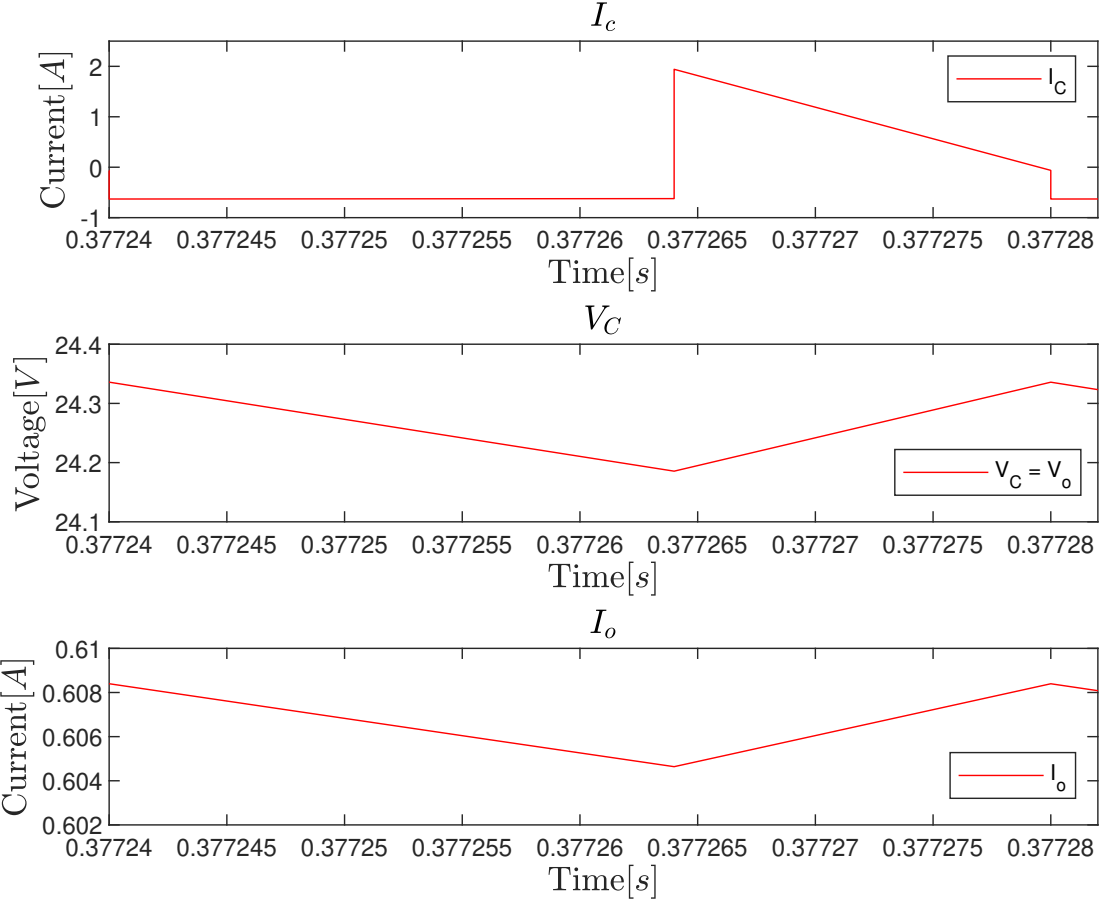
[picture p85: page 1]
