BlackAndWhiteSnaable/DC-DC/Report/figures/aConventionalBoost/CBCpic.pdf

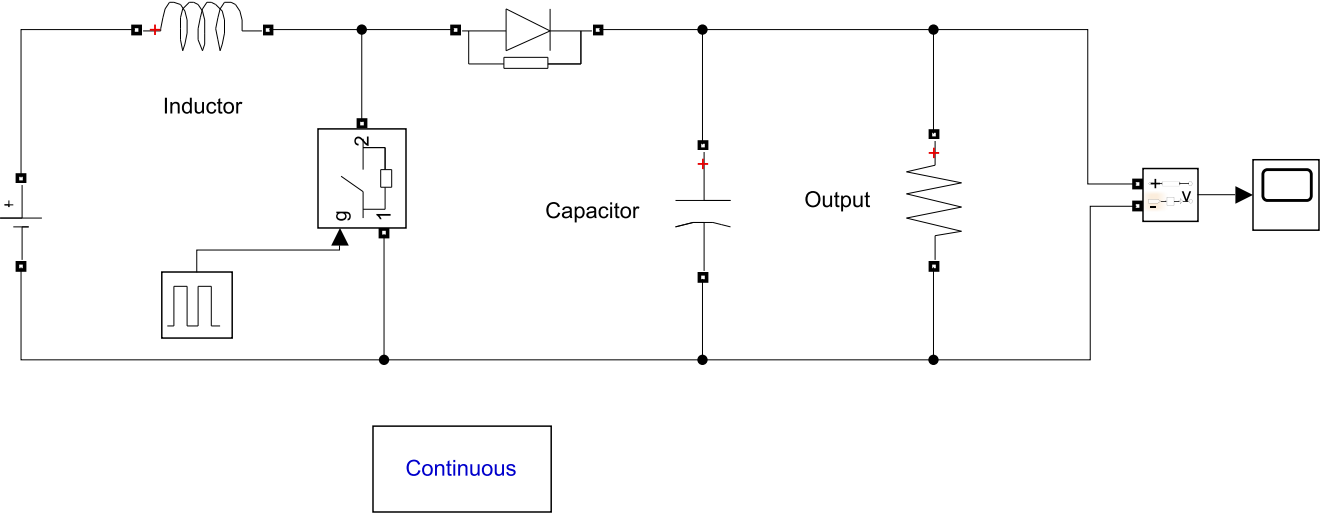
[picture p86: page 1]
