BlackAndWhiteSnaable/DC-DC/Report/figures/xCockroftWalton/CockroftWalton.pdf

C1
+

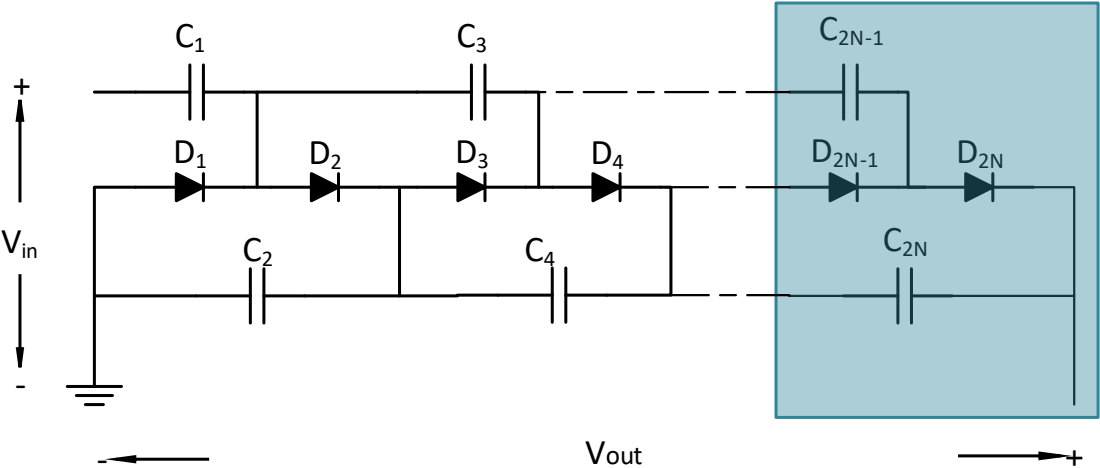
[picture p87: page 1]
- Vout; Vin
