BlackAndWhiteSnaable/DC-DC/Report/figures/yy2NxMultilevelBC/2Nx_SimResults-eps-converted-to.pdf

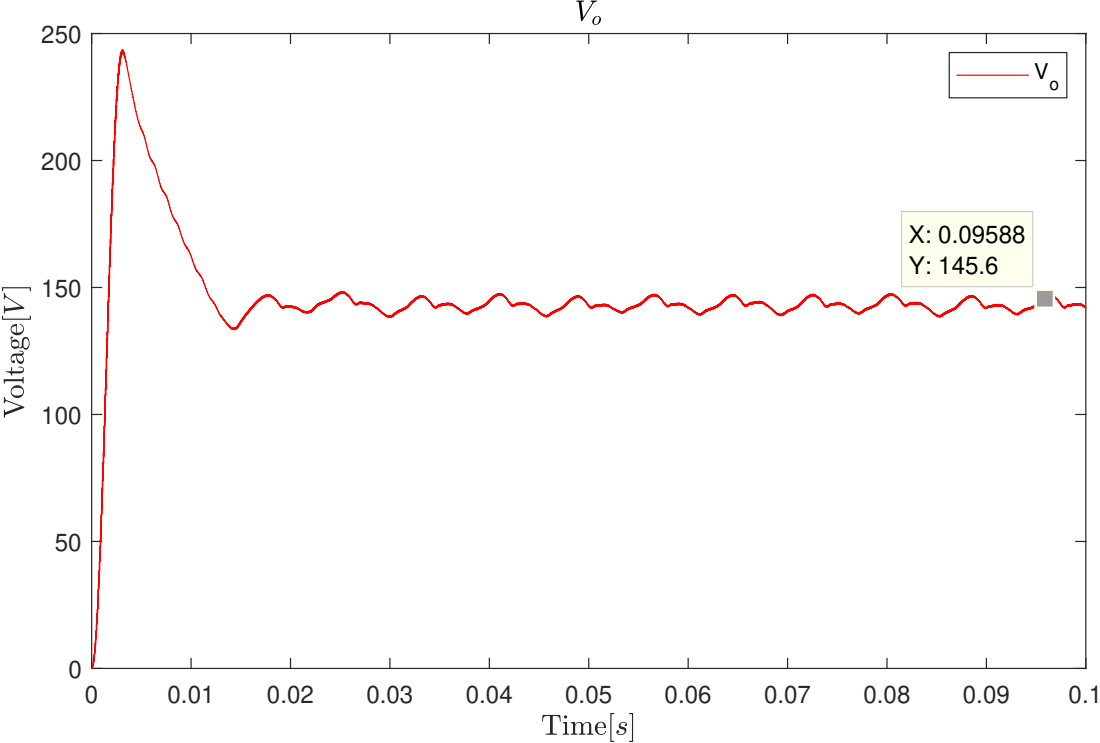
[picture p88: page 1]
