BlackAndWhiteSnaable/DC-DC/Report/figures/dConventionalThreeLevelBC/PWM1-eps-converted-to.pdf

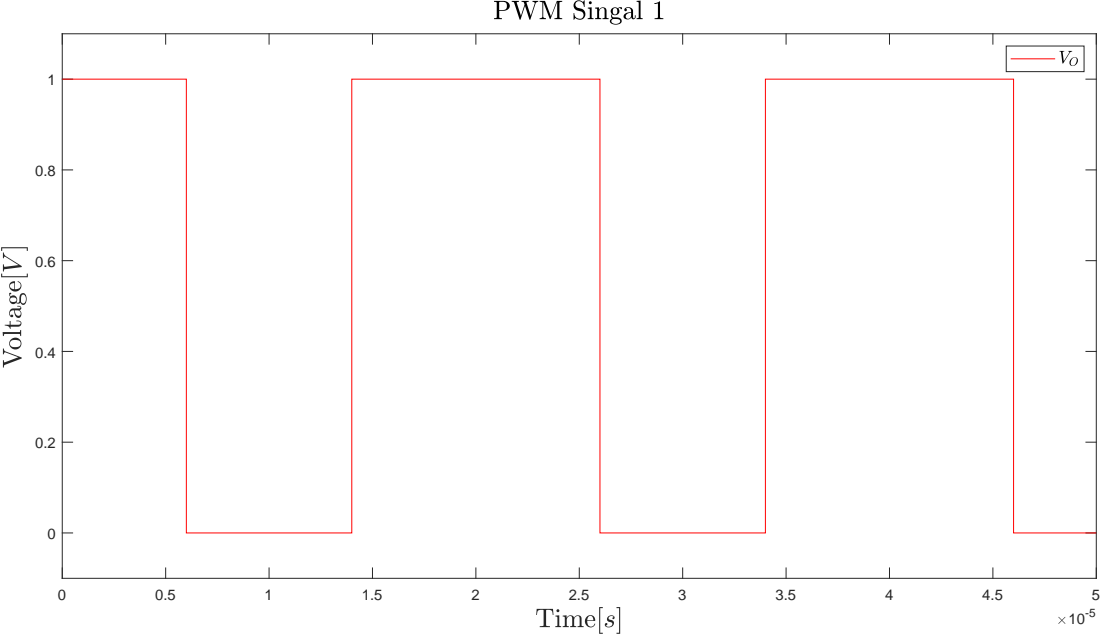
[picture p89: page 1]
