BlackAndWhiteSnaable/DC-DC/Report/figures/dConventionalThreeLevelBC/PWM2-eps-converted-to.pdf

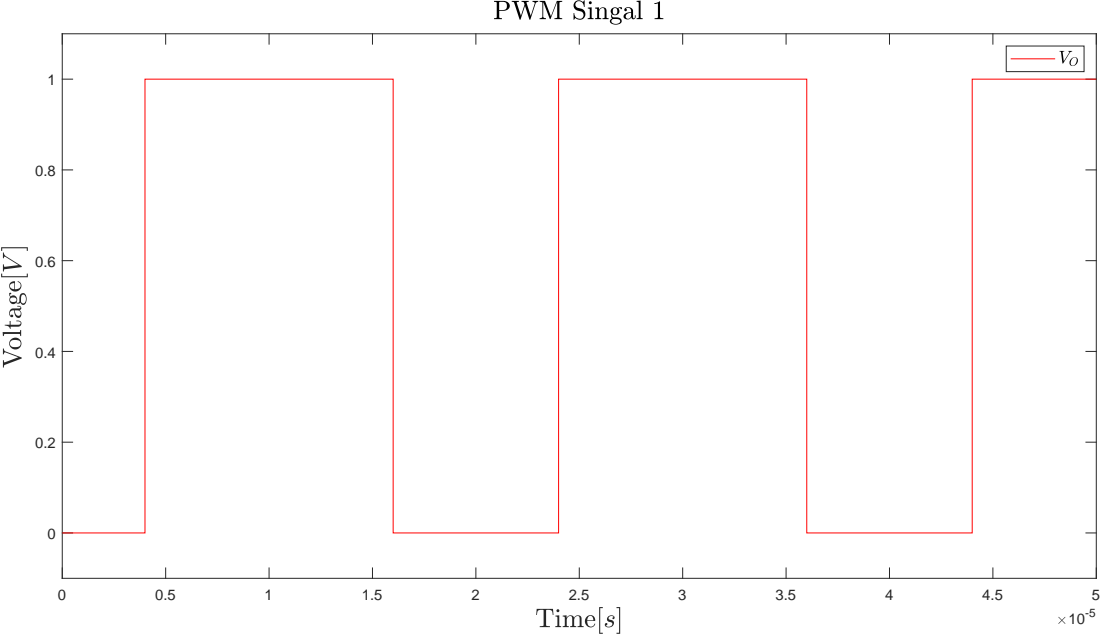
[picture p90: page 1]
