BlackAndWhiteSnaable/DC-DC/Report/figures/yMultiLevel/MCB_Simulation.pdf

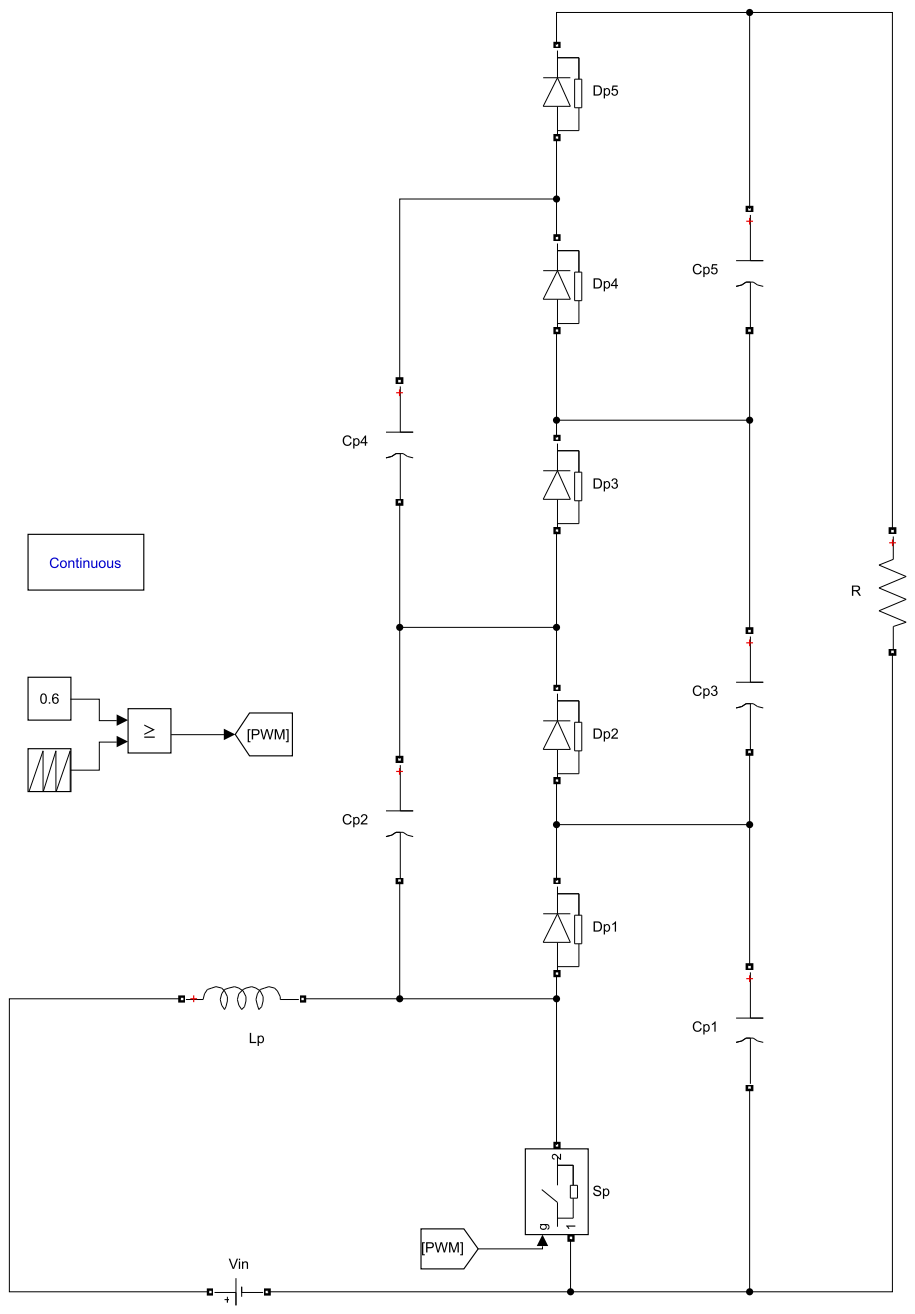
[picture p91: page 1]
