BlackAndWhiteSnaable/DC-DC/Report/figures/yMultiLevel/Non-invertingNx-eps-converted-to.pdf

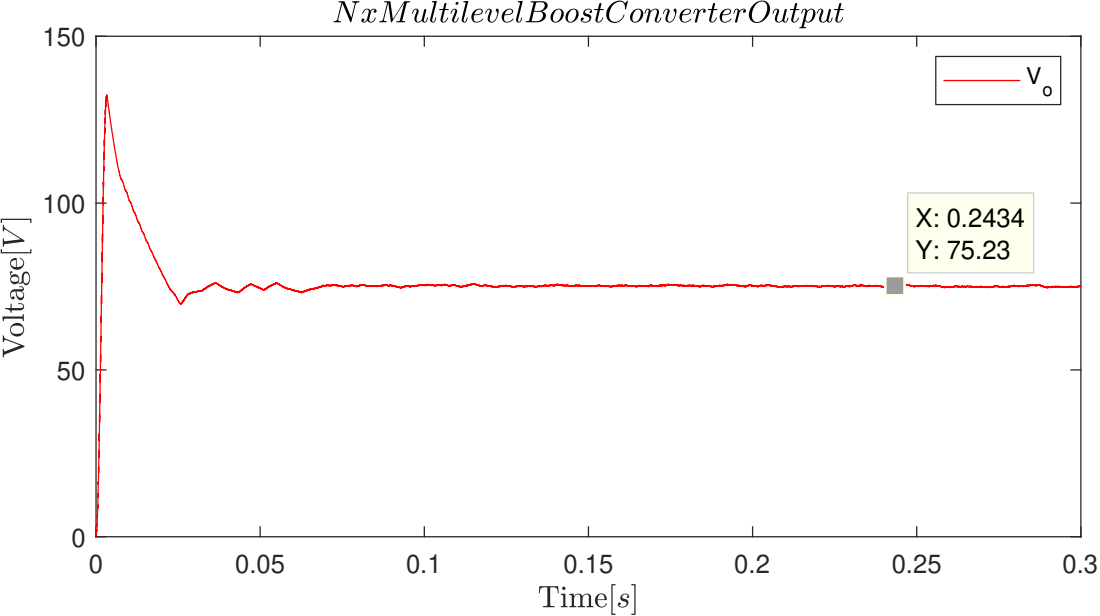
[picture p92: page 1]
