BlackAndWhiteSnaable/DC-DC/Report/figures/yMultiLevel/6x_full.pdf

+-

# Vop

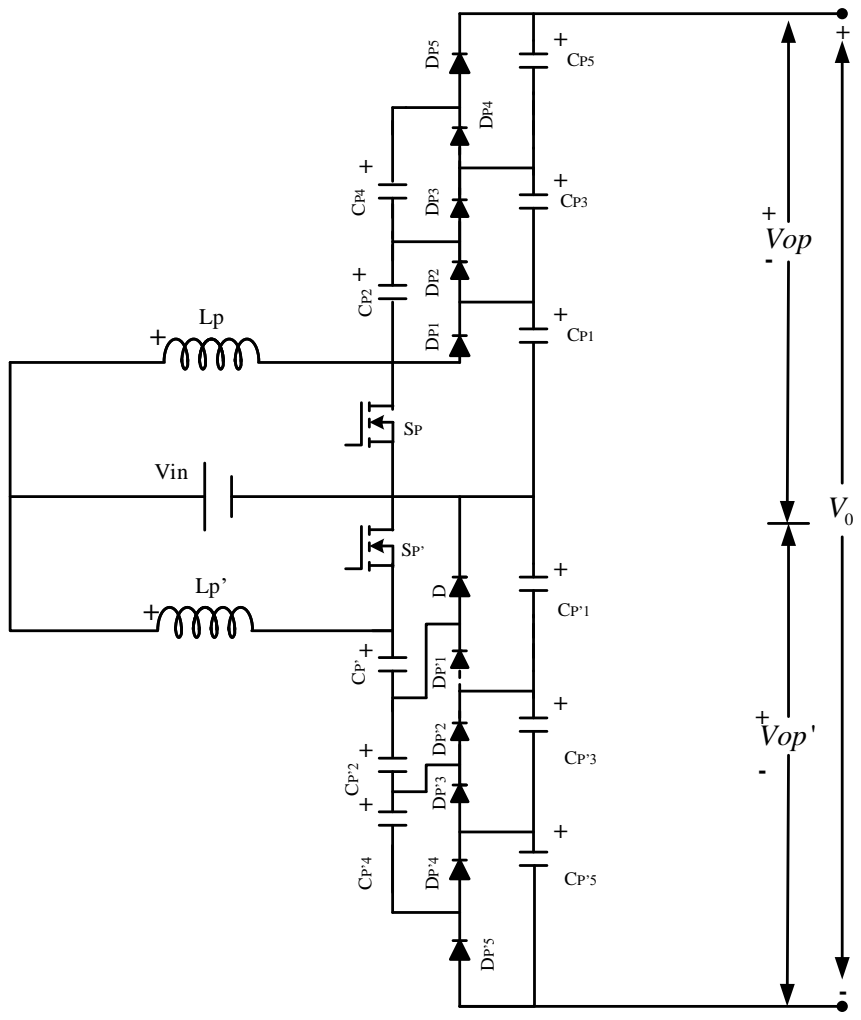
[picture p93: page 1]
Vop' -+ ++++++ +++++; CP5 CP3 CP1 CP’1 CP’3 CP’5 DP’5 DP⁴ DP’4 DP’3 DP’2 DP’1 D CP’4 CP’2 CP’; SP’ SP CP² CP⁴; DP⁵ DP³ DP² D+; Vin +
