BlackAndWhiteSnaable/DC-DC/Report/figures/yMultiLevel/6x_ONON.pdf

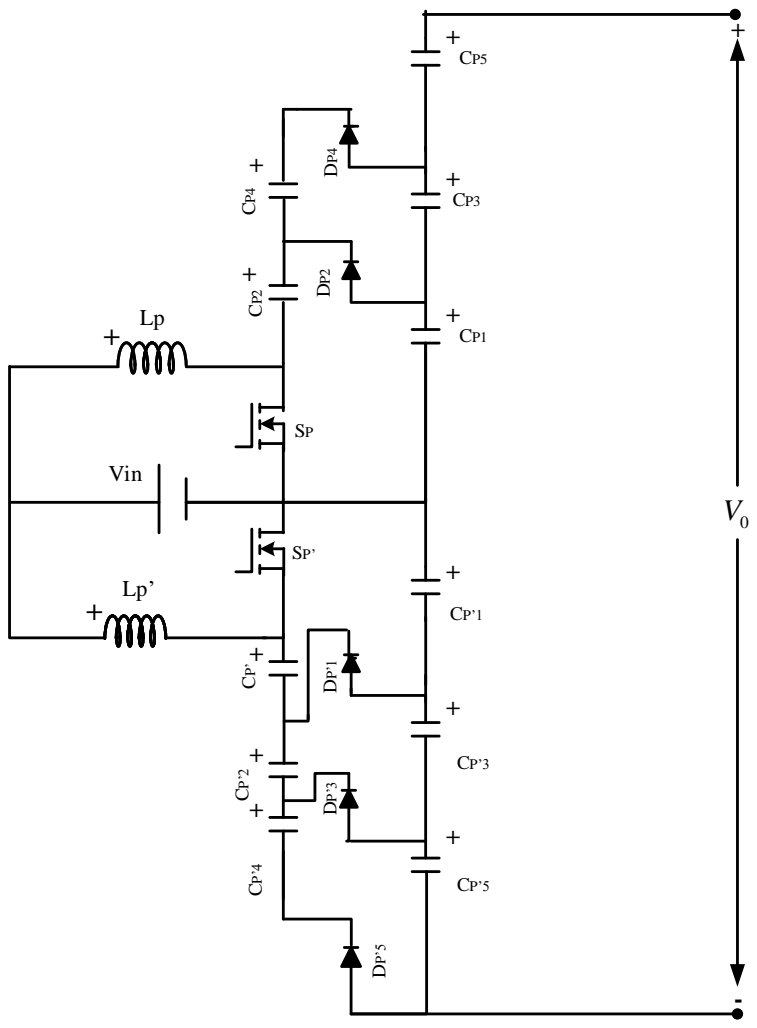
[picture p94: page 1]
Vin
