BlackAndWhiteSnaable/DC-DC/Simulations/Interleavedboostconverter/3NxMosfetDiode2.asc

C1: cap; {C}
C2: cap; {C}
C3: cap; {C}
C4: cap; {C}
C5: cap; {C}
C6: cap; {C}
C7: cap; {C}
C8: cap; {C}
C9: cap; {C}
C10: cap; {C}
C11: cap; {C}
D1: diode; STTH6012
D2: diode; STTH6012
D3: diode; STTH6012
D4: diode; STTH6012
D5: diode; STTH6012
D6: diode; STTH6012
D7: diode; STTH6012
D8: diode; STTH6012
D9: diode; STTH6012
D10: diode; STTH6012
D11: diode; STTH6012
L1: ind; {L}
L2: ind; {L}
R1: res; 2500
U3: nmos_TO247_3L; C2M0160120D
U4: nmos_TO247_3L; C2M0160120D
V1: voltage; PULSE(0 15 0 0 0 {1/{Freq} *{PWM12}} {1/{Freq}})
V2: voltage; {Vin}
V3: voltage; PULSE(0 15 {0*0.5/{Freq}} 0 0 {1/{Freq} *{PWM12}} {1/{Freq}})
V4: voltage; 25
Named nets: 0
.tran 0.02 startup
.param PWM12=0.6 Freq=50000 C=2.20u L=135u Vin=10
.include C2M0160120D.lib
.model STTH6012 D(Is=21.196E-6 N=3.1366 Rs=6.1729E-3 Cjo=586.19E-12 M=.41675 Vj=.85569 Nr=4.9950 Fc=0.5 tt=90.0000E-9 Ikf=.34615)
.model 1N914 D(Is=2.52n Rs=.568 N=1.752 Cjo=4p M=.4 tt=20n Iave=200m Vpk=75 mfg=OnSemi type=silicon)
