BlackAndWhiteSnaable/DC-DC/Simulations/Interleavedboostconverter/Conventionalboost.asc

C1: cap; {C}
C2: cap; {C}
C3: cap; {C}
D1: diode; STTH6012
D2: diode; STTH6012
D4: diode; STTH6012
L1: ind; {L}
L2: ind; {L}
R1: res; 22.5
U1: nmos_TO247_3L; C2M0160120D
U2: nmos_TO247_3L; C2M0160120D
V1: voltage; {Vin}
V2: voltage; PULSE(0 15 0 0 0 {1/{Freq} *{PWM12}} {1/{Freq}})
V3: voltage; PULSE(0 15 {0.5/{Freq}} 0 0 {1/{Freq} *{PWM12}} {1/{Freq}})
Named nets: 0
.tran 0.03 startup
.param PWM12=0.5 Freq=50000 C=220µ L=150µ Vin=10
.include C2M0160120D.lib
.model STTH6012 D(Is=21.196E-6 N=3.1366 Rs=6.1729E-3 Cjo=586.19E-12 M=.41675 Vj=.85569 Nr=4.9950 Fc=0.5 tt=90.0000E-9 Ikf=.34615)
