BlackAndWhiteSnaable/DC-DC/Simulations/Interleavedboostconverter/Mosfettestin.asc

M1: nmos; BSB014N04LX3
R1: res; 100
R2: res; 100
U1: nmos_TO247_3L; C2M0160120D
V1: voltage; PULSE(0 15 0 0 0 {1/{Freq} *{PWM12}} {1/{Freq}})
V2: voltage; 100
V3: voltage; 100
V4: voltage; 150
Named nets: 0
.tran 0.025
.include C2M0160120D.lib
.param Freq=50000 PWM12=0.8
