BlackAndWhiteSnaable/DC-DC/Simulations/Interleavedboostconverter/3NxMosfet.asc

C1: cap; {C}
C2: cap; {C}
C3: cap; {C}
C4: cap; {C}
C5: cap; {C}
C6: cap; {C}
C7: cap; {C}
C8: cap; {C}
C9: cap; {C}
C10: cap; {C}
C11: cap; {C}
D1: diode
D2: diode
D3: diode
D4: diode
D5: diode
D6: diode
D7: diode
D8: diode
D9: diode
D10: diode
D11: diode
L1: ind; {L}
L2: ind; {L}
R1: res; 225
U3: nmos_TO247_3L; C2M0160120D
U4: nmos_TO247_3L; C2M0160120D
V1: voltage; PULSE(0 15 0 0 0 {1/{Freq} *{PWM12}} {1/{Freq}})
V2: voltage; {Vin}
V3: voltage; PULSE(0 15 {0.5/{Freq}} 0 0 {1/{Freq} *{PWM12}} {1/{Freq}})
Named nets: 0
.tran 0.03 startup
.param PWM12=0.7 Freq=50000 C=2.20µ L=150µ Vin=10
.include C2M0160120D.lib
