BlackAndWhiteSnaable/DC-DC/Simulations/Interleavedboostconverter/3Nx.asc

C1: cap; {C}
C2: cap; {C}
C3: cap; {C}
C4: cap; {C}
C5: cap; {C}
C6: cap; {C}
C7: cap; {C}
C8: cap; {C}
C9: cap; {C}
C10: cap; {C}
C11: cap; {C}
D1: diode
D2: diode; 1N914
D3: diode
D4: diode; 1N914
D5: diode
D6: diode
D7: diode
D8: diode
D9: diode
D10: diode
D11: diode
L1: ind; {L}
L2: ind; {L}
R1: res; 225
S1: sw
S2: sw
V1: voltage; PULSE(-1 1 0 0 0 {1/{Freq} *{PWM12}} {1/{Freq}})
V2: voltage; 20
V3: voltage; PULSE(-1 1 {0.5/{Freq}} 0 0 {1/{Freq} *{PWM12}} {1/{Freq}})
Named nets: 0
.tran 0.025 startup
.model SW SW()
.param PWM12=0.6 Freq=50000 C=2.2µ L=150µ
