BlackAndWhiteSnaable/DC-DC/Simulations/Interleavedboostconverter/1Nxsingleinvert.asc

C2: cap; 3.46µ
C5: cap; 3.46µ
C6: cap; 3.46µ
C7: cap; 3.46µ
D2: diode
D5: diode
D6: diode
D7: diode
L1: ind; 22m
R1: res; 100
S2: sw
V2: voltage; 20
V3: voltage; PULSE(-1 1 {0.5/{Freq}} 0 0 {1/{Freq} *{PWM12}} {1/{Freq}})
Named nets: 0
.tran 0.025
.model SW SW()
.param PWM12=0.5 Freq=50000
