BlackAndWhiteSnaable/DC-DC/Simulations/Interleavedboostconverter/3Nxsingle.asc

C1: cap; 3.46µ
C2: cap; 3.46µ
C3: cap; 3.46µ
C4: cap; 3.46µ
C5: cap; 3.46µ
C6: cap; 3.46µ
C7: cap; 3.46µ
D1: diode
D2: diode
D3: diode
D4: diode
D5: diode
D6: diode
D7: diode
L2: ind; 22m
R1: res; 100
S1: sw
V1: voltage; PULSE(-1 1 0 0 0 {1/{Freq} *{PWM12}} {1/{Freq}})
V2: voltage; 20
Named nets: 0
.tran 0.025
.model SW SW()
.param PWM12=0.5 Freq=50000
