BlackAndWhiteSnaable/DC-DC/Simulations/Interleavedboostconverter/1NxMosfet.asc

C1: cap; 2.2µ; V=450
C2: cap; 2.2µ; V=450
C3: cap; 2.2µ; V=450
C4: cap; 2.2µ; V=450
C5: cap; 2.2µ; V=450
C6: cap; 2.2µ; V=450
C7: cap; 2.2µ; V=450
D1: diode
D2: diode
D3: diode
D4: diode
D5: diode
D6: diode
D7: diode
L1: ind; 100µ; Ipk=15
L2: ind; 100µ; Ipk=15
R1: res; 100
U1: nmos_TO247_3L; C2M0160120D
U2: nmos_TO247_3L; C2M0160120D
V1: voltage; PULSE(0 15 0 0 0 {1/{Freq} *{PWM12}} {1/{Freq}})
V2: voltage; 20
V3: voltage; PULSE(0 15 {0.5/{Freq}} 0 0 {1/{Freq} *{PWM12}} {1/{Freq}})
Named nets: 0
.tran 0.025
.param PWM12=0.5 Freq=50000
.include C2M0160120D.lib
