BlackAndWhiteSnaable/DC-DC/Simulations/Buckconverter01/LTSpice/PWMGenerationforBoostconverterD.asc

U1: UniversalOpamp2
U3: UniversalOpamp2
V1: voltage; PULSE(-1 1 0 0 0 {0.2m*{PWM}} 0.2m)
V2: voltage; PULSE(1 -1 0 0 0 {0.2m*{1-PWM}} 0.2m)
V3: voltage; PULSE(0 100 0 0.1m 0.1m 0 0.2m)
V4: voltage; 25
V5: voltage; 1
V6: voltage; 1
V7: voltage; PULSE(-1 1 0 0 0 {1/{Freq} *{PWM}} {1/{Freq}})
V8: voltage; PULSE(-1 1 {0.5/{Freq}} 0 0 {1/{Freq} *{PWM}} {1/{Freq}})
Named nets: 0, V+, V-
.tran 0.01
.param PWM=0.80 Freq=5000
V1
V2
