BlackAndWhiteSnaable/DC-DC/Simulations/Buckconverter01/LTSpice/Boostconverter.asc

C1: cap; 3.46µ
D1: diode
L1: ind; 22m
R1: res; 7.225
S1: sw
U2: UniversalOpamp2
V1: voltage; 20
V2: voltage; 1
V4: voltage; PULSE(0 100 0 0.1m 0.1m 0 0.2m)
V5: voltage; 85
V6: voltage; 1
Named nets: 0
V1
V2
.tran 0.1 startup
.model SW SW()
