BlackAndWhiteSnaable/DC-DC/Simulations/Buckconverter01/LTSpice/BoostconverterD.asc

C1: cap; 3.46µ
C2: cap; 3.46µ
C3: cap; 3.46µ
D1: diode
D2: diode
L1: ind; 22m
R1: res; 100
R2: res; 1k
R3: res; 1k
R4: res; 1k
R5: res; 100k
R6: res; 100k
S1: sw
S2: sw
U1: UniversalOpamp2
U2: UniversalOpamp2
U3: UniversalOpamp2
V1: voltage; 20
V2: voltage; 1
V3: voltage; 100
V4: voltage; PULSE(0 100 0 0.1m 0.1m 0 0.2m)
V5: voltage; 25
V6: voltage; 1
Named nets: 0, V+, V-
V1
V2
.tran 0.01 startup
.model SW SW()
