BlackAndWhiteSnaable/DC-DC/Simulations/Buckconverter01/LTSpice/BoostconverterD2.asc

C1: cap; 3.46µ
C2: cap; 3.46µ
C3: cap; 3.46µ
D1: diode
D2: diode
L1: ind; 22m
R1: res; 100
S1: sw
S2: sw
V1: voltage; 20
V2: voltage; PULSE(-1 1 0 0 0 {0.2m*{PWM}} 0.2m)
V3: voltage; PULSE(1 -1 0 0 0 {0.2m*{1-PWM}} 0.2m)
Named nets: 0
.tran 0.1 startup
.model SW SW()
.param PWM=0.8
