BlackAndWhiteSnaable/DC-DC/Simulations/Buckconverter01/LTSpice/BoostconverterF.asc

C1: cap; 3.46µ
C2: cap; 3.46µ
C3: cap; 3.46µ
D1: diode
D2: diode
D3: diode
L1: ind; 22m
L2: ind; 22m
R1: res; 100
S1: sw
S2: sw
S3: sw
V1: voltage; PULSE(-1 1 0 0 0 {0.2m*{PWM12}} 0.2m)
V2: voltage; 20
V3: voltage; PULSE(1 -1 0 0 0 {0.2m*{PWM12}} 0.2m)
V4: voltage; PULSE(-1 1 0 0 0 {0.2m*{PWM3}} 0.2m)
Named nets: 0
.tran 0.025
.model SW SW()
.param PWM12=0.2 PWM3=50
