BlackAndWhiteSnaable/DC-DC/Simulations/Buckconverter01/LTSpice/BoostconverterFfirsthalf.asc

C1: cap; 3.46µ
C2: cap; 3.46µ
D1: diode
R1: res; 1000
S1: sw
S2: sw
V1: voltage; PULSE(-1 1 0 0 0 {0.2m*{PWM}} 0.2m)
V2: voltage; 20
V3: voltage; PULSE(1 -1 0 0 0 {0.2m*{PWM}} 0.2m)
Named nets: 0
.tran 0.1
.model SW SW()
.param PWM=0.80
