BlackAndWhiteSnaable/DC-DC/Simulations/Buckconverter01/LTSpice/boostedInductor3.asc

C1: cap; 3.46µ
D1: diode
D2: diode
L1: ind; 11m
L2: ind; 11m
R1: res; 7.225
S1: sw
U1: UniversalOpamp2
V1: voltage; 200
V2: voltage; PULSE(0 100 0 0.1m 0.1m 0 0.2m)
V3: voltage; 85
V4: voltage; 1
V5: voltage; 1
Named nets: 0
V1
V2
.tran 0.1 startup
.model SW SW()
