BlackAndWhiteSnaable/DC-DC/Simulations/Buckconverter01/LTSpice/bosstedInductor.asc

D1: diode
D2: diode
D3: diode
D4: diode
L1: ind; 20m
L2: ind; 20m
L3: ind; 20m
L4: ind; 20m
V1: voltage
Named nets: 0
