BlackAndWhiteSnaable/DC-DC/(list of files, drawings)

Other design files:
DipTrace/2nx_IEEE PEMC_2016.dip
DipTrace/2NX_interleaved_DANIEL_EDIT.dip
DipTrace/2NX_interleaved_EAGLE_IMPORT.dch
DipTrace/2NX_interleaved_SAGAR.dip
