BlackAndWhiteSnaable/DC-DC/EAGLE/projects/New_Project_2/3level_2NX_interleaved_boost_converter.brd

## EAGLE design EAGLE/projects/New_Project_2/3level_2NX_interleaved_boost_converter.brd (2018-11-28)

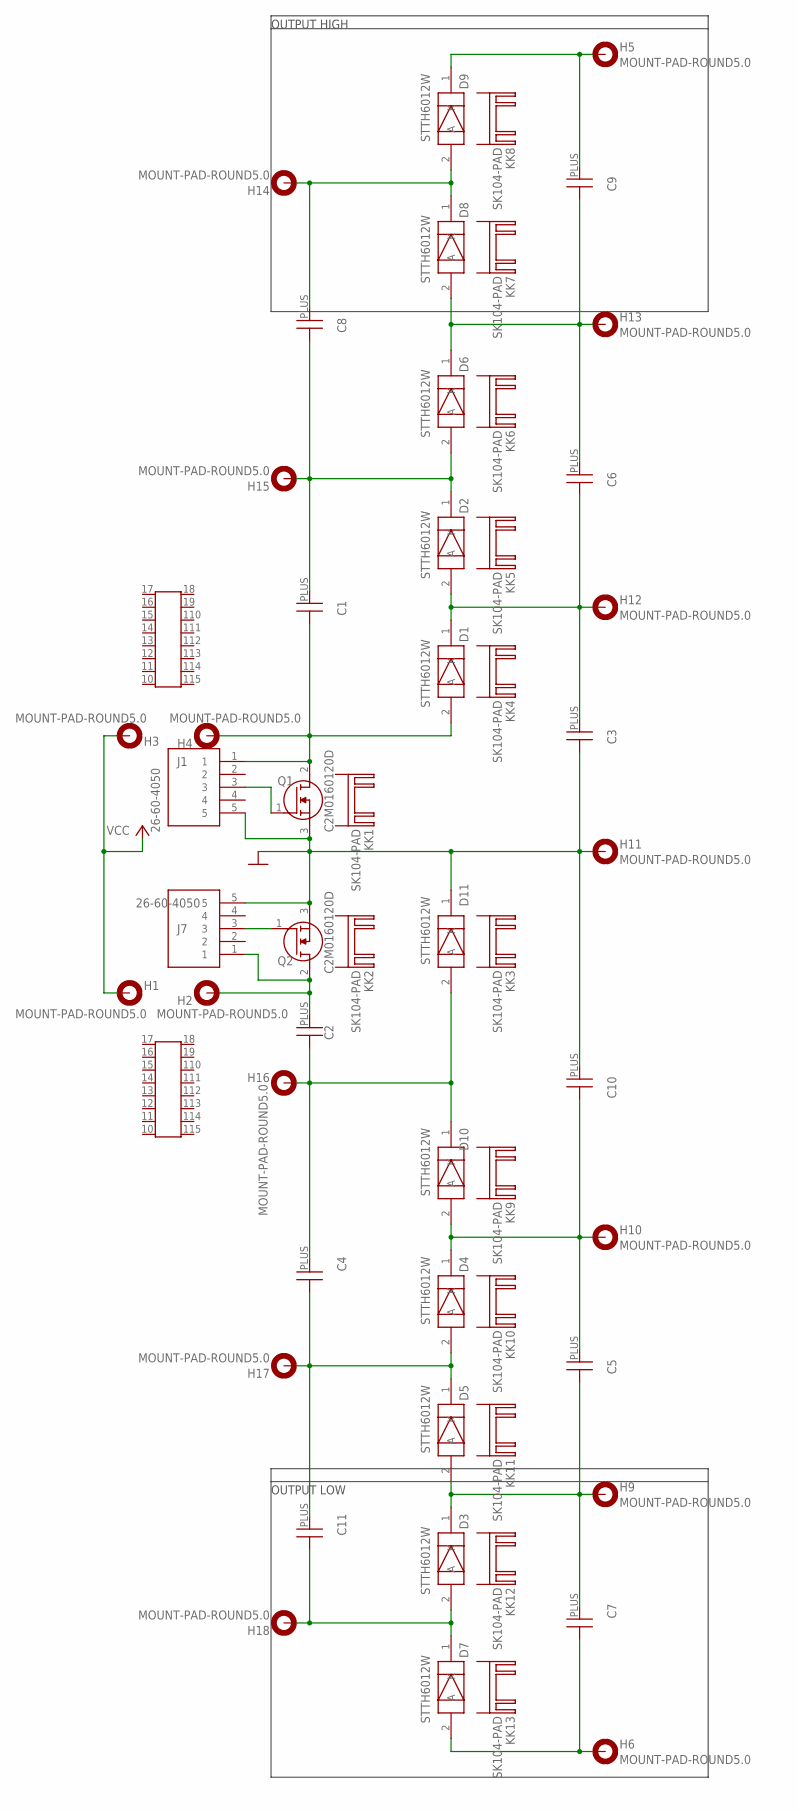
[picture p95: schematic 3level_2NX_interleaved_boost_converter.sch, sheet 1]

Parts:
C1, C2, C3, C4, C5, C6, C7, C8, C9, C10, C11: SANJEECAP; ECA2WHG2R2
D1, D2, D3, D4, D5, D6, D7, D8, D9, D10, D11: STTH6012W; TO1090P515X1560X2445-2P
H1, H2, H3, H4, H5, H6, H9, H10, H11, H12, H13, H14, H15, H16, H17, H18: MOUNT-PAD-ROUND5.0; 5,0-PAD
J1, J7: 26-60-4050; SHDR5W155P0X396_1X5_1966X1001X
KK1, KK2, KK3, KK4, KK5, KK6, KK7, KK8, KK9, KK10, KK11, KK12, KK13: SK104-PAD
Q1, Q2: C2M0160120D; TO544P521X1594X2550-3P
U$1, U$2: JELL; BOBBIN

Connections:
GND: C3.MINUS (1), C10.PLUS (2), D11.1 (K), H11.B5, J1.5, J7.5, Q1.3 (S), Q2.3 (S); also elsewhere on the board
unnamed: C1.PLUS (2), C8.MINUS (1), D2.1 (K), D6.2 (A), H15.B5
unnamed: C1.MINUS (1), D1.2 (A), H4.B5, J1.1, Q1.2 (D)
unnamed: C3.PLUS (2), C6.MINUS (1), D1.1 (K), D2.2 (A), H12.B5
unnamed: C8.PLUS (2), D8.1 (K), D9.2 (A), H14.B5
unnamed: C2.PLUS (2), H2.B5, J7.1, Q2.2 (D)
unnamed: C9.PLUS (2), D9.1 (K), H5.B5
unnamed: C11.MINUS (1), D3.2 (A), D7.1 (K), H18.B5
unnamed: C7.MINUS (1), D7.2 (A), H6.B5
unnamed: C2.MINUS (1), C4.PLUS (2), D10.1 (K), D11.2 (A), H16.B5
unnamed: C5.PLUS (2), C10.MINUS (1), D4.1 (K), D10.2 (A), H10.B5
unnamed: C6.PLUS (2), C9.MINUS (1), D6.1 (K), D8.2 (A), H13.B5
unnamed: J1.3, Q1.1 (G)
unnamed: J7.3, Q2.1 (G)
unnamed: C4.MINUS (1), C11.PLUS (2), D4.2 (A), D5.1 (K), H17.B5
unnamed: C5.MINUS (1), C7.PLUS (2), D3.1 (K), D5.2 (A), H9.B5
VCC: H1.B5, H3.B5; also elsewhere on the board

Notes on the sheet:
OUTPUT HIGH
OUTPUT LOW

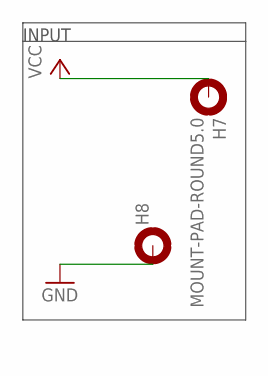
[picture p96: schematic 3level_2NX_interleaved_boost_converter.sch, sheet 2]

Parts:
H7, H8: MOUNT-PAD-ROUND5.0; 5,0-PAD

Connections:
GND: H8.B5; also elsewhere on the board
VCC: H7.B5; also elsewhere on the board

Notes on the sheet:
INPUT

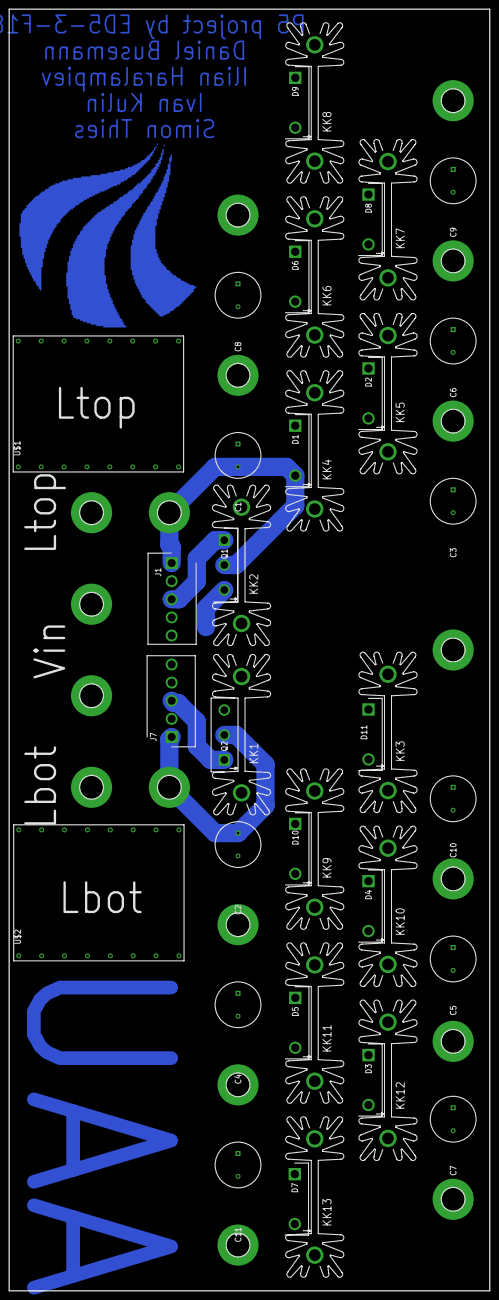
[picture p97: board 3level_2NX_interleaved_boost_converter.brd from above]

Board: 2 copper layers, 105.0 x 280.0 mm, 59 parts (0 on the bottom side), 17 nets.
