BlackAndWhiteSnaable/DC-DC/EAGLE/projects/New_Project_2/2NX_interleaved_boost_converter.brd

## EAGLE design EAGLE/projects/New_Project_2/2NX_interleaved_boost_converter.brd (2018-11-21)

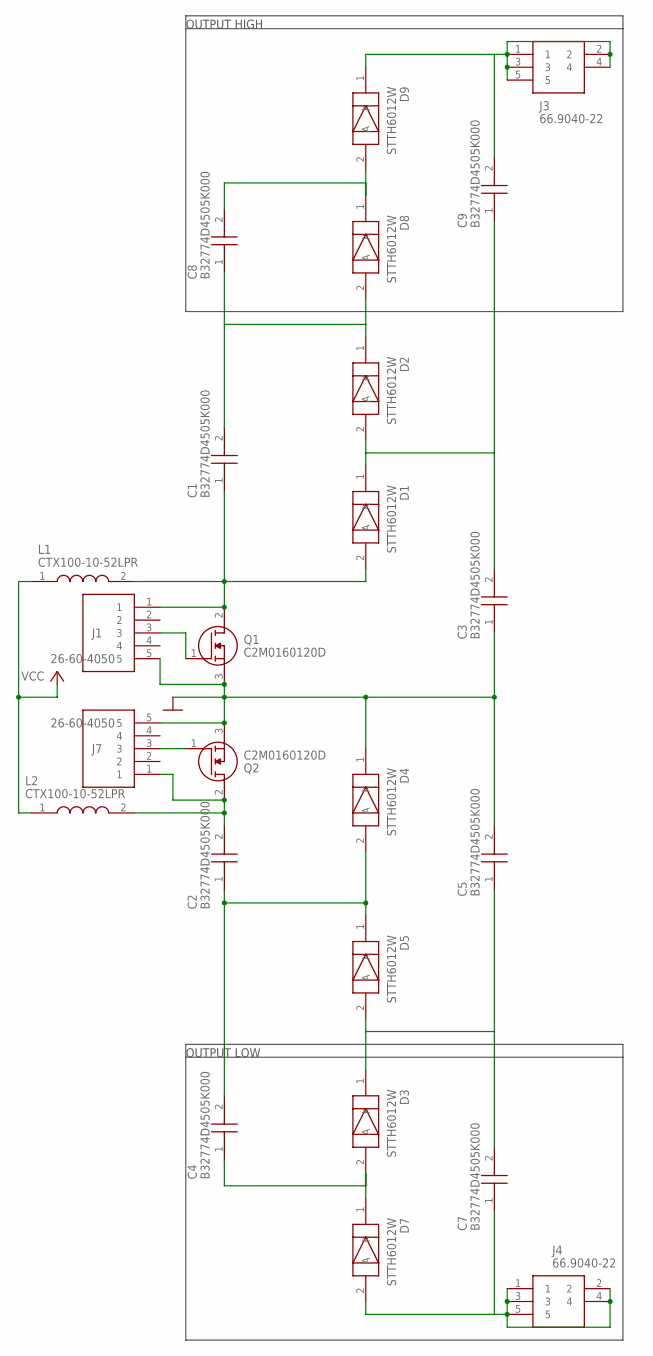
[picture p98: schematic 2NX_interleaved_boost_converter.sch, sheet 1]

Parts:
C1, C2, C3, C4, C5, C7, C8, C9: B32774D4505K000
D1, D2, D3, D4, D5, D7, D8, D9: STTH6012W; TO1090P515X1560X2445-2P
J1, J7: 26-60-4050; SHDR5W155P0X396_1X5_1966X1001X
J3, J4: 66.9040-22; 66904022
L1, L2: CTX100-10-52LPR; CTX1001052LPR
Q1, Q2: C2M0160120D; TO544P521X1594X2550-3P

Connections:
GND: C3.1, C5.2, D4.1 (K), J1.5, J7.5, Q1.3 (S), Q2.3 (S); also elsewhere on the board
unnamed: C1.2, C8.1, D2.1 (K), D8.2 (A)
unnamed: C1.1, D1.2 (A), J1.1, L1.2, Q1.2 (D)
unnamed: C3.2, C9.1, D1.1 (K), D2.2 (A)
unnamed: C8.2, D8.1 (K), D9.2 (A)
unnamed: C2.2, J7.1, L2.2, Q2.2 (D)
unnamed: C9.2, D9.1 (K), J3.1, J3.2, J3.3, J3.4, J3.5
unnamed: C4.1, D3.2 (A), D7.1 (K)
unnamed: C2.1, C4.2, D4.2 (A), D5.1 (K)
unnamed: C5.1, C7.2, D3.1 (K), D5.2 (A)
unnamed: C7.1, D7.2 (A), J4.1, J4.2, J4.3, J4.4, J4.5
unnamed: J1.3, Q1.1 (G)
unnamed: J7.3, Q2.1 (G)
VCC: L1.1, L2.1; also elsewhere on the board

Notes on the sheet:
OUTPUT HIGH
OUTPUT LOW

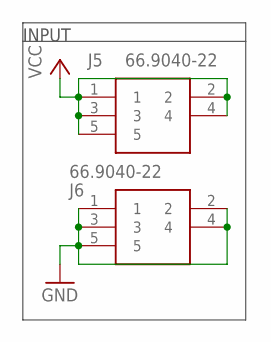
[picture p99: schematic 2NX_interleaved_boost_converter.sch, sheet 2]

Parts:
J5, J6: 66.9040-22; 66904022

Connections:
GND: J6.1, J6.2, J6.3, J6.4, J6.5; also elsewhere on the board
VCC: J5.1, J5.2, J5.3, J5.4, J5.5; also elsewhere on the board

Notes on the sheet:
INPUT

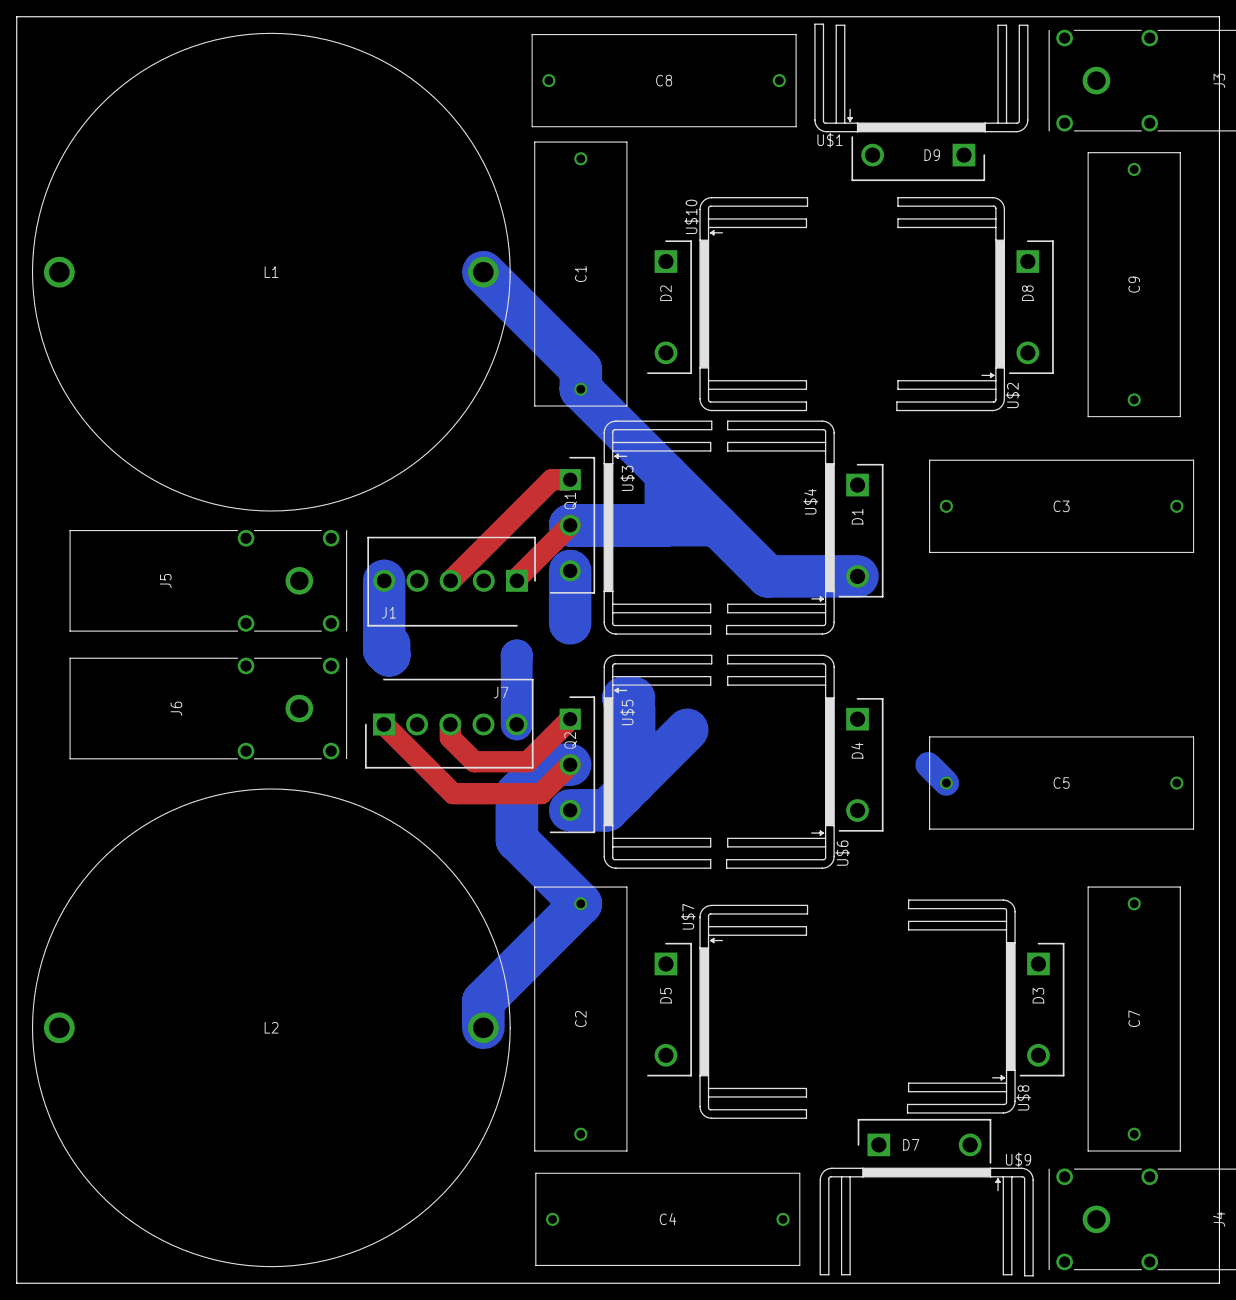
[picture p100: board 2NX_interleaved_boost_converter.brd from above]

Board: 2 copper layers, 143.5 x 151.1 mm, 36 parts (0 on the bottom side), 14 nets.

Other parts of the board:
U$1, U$2, U$3, U$4, U$5, U$6, U$7, U$8, U$9, U$10: FK213
