BlackAndWhiteSnaable/DC-DC/EAGLE/projects/New_Project_2/b_SI_Boost.brd

## EAGLE design EAGLE/projects/New_Project_2/b_SI_Boost.brd (2018-11-14)

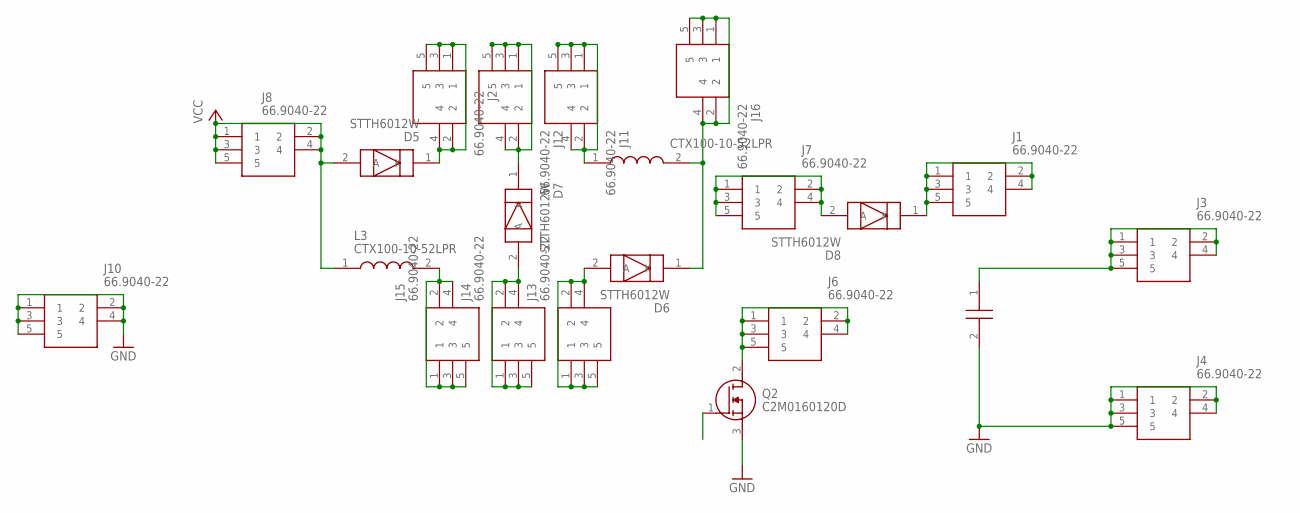
[picture p101: schematic b_SI_Boost.sch]

Parts:
D5, D6, D7, D8: STTH6012W; TO1090P515X1560X2445-2P
J1, J2, J3, J4, J6, J7, J8, J10, J11, J12, J13, J14, J15, J16: 66.9040-22; 66904022
L3, L4: CTX100-10-52LPR; CTX1001052LPR
Q2: C2M0160120D; TO544P521X1594X2550-3P
U$1: B32774D4505K000

Connections:
GND: J4.1, J4.2, J4.3, J4.4, J4.5, J10.1, J10.2, J10.3, J10.4, J10.5, Q2.3 (S), U$1.2
unnamed: J15.1, J15.2, J15.3, J15.4, J15.5, L3.2
unnamed: D7.2 (A), J14.1, J14.2, J14.3, J14.4, J14.5
unnamed: D6.1 (K), J16.1, J16.2, J16.3, J16.4, J16.5, L4.2
unnamed: D8.1 (K), J1.1, J1.2, J1.3, J1.4, J1.5
unnamed: J3.1, J3.2, J3.3, J3.4, J3.5, U$1.1
unnamed: J6.1, J6.2, J6.3, J6.4, J6.5, Q2.2 (D)
unnamed: D8.2 (A), J7.1, J7.2, J7.3, J7.4, J7.5
unnamed: D6.2 (A), J13.1, J13.2, J13.3, J13.4, J13.5
unnamed: D7.1 (K), J12.1, J12.2, J12.3, J12.4, J12.5
unnamed: D5.1 (K), J2.1, J2.2, J2.3, J2.4, J2.5
unnamed: J11.1, J11.2, J11.3, J11.4, J11.5, L4.1
VCC: D5.2 (A), J8.1, J8.2, J8.3, J8.4, J8.5, L3.1

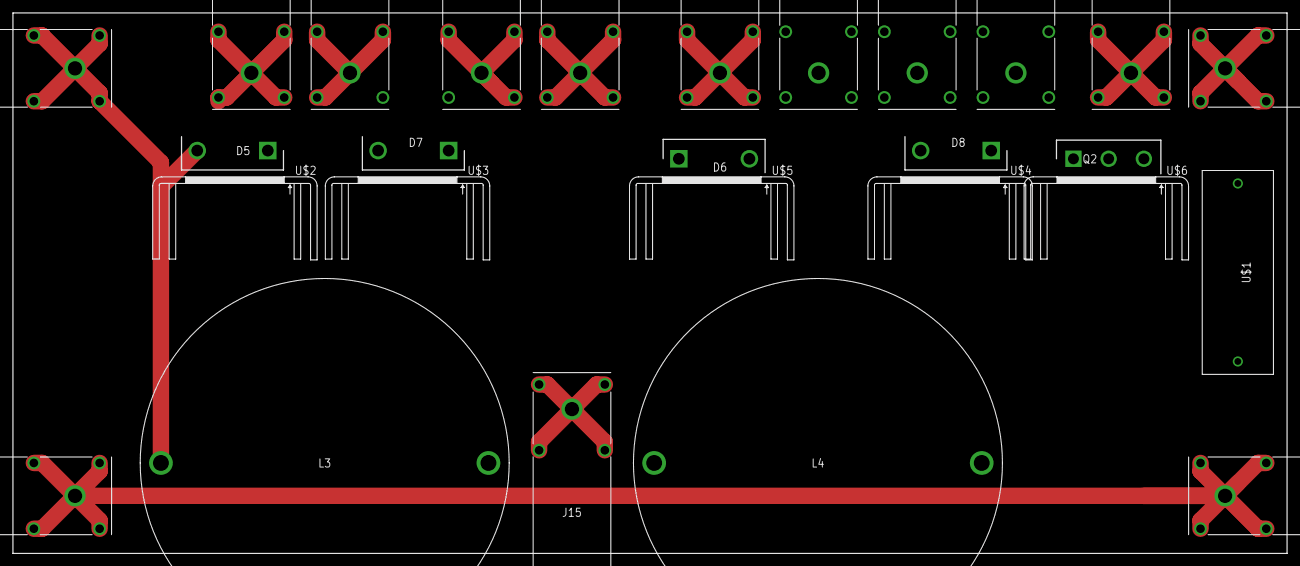
[picture p102: board b_SI_Boost.brd from above]

Board: 2 copper layers, 196.8 x 83.5 mm, 27 parts (0 on the bottom side), 13 nets.

Other parts of the board:
U$2, U$3, U$4, U$5, U$6: FK213
