BlackAndWhiteSnaable/DC-DC/EAGLE/projects/New_Project_2/a_Conventional_Boost.brd

## EAGLE design EAGLE/projects/New_Project_2/a_Conventional_Boost.brd (2018-10-29)

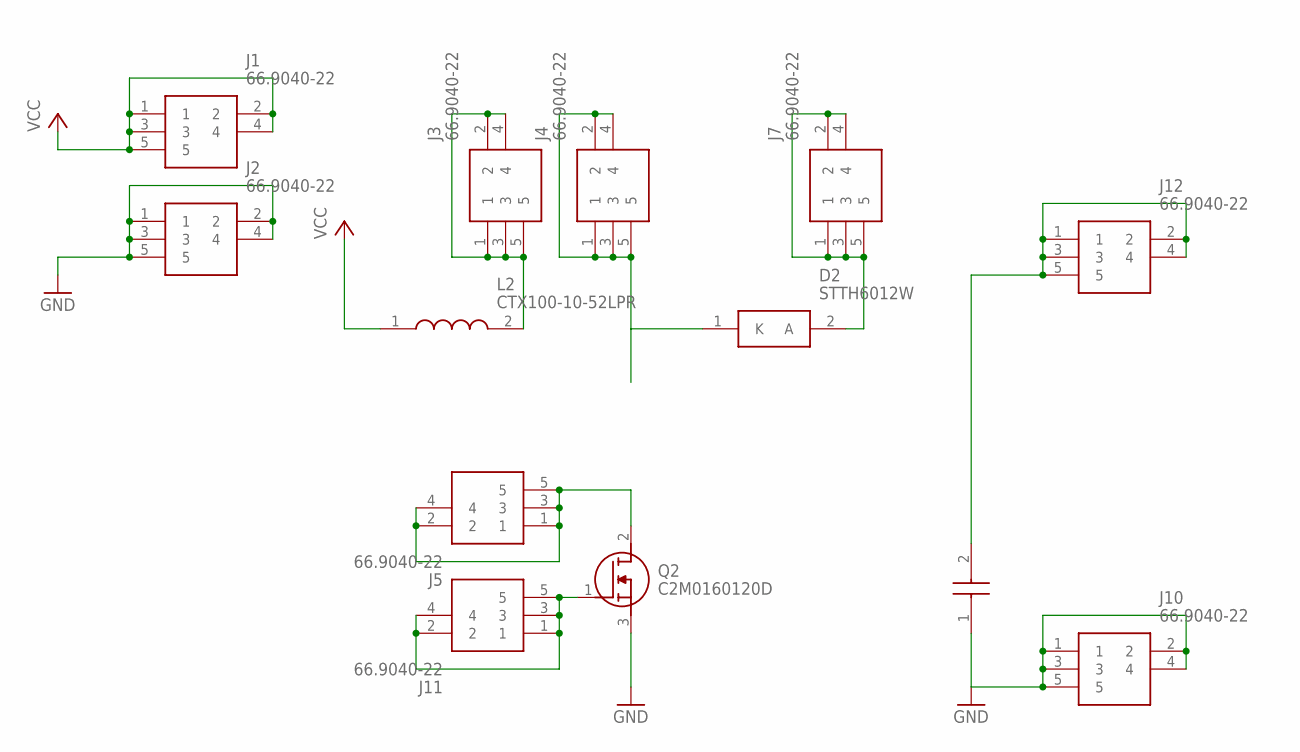
[picture p103: schematic a_Conventional_Boost.sch]

Parts:
D2: STTH6012W; TO1090P515X1560X2445-2P
J1, J2, J3, J4, J5, J7, J10, J11, J12: 66.9040-22; 66904022
L2: CTX100-10-52LPR; CTX1001052LPR
Q2: C2M0160120D; TO544P521X1594X2550-3P
U$1: B32774D4505K000

Connections:
GND: J2.1, J2.2, J2.3, J2.4, J2.5, J10.1, J10.2, J10.3, J10.4, J10.5, Q2.3 (S), U$1.1
GND1: J11.1, J11.2, J11.3, J11.4, J11.5, Q2.1 (G)
unnamed: D2.1 (K), J4.1, J4.2, J4.3, J4.4, J4.5
VCC: J1.1, J1.2, J1.3, J1.4, J1.5, L2.1
VCC1: J3.1, J3.2, J3.3, J3.4, J3.5, L2.2
VCC2: J5.1, J5.2, J5.3, J5.4, J5.5, Q2.2 (D)
VCC3: D2.2 (A), J7.1, J7.2, J7.3, J7.4, J7.5
VCC4: J12.1, J12.2, J12.3, J12.4, J12.5, U$1.2

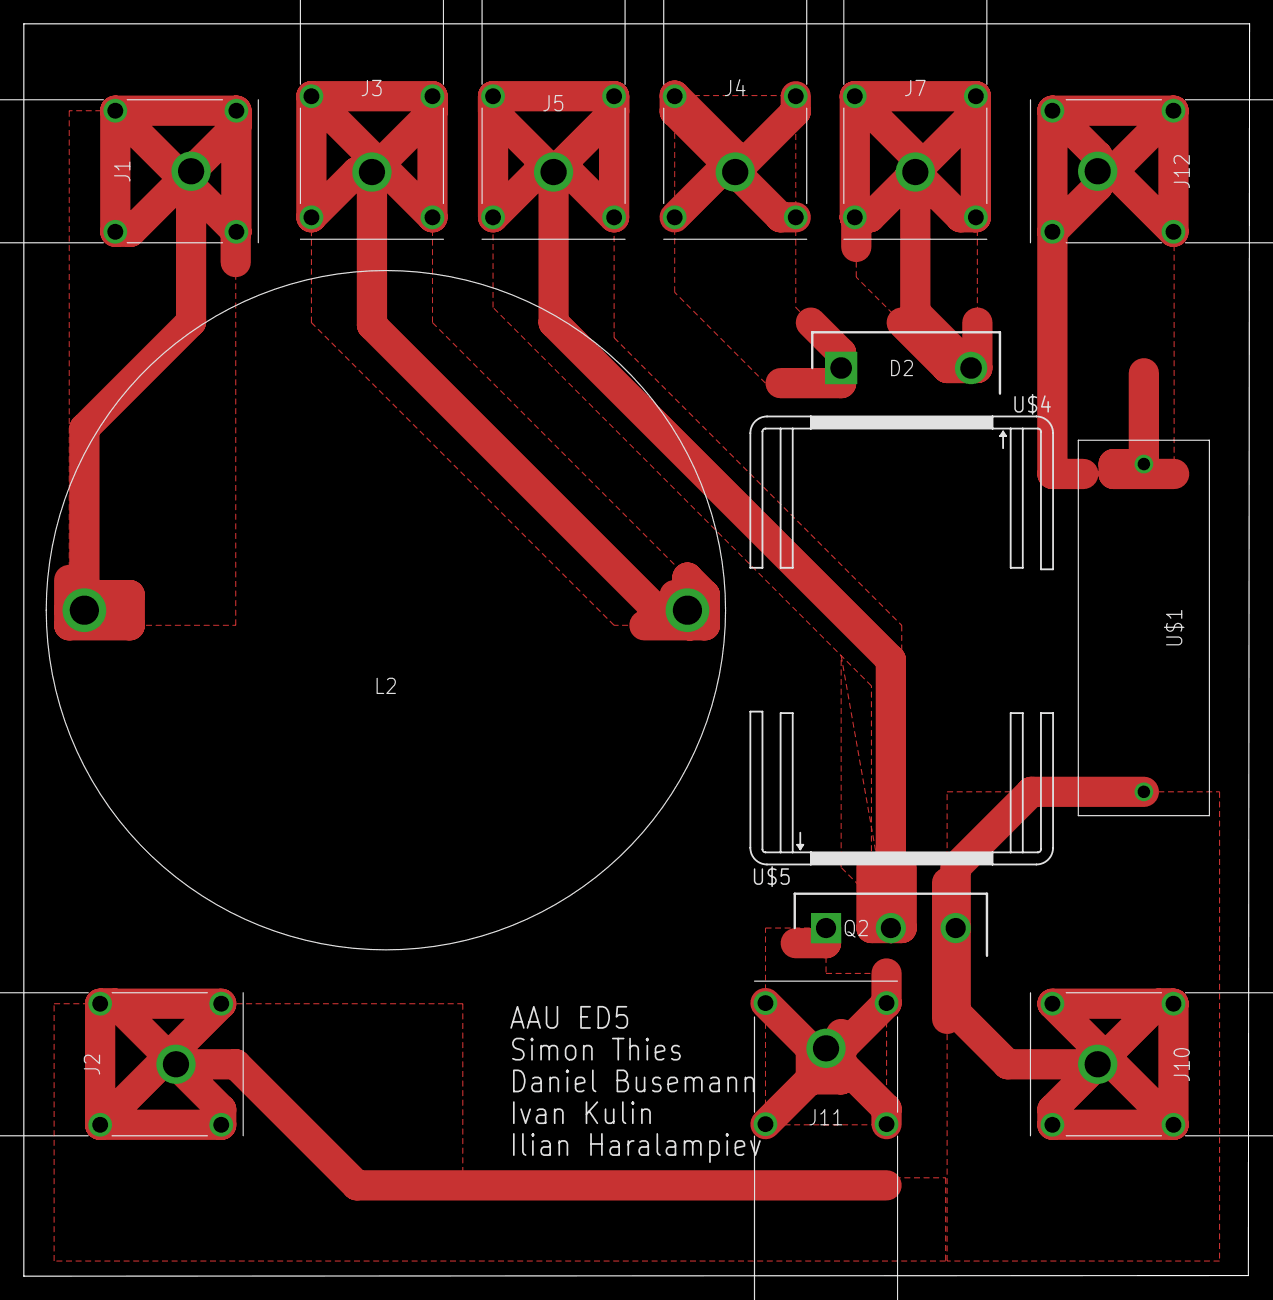
[picture p104: board a_Conventional_Boost.brd from above]

Board: 2 copper layers, 102.8 x 105.1 mm, 15 parts (0 on the bottom side), 8 nets.

Other parts of the board:
U$4, U$5: FK213
