BlackAndWhiteSnaable/DC-DC/EAGLE/projects/New_Project_2/c_Single_Switch_QBC.brd

## EAGLE design EAGLE/projects/New_Project_2/c_Single_Switch_QBC.brd (2018-10-29)

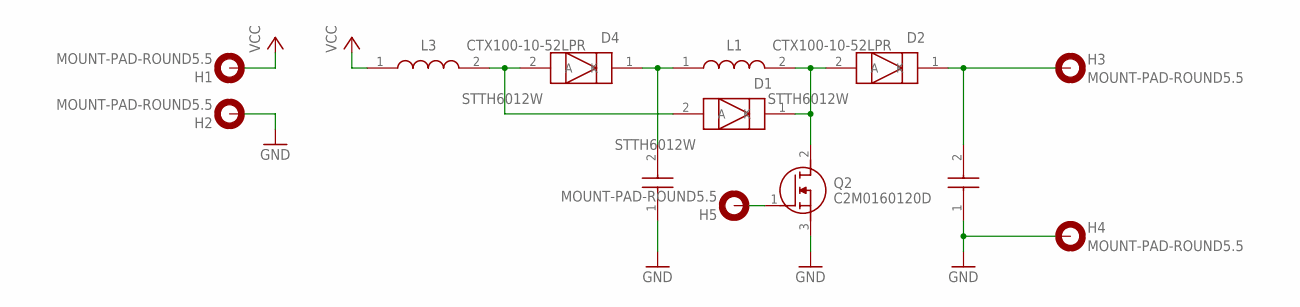
[picture p105: schematic c_Single_Switch_QBC.sch]

Parts:
D1, D2, D4: STTH6012W; TO1090P515X1560X2445-2P
H1, H2, H3, H4, H5: MOUNT-PAD-ROUND5.5; 5,5-PAD
L1, L3: CTX100-10-52LPR; CTX1001052LPR
Q2: C2M0160120D; TO544P521X1594X2550-3P
U$1, U$2: B32774D4505K000

Connections:
GND: H2.B5,5, H4.B5,5, Q2.3 (S), U$1.1, U$2.1
unnamed: D1.2 (A), D4.2 (A), L3.2
unnamed: D2.1 (K), H3.B5,5, U$2.2
unnamed: D1.1 (K), D2.2 (A), L1.2, Q2.2 (D)
unnamed: H5.B5,5, Q2.1 (G)
unnamed: D4.1 (K), L1.1, U$1.2
VCC: H1.B5,5, L3.1

Board: 2 copper layers, 13 parts (0 on the bottom side), 7 nets, no tracks yet.
