BlackAndWhiteSnaable/DC-DC/EAGLE/projects/New_Project_2/g_Switched_Cap_BC.brd

## EAGLE design EAGLE/projects/New_Project_2/g_Switched_Cap_BC.brd (2018-10-29)

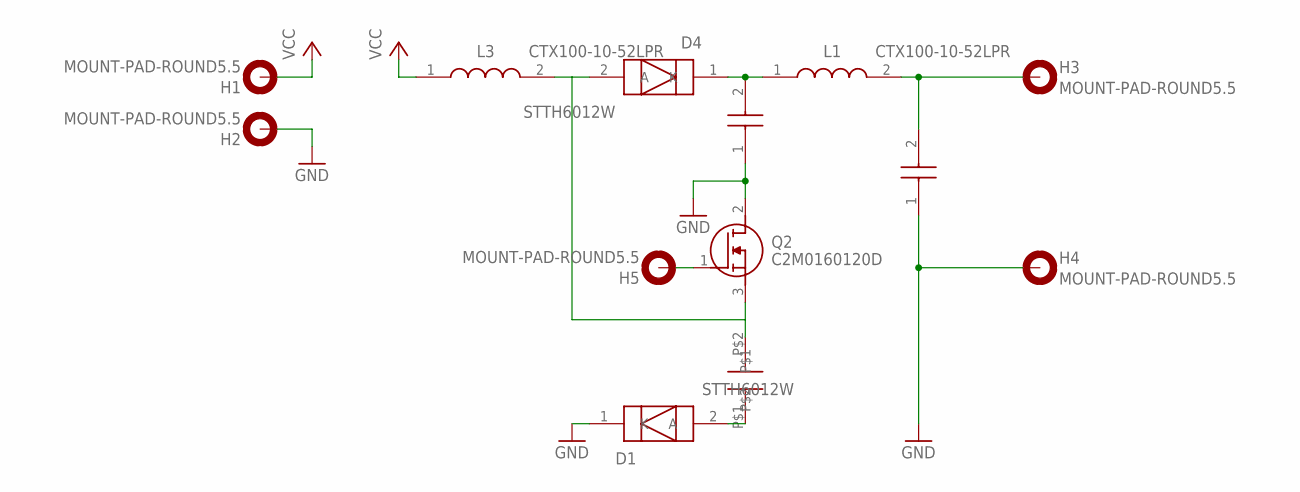
[picture p106: schematic g_Switched_Cap_BC.sch]

Parts:
C1, C3: B32774D4505K000
C2: PH_B32774D4505K000PLACEHOLDER; TJ4-U1
D1, D4: STTH6012W; TO1090P515X1560X2445-2P
H1, H2, H3, H4, H5: MOUNT-PAD-ROUND5.5; 5,5-PAD
L1, L3: CTX100-10-52LPR; CTX1001052LPR
Q2: C2M0160120D; TO544P521X1594X2550-3P

Connections:
GND: C1.1, C3.1, D1.1 (K), H2.B5,5, H4.B5,5, Q2.2 (D)
unnamed: C2.P$2, D4.2 (A), L3.2, Q2.3 (S)
unnamed: C2.P$1, D1.2 (A)
unnamed: H5.B5,5, Q2.1 (G)
unnamed: C3.2, H3.B5,5, L1.2
unnamed: C1.2, D4.1 (K), L1.1
VCC: H1.B5,5, L3.1

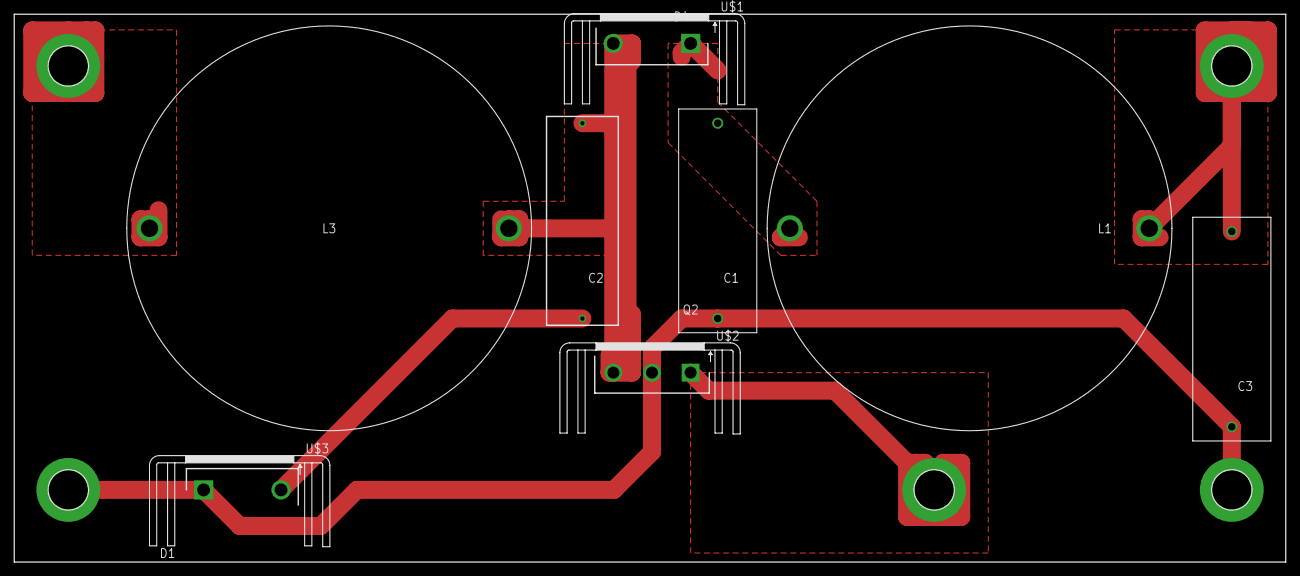
[picture p107: board g_Switched_Cap_BC.brd from above]

Board: 2 copper layers, 179.1 x 77.1 mm, 16 parts (0 on the bottom side), 7 nets.

Other parts of the board:
U$1, U$2, U$3: FK213
