BlackAndWhiteSnaable/DC-DC/EAGLE/projects/New_Project_2/d_Conventional_3_Level_BC.brd

## EAGLE design EAGLE/projects/New_Project_2/d_Conventional_3_Level_BC.brd (2018-10-29)

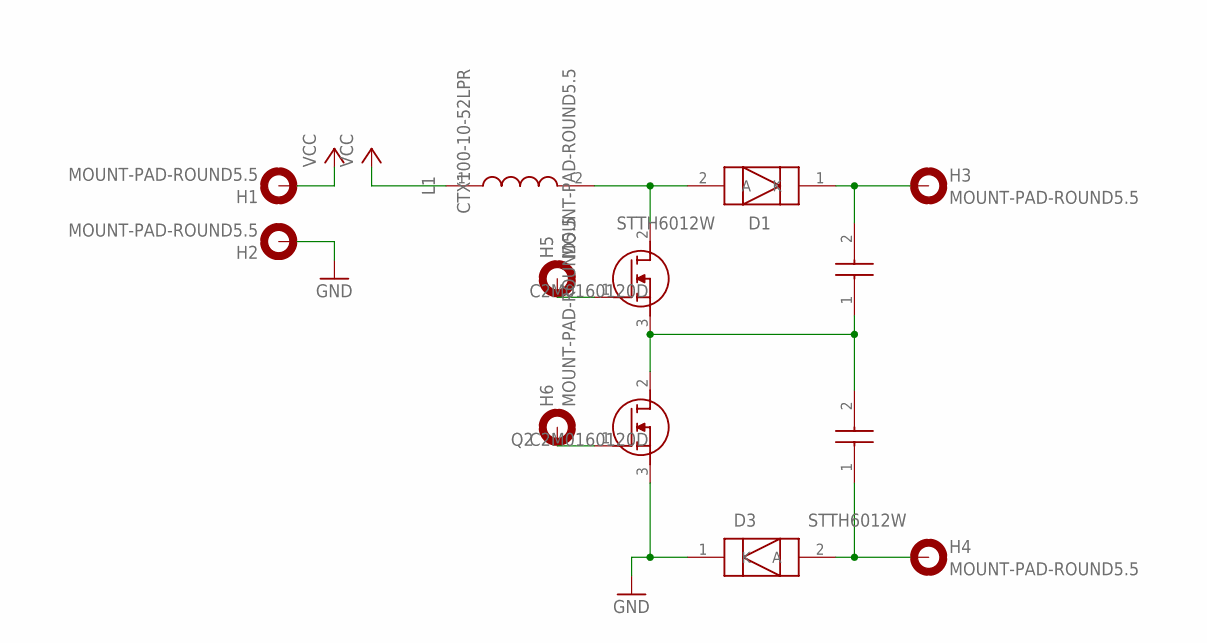
[picture p108: schematic d_Conventional_3_Level_BC.sch]

Parts:
D1, D3: STTH6012W; TO1090P515X1560X2445-2P
H1, H2, H3, H4, H5, H6: MOUNT-PAD-ROUND5.5; 5,5-PAD
L1: CTX100-10-52LPR; CTX1001052LPR
Q1, Q2: C2M0160120D; TO544P521X1594X2550-3P
U$3, U$4: B32774D4505K000

Connections:
GND: D3.1 (K), H2.B5,5, Q2.3 (S)
unnamed: Q1.3 (S), Q2.2 (D), U$3.1, U$4.2
unnamed: H5.B5,5, Q1.1 (G)
unnamed: D1.2 (A), L1.2, Q1.2 (D)
unnamed: D1.1 (K), H3.B5,5, U$3.2
unnamed: H6.B5,5, Q2.1 (G)
unnamed: D3.2 (A), H4.B5,5, U$4.1
VCC: H1.B5,5, L1.1

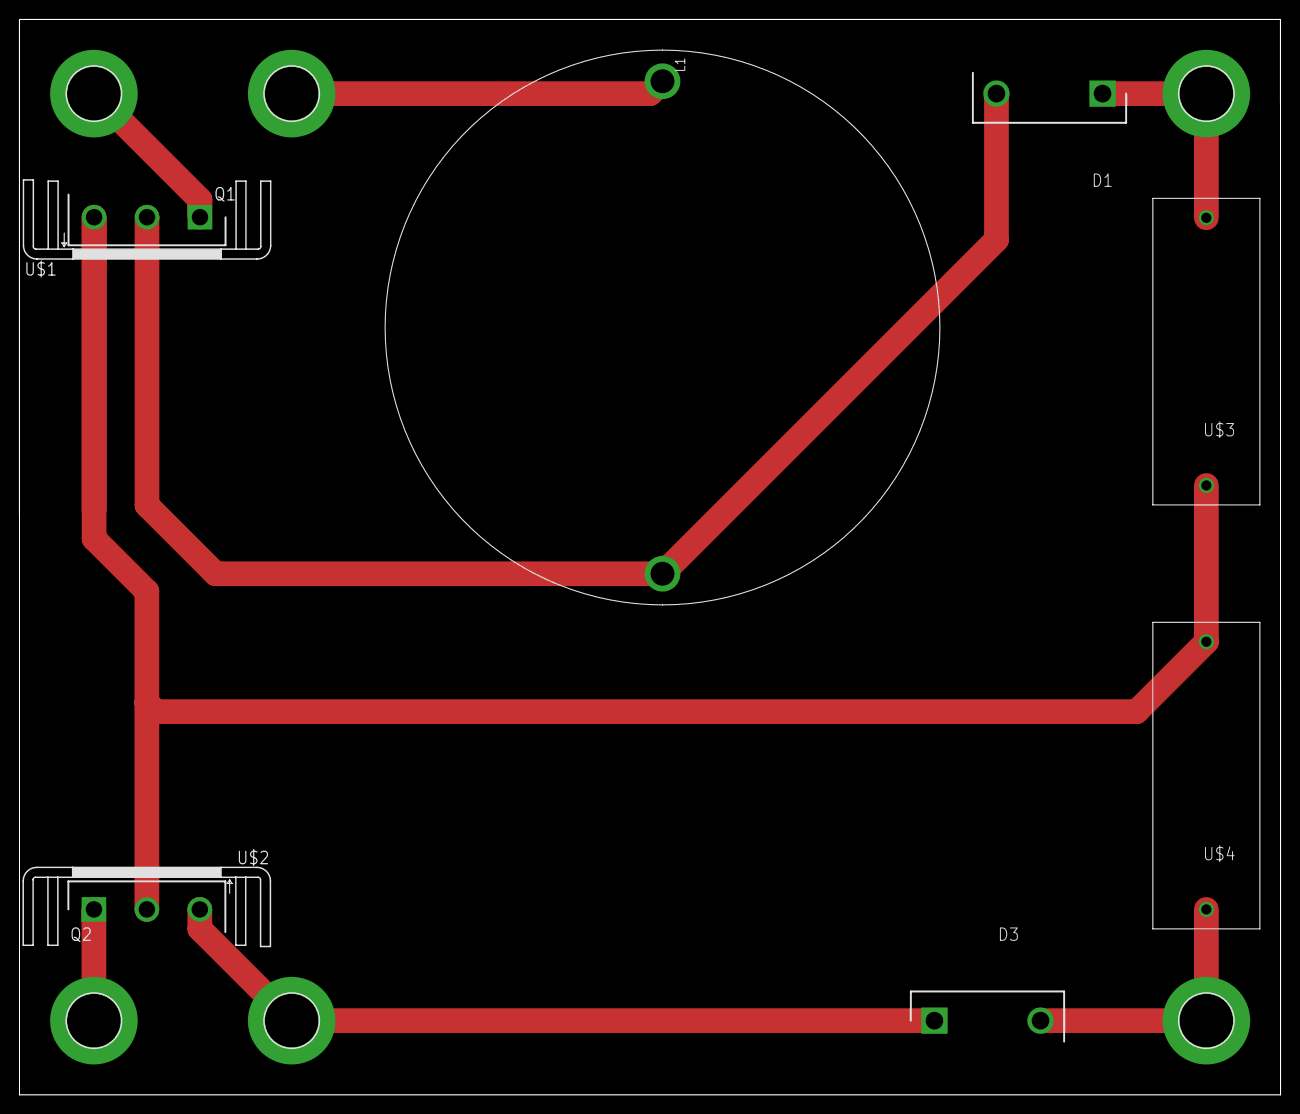
[picture p109: board d_Conventional_3_Level_BC.brd from above]

Board: 2 copper layers, 129.6 x 110.5 mm, 15 parts (0 on the bottom side), 8 nets.

Other parts of the board:
U$1, U$2: FK209
