BlackAndWhiteSnaable/DC-DC/DipTrace/dip2eagle/2nx_interleaved_dip2eagle_ERROR.brd

## EAGLE design DipTrace/dip2eagle/2nx_interleaved_dip2eagle_ERROR.brd (2018-11-22)

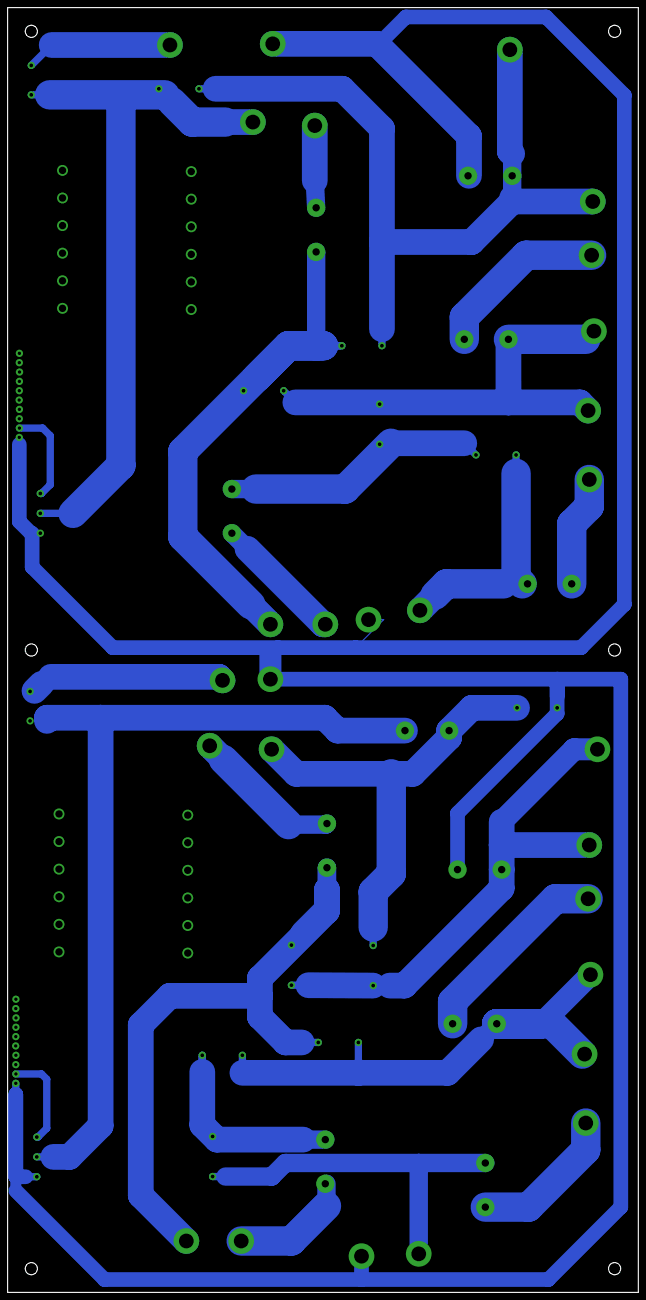
[picture p110: board 2nx_interleaved_dip2eagle_ERROR.brd from above]

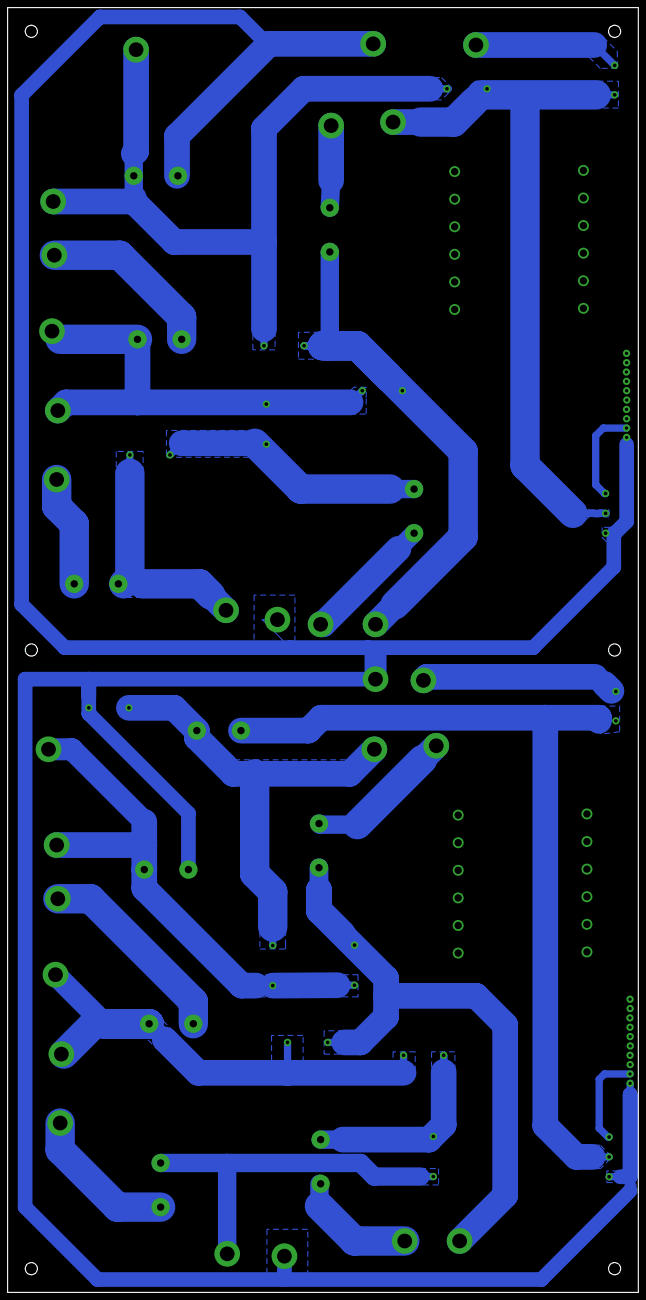
[picture p111: board 2nx_interleaved_dip2eagle_ERROR.brd from below]

Board: 2 copper layers, 171.4 x 349.2 mm, 120 parts (94 on the bottom side), 26 nets.

Parts:
PAD1, PAD2, PAD3, PAD4, PAD5, PAD6, PAD7, PAD8, PAD9, PAD10, PAD11, PAD12, PAD13, PAD14, PAD15, PAD16, PAD17, PAD18, PAD19, PAD20, PAD21, PAD22: PAD1
Pad1, Pad24, Pad25, Pad26, Pad27, Pad28, Pad30, Pad31, Pad32, Pad33, Pad34, Pad35, Pad36, Pad45, Pad47, Pad48, Pad71, Pad72, Pad73, Pad74, Pad75, Pad76, Pad77, Pad78, Pad79, Pad80, Pad81, Pad82: Pad
Pad2, Pad3, Pad4, Pad5, Pad6, Pad7, Pad8, Pad9, Pad10, Pad11, Pad12, Pad13, Pad49, Pad50, Pad51, Pad52, Pad53, Pad54, Pad55, Pad56, Pad57, Pad58, Pad59, Pad60: Pad_Pad2
Pad14, Pad15, Pad16, Pad17, Pad18, Pad19, Pad20, Pad21, Pad22, Pad23, Pad61, Pad62, Pad63, Pad64, Pad65, Pad66, Pad67, Pad68, Pad69, Pad70, Pad93, Pad94: Pad_Pad14
Pad29, Pad37, Pad38, Pad39, Pad40, Pad41, Pad42, Pad43, Pad44, Pad46, Pad83, Pad84, Pad85, Pad86, Pad87, Pad88, Pad89, Pad90, Pad91, Pad92: Pad_Pad29
U1: P116
U2: P117
U3: P118
U4: P119

Connections:
Net_0: PAD4.1, Pad45.1
Net_1: PAD3.1, Pad36.1, U1.1, U3.1_1
Net_2: PAD2.1, PAD9.1, Pad14.1, Pad32.1
Net_3: PAD1.1, Pad22.1, Pad24.1, Pad25.1, U3.1
Net_4: PAD21.1, Pad1.1, Pad23.1, Pad27.1, Pad29.1, Pad48.1, Pad70.1, Pad82.1, Pad91.1, U1.1_1, U2.1_1
Net_5: PAD5.1, PAD10.1, Pad20.1, Pad28.1, Pad30.1
Net_6: Pad62.1, Pad81.1
Net_7: PAD8.1, Pad18.1, Pad34.1
Net_8: Pad17.1, Pad33.1
Net_9: Pad21.1, Pad26.1
Net_10: Pad19.1, Pad31.1
Net_11: Pad15.1, Pad35.1
Net_12: Pad46.1, U1.1_1
Net_13: PAD16.1, Pad47.1
Net_14: PAD13.1, Pad94.1, U2.1
Net_15: PAD15.1, PAD19.1, Pad61.1, Pad77.1
Net_16: PAD14.1, Pad69.1, Pad71.1, Pad72.1, U4.1
Net_17: PAD6.1, PAD7.1, Pad16.1
Net_18: PAD11.1, PAD20.1, Pad67.1, Pad74.1, Pad75.1
Net_19: PAD12.1, PAD17.1, Pad63.1
Net_20: PAD18.1, Pad65.1, Pad79.1
Net_21: Pad64.1, Pad78.1
Net_22: Pad68.1, Pad73.1
Net_23: Pad66.1, Pad76.1
Net_24: PAD22.1, Pad80.1, Pad93.1, U4.1_1
Net_25: Pad92.1, U2.1_1
