BlackAndWhiteSnaable/DC-DC/DipTrace/dip2eagle/2nx_interleaved_DANIEL_EDIT_dip2eagle.brd

## EAGLE design DipTrace/dip2eagle/2nx_interleaved_DANIEL_EDIT_dip2eagle.brd (2018-11-22)

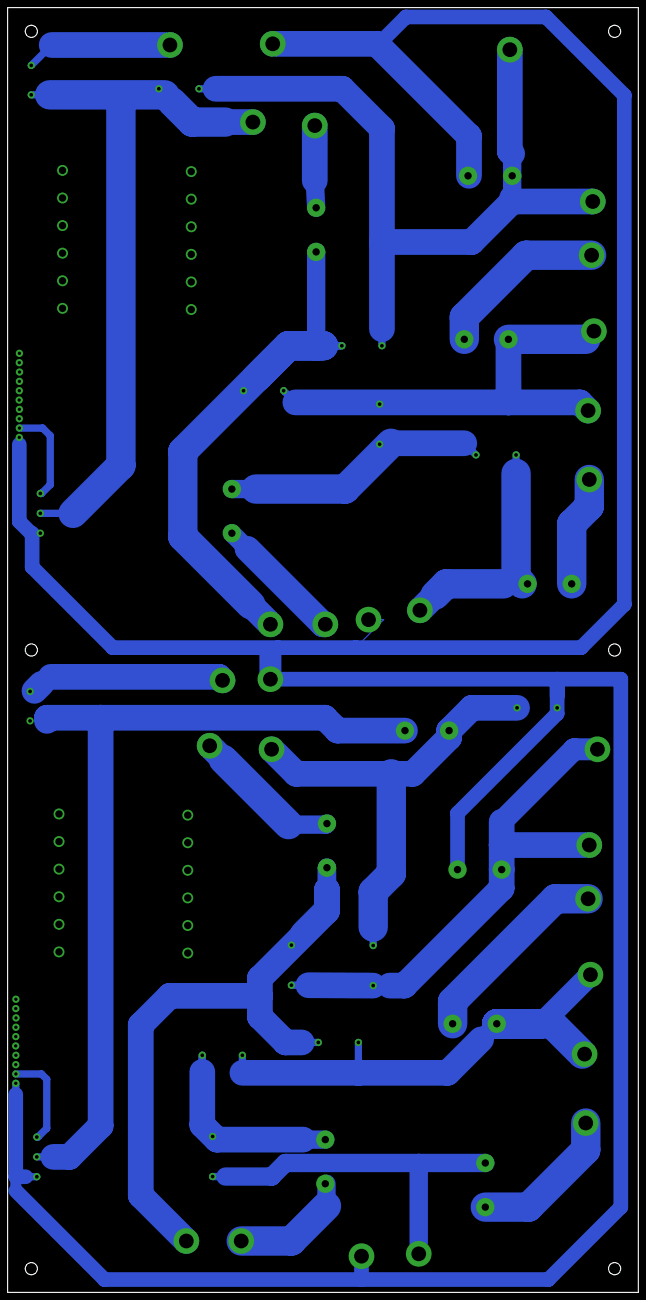
[picture p112: board 2nx_interleaved_DANIEL_EDIT_dip2eagle.brd from above]

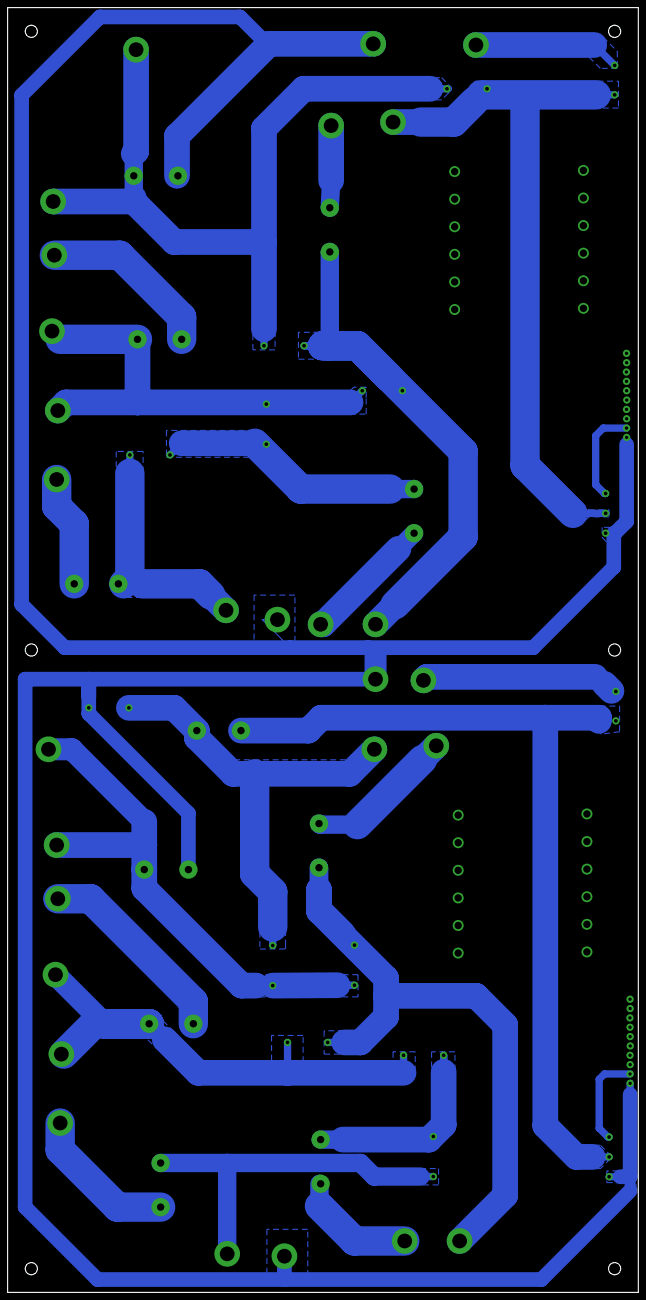
[picture p113: board 2nx_interleaved_DANIEL_EDIT_dip2eagle.brd from below]

Board: 2 copper layers, 171.4 x 349.2 mm, 120 parts (94 on the bottom side), 18 nets.

Parts:
PAD1, PAD46, PAD47, PAD48, PAD49, PAD50, PAD52, PAD53, PAD54, PAD55, PAD56, PAD57, PAD58, PAD67, PAD69, PAD70, PAD93, PAD94, PAD95, PAD96, PAD97, PAD98, PAD99, PAD100, PAD101, PAD102, PAD103, PAD104: PAD
PAD2, PAD3, PAD5, PAD7, PAD9, PAD11, PAD13, PAD15, PAD18, PAD20, PAD22, PAD24, PAD26, PAD28, PAD30, PAD32, PAD34, PAD36, PAD38, PAD40, PAD42, PAD44: PAD1
PAD4, PAD6, PAD8, PAD10, PAD12, PAD14, PAD16, PAD17, PAD19, PAD21, PAD23, PAD25, PAD71, PAD72, PAD73, PAD74, PAD75, PAD76, PAD77, PAD78, PAD79, PAD80, PAD81, PAD82: PAD_PAD2
PAD27, PAD29, PAD31, PAD33, PAD35, PAD37, PAD39, PAD41, PAD43, PAD45, PAD83, PAD84, PAD85, PAD86, PAD87, PAD88, PAD89, PAD90, PAD91, PAD92, PAD115, PAD116: PAD_PAD14
PAD51, PAD59, PAD60, PAD61, PAD62, PAD63, PAD64, PAD65, PAD66, PAD68, PAD105, PAD106, PAD107, PAD108, PAD109, PAD110, PAD111, PAD112, PAD113, PAD114: PAD_PAD29
U1: P116
U2: P117
U3: P118
U4: P119

Connections:
NET_2: PAD2.1, PAD9.1, PAD14.1, PAD32.1
NET_3: PAD1.1, PAD22.1, PAD24.1, PAD25.1, U3.1
NET_5: PAD3.1, PAD5.1, PAD10.1, PAD20.1, PAD28.1, PAD30.1, PAD36.1, U1.1, U3.1_1
NET_6: PAD62.1, PAD81.1
NET_8: PAD17.1, PAD33.1
NET_9: PAD4.1, PAD6.1, PAD7.1, PAD13.1, PAD16.1, PAD21.1, PAD26.1, PAD45.1, PAD94.1, U2.1
NET_10: PAD19.1, PAD31.1
NET_11: PAD15.1, PAD35.1
NET_12: PAD1.1, PAD21.1, PAD23.1, PAD27.1, PAD29.1, PAD46.1, PAD48.1, PAD70.1, PAD82.1, PAD91.1, U1.1_1, U2.1_1
NET_13: PAD16.1, PAD47.1
NET_15: PAD8.1, PAD12.1, PAD15.1, PAD17.1, PAD18.1, PAD19.1, PAD34.1, PAD61.1, PAD63.1, PAD77.1
NET_16: PAD14.1, PAD69.1, PAD71.1, PAD72.1, U4.1
NET_20: PAD18.1, PAD65.1, PAD79.1
NET_21: PAD64.1, PAD78.1
NET_22: PAD68.1, PAD73.1
NET_23: PAD66.1, PAD76.1
NET_24: PAD11.1, PAD20.1, PAD22.1, PAD67.1, PAD74.1, PAD75.1, PAD80.1, PAD93.1, U4.1_1
NET_25: PAD92.1, U2.1_1
