BlackAndWhiteSnaable/DC-DC/(commit log)

2018-09-14 Lab data2
    Lab measurements 14-09-18
    [T0000ALL.CSV, T0001ALL.CSV]
2018-09-14 CSV implement
    Signal builder should work in Bipolar
    [RPM700D.csv]
2018-09-17 THD Recordings
    Modified to measure THD recorded in Excel sheet
    [THD_data.xlsx]
2018-09-17 fixing some stash problems
    [THD_data.xlsx]
2018-09-20 Revert "fixing some stash problems"
    This reverts commit 84b439a03699b2e083e6432a73d16e161206bf07.
    [THD_data.xlsx]
2018-09-24 simple buck converter
2018-09-25 Buck converter in LTSpice
    Same values used as in Matlab
2018-10-03 Buck sim MATLAB
    [1400.CSV, 700.CSV, Book3.xlsx]
2018-10-05 Buck converter in LTSpice fixed
    Same fixed
2018-10-29 migrated the eagle
    [a_Conventional_Boost.brd, a_Conventional_Boost.sch, b_SI_Boost.brd, b_SI_Boost.sch, c_Single_Switch_QBC.brd, c_Single_Switch_QBC.sch, d_Conventional_3_Level_BC.brd, d_Conventional_3_Level_BC.sch]
2018-10-29 Downloaded some AAU logos
    so we can put them on the PCB
2018-10-30 Schematic and Board for interleaved Boost done
    should maybe be checked for clearances between traces, standard eagle check was not running into any difficulties (but could have lower clearances for lower voltages)
    [2NX_interleaved_boost_converter.brd, 2NX_interleaved_boost_converter.sch]
2018-10-31 PWM Generation
2018-11-13 Playing with voltage drops again
2018-11-13 some corrections in eagle
    [2NX_interleaved_boost_converter.brd, 2NX_interleaved_boost_converter.sch, b_SI_Boost.brd, b_SI_Boost.sch]
2018-11-15 More of the same, component tolerances, voltage drops etc.
2018-11-15 2x3 Level with mosfet
2018-11-19 DipTrace
    the board exported to eagle
    all marked screenshots used to ask Sagar questions
    [2nx_interleaved_dip2eagle.brd]
2018-11-19 DipTrace
    the original board layout from Sagar
    Daniels edit
    the board import from Eagle
    [2NX_interleaved_DANIEL_EDIT.dip, 2NX_interleaved_EAGLE_IMPORT.dch, 2NX_interleaved_SAGAR.dip]
2018-11-20 some more dipress
    basically the final edits, before creating gerber files
    [2NX_interleaved_DANIEL_EDIT.dip, 2nx_IEEE PEMC_2016.dip]
2018-11-20 Gerber files
    just exported all layers possible, packaged into zip.
    also the question png (no answer yet, will ask Henry)
    [BoardOutline.gbr, Bottom.gbr, BottomAssy.gbr, BottomDimension.gbr, BottomMask.gbr, BottomPaste.gbr, BottomSilk.gbr, Top.gbr]
2018-11-21 added pcb design chapter
    empty currently
2018-11-21 a little bit about PCB
2018-11-21 more gerber files
    [Plated_Through.gbr]
2018-11-21 wrote about pcb design
    only about my own work, not about good collaboration with sugar
    [2NX_interleaved_boost_converter.brd]
2018-11-22 more gerber files
    rest is fine
    [2nx_interleaved_DANIEL_EDIT_dip2eagle.brd, 2nx_interleaved_dip2eagle_ERROR.brd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]
2018-11-22 little bittle on pcb
2018-11-23 pcb writing
2018-11-23 a little bit of work in dipriss
    [2NX_interleaved_DANIEL_EDIT.dip]
2018-11-23 3level 2nx in eagle
    most things need to be replaced with proper dimensions
    caps supposed to be round, inductor with a jumper
    heatsinks
    correct plugs
    [3level_2NX_interleaved_boost_converter.brd, 3level_2NX_interleaved_boost_converter.sch]
2018-11-26 Writning switched inductor, SubFig construct done
2018-11-26 Driver figure and solar text
2018-11-26 3 stage pcb done
    want to look over it tomorrow, can probably be sent, but am not sure about the bobbin spacing
    [3level_2NX_interleaved_boost_converter.brd, 3level_2NX_interleaved_boost_converter.sch]
2018-11-27 GERBER
    board should have the correct size now
    [3level_2NX_interleaved_boost_converter.brd]
2018-11-27 some pdfs of circuits
    [3level_2NX_interleaved_boost_converter.sch]
2018-11-28 merging file conflicts
    [3level_2NX_interleaved_boost_converter.brd]
2018-11-28 Diode datasheet
2018-12-06 More to NxMBC + diagrams for el report
2018-12-06 Spice with other diodes
2018-12-07 Idk smth about voltage drops
2018-12-10 Added PWM Pattern
2018-12-10 PWM Pattern Figure
2018-12-10 Added stuff to mosfet
2018-12-10 Mosfet Spice model guide
    More spam
2018-12-11 Additions to MBC and 2Nx
    Voltage gains table added
2018-12-11 CVTL BC
    changed pwm to vertical
2018-12-14 voltage ripple
2018-12-14 All the crap you can imagine
    [Calculated_Measured.xlsx]
